rapidanalysis/xerxes/Images/3D Model 3.png

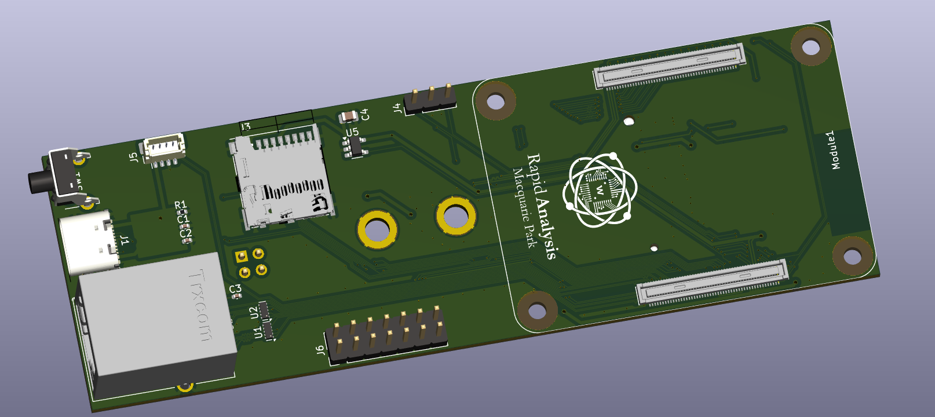
Images/3D Model 3.png
