rapidanalysis/xerxes/Images/3D Model.png

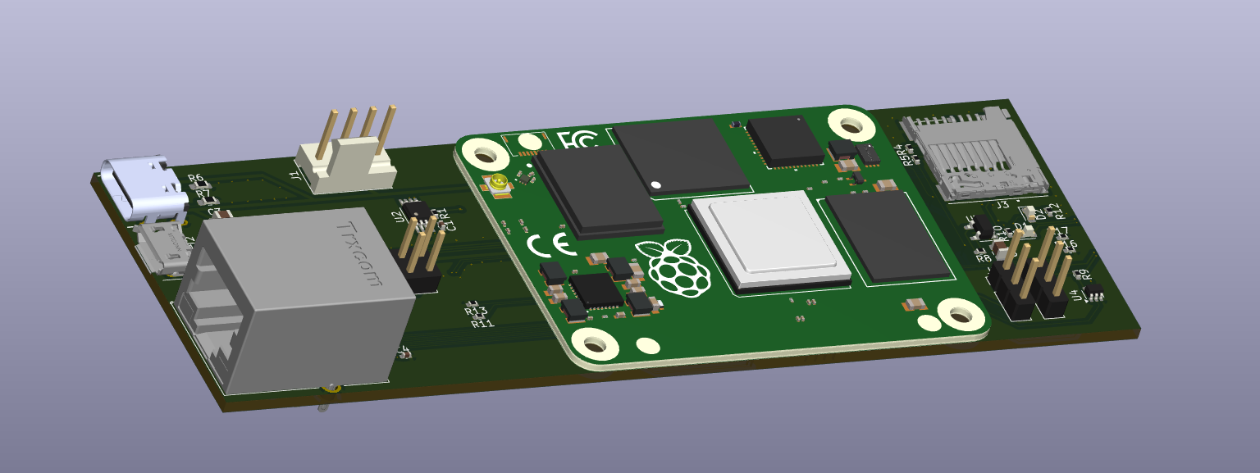
Images/3D Model.png
