rapidanalysis/xerxes/CM4-Baseline/README.md

# blade
Kicad files for the Raspberry Pi CM4 blade design PCB.
