rapidanalysis/xerxes/Images/3D Model 2.png

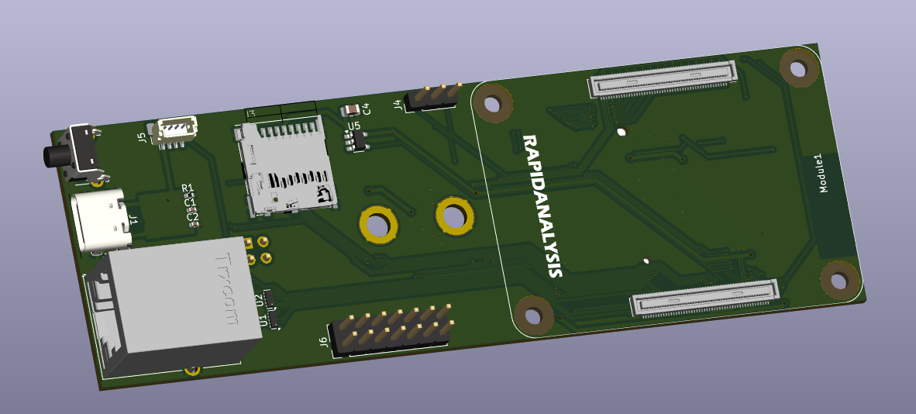
Images/3D Model 2.png
