rapidanalysis/xerxes/Images/Blade Carrier Board/RayTracing White BG/NEW/Bottom.png

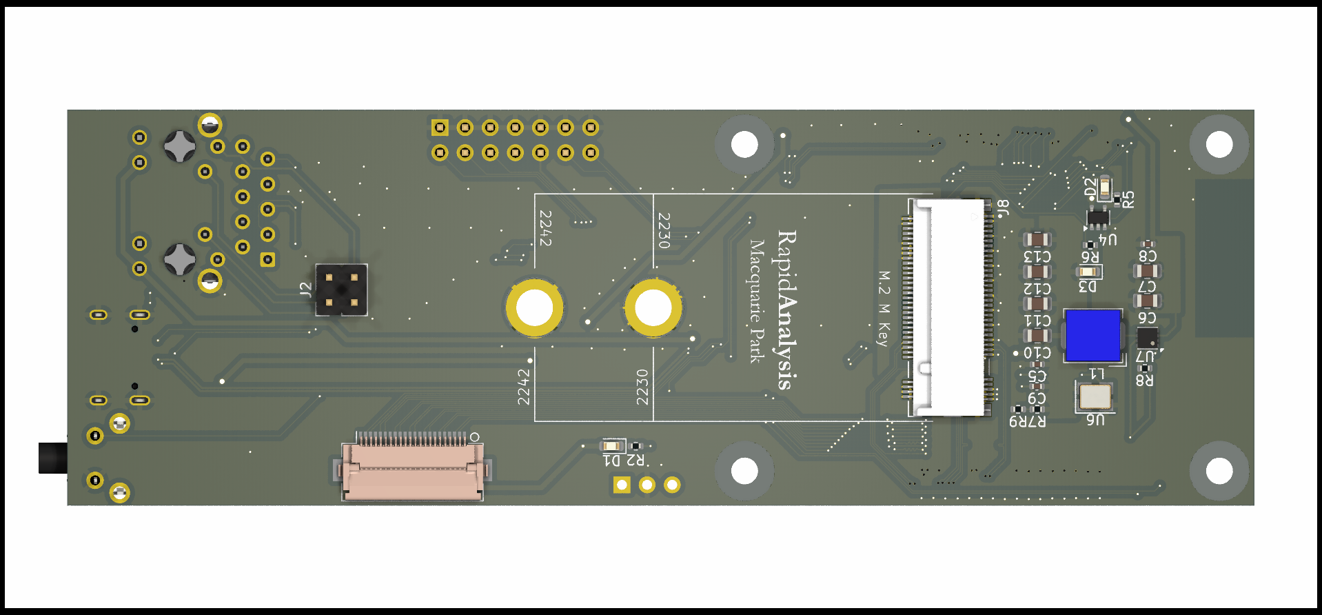
Images/Blade Carrier Board/RayTracing White BG/NEW/Bottom.png
