rapidanalysis/xerxes/Images/Blade Carrier Board/RayTracing White BG/NEW/Front.png

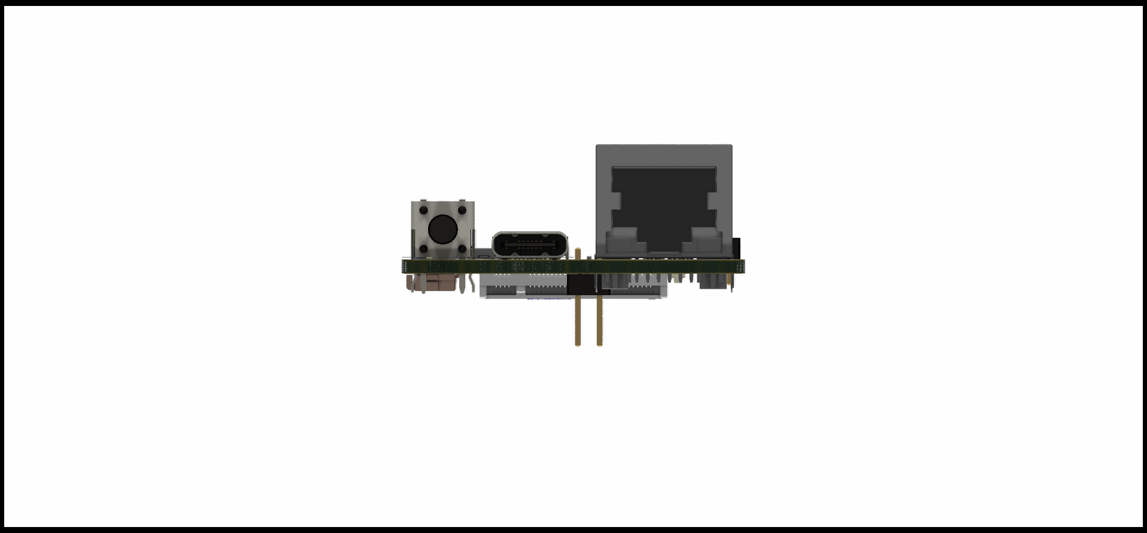
Images/Blade Carrier Board/RayTracing White BG/NEW/Front.png
