rapidanalysis/xerxes/Images/Blade Carrier Board/RayTracing White BG/NEW/Isometric Bottom.png

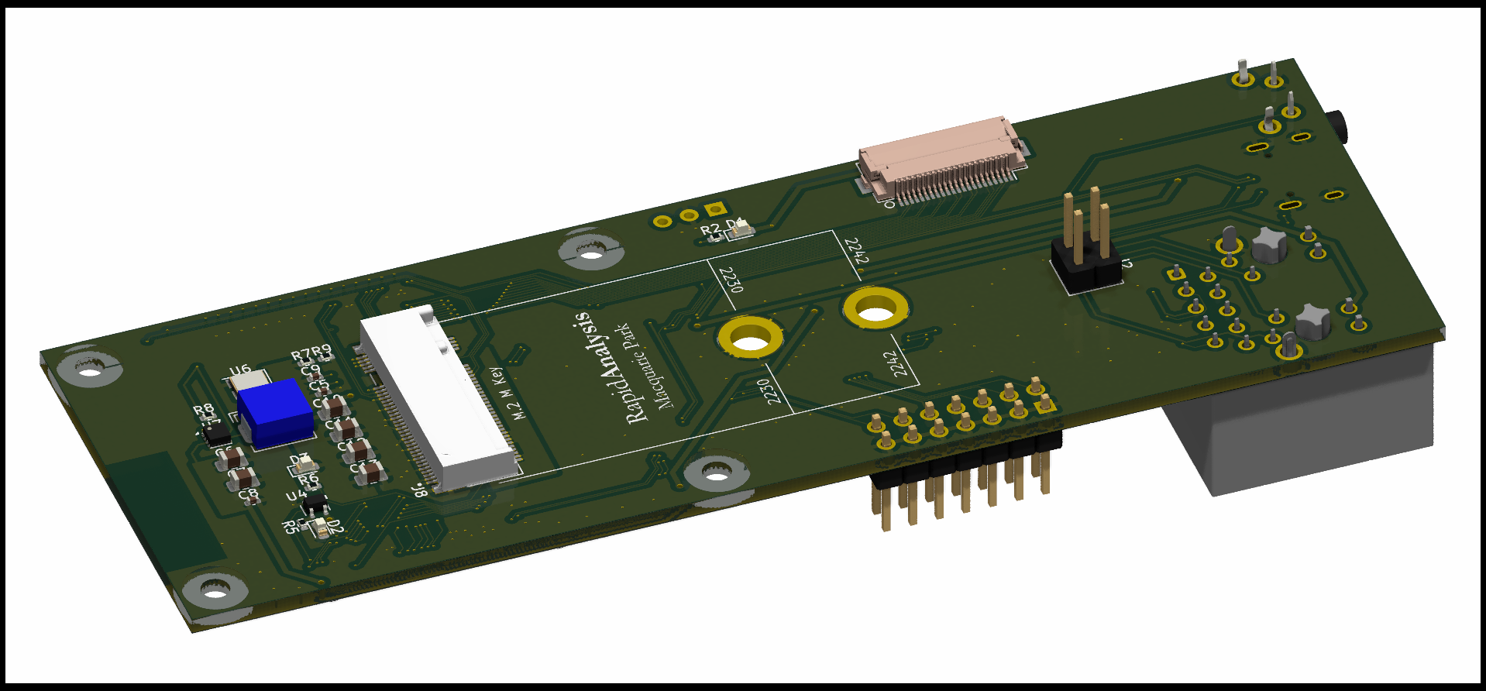
Images/Blade Carrier Board/RayTracing White BG/NEW/Isometric Bottom.png
