rapidanalysis/xerxes/Images/Blade Carrier Board/RayTracing White BG/NEW/Isometric Top.png

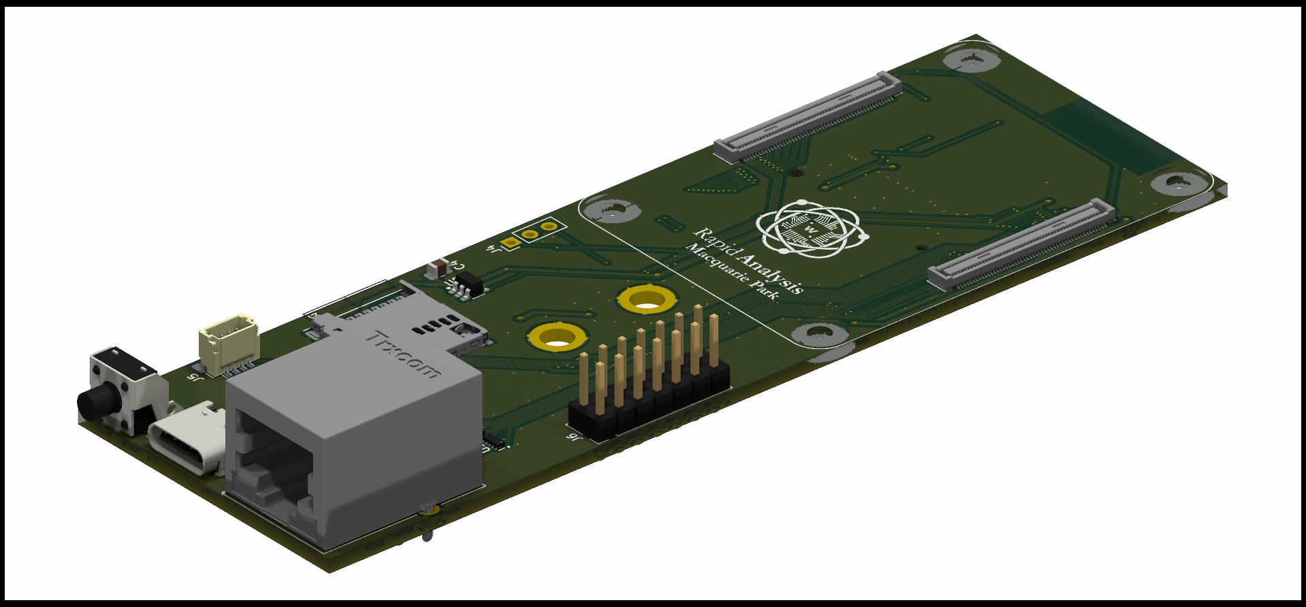
Images/Blade Carrier Board/RayTracing White BG/NEW/Isometric Top.png
