rapidanalysis/xerxes/Images/Blade Carrier Board/RayTracing White BG/NEW/Side.png

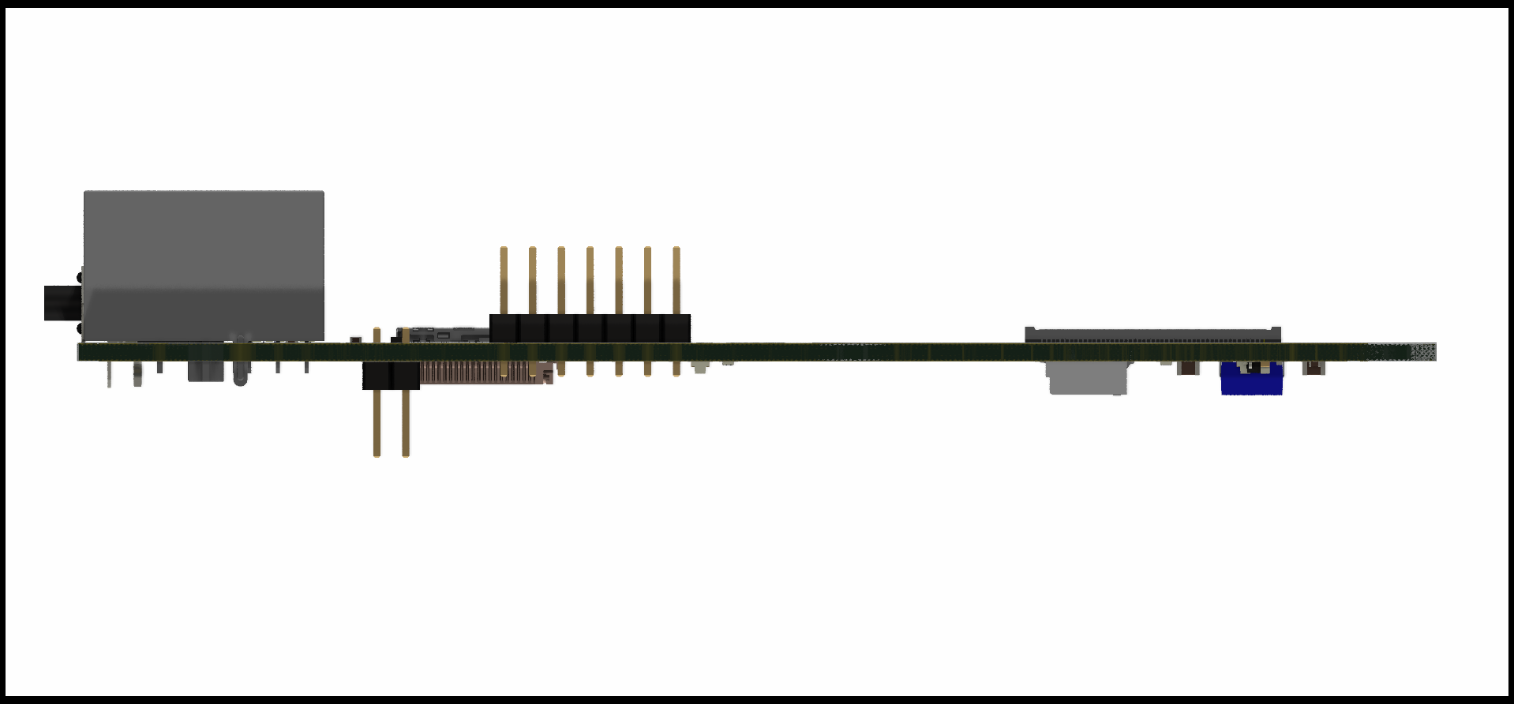
Images/Blade Carrier Board/RayTracing White BG/NEW/Side.png
