rapidanalysis/xerxes/Images/Blade Carrier Board/RayTracing White BG/NEW/Top.png

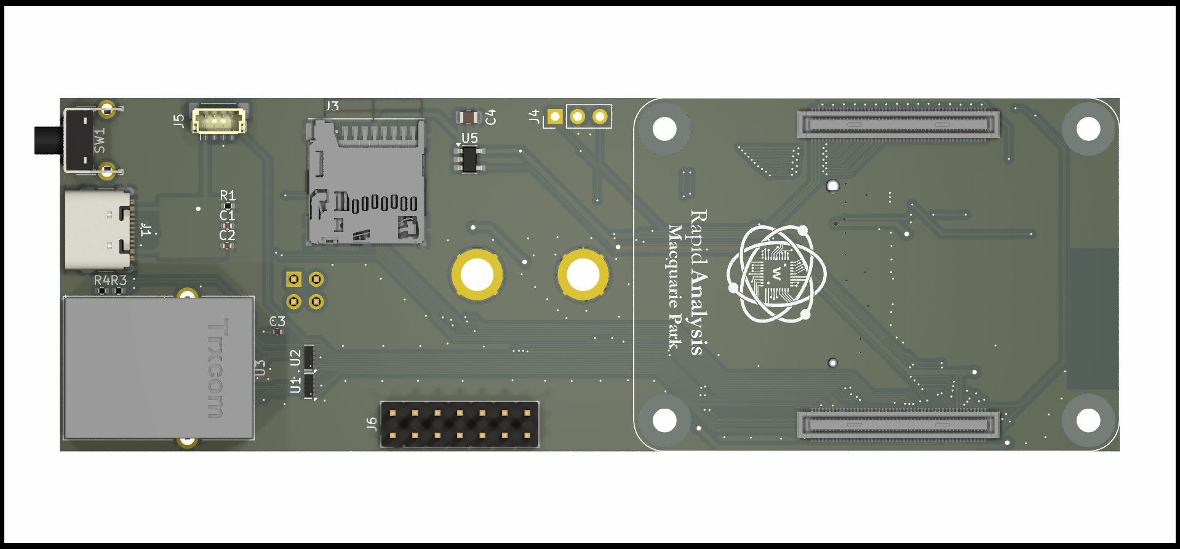
Images/Blade Carrier Board/RayTracing White BG/NEW/Top.png
