rapidanalysis/xerxes/Images/Blade Carrier Board/RayTracing White BG/Raytracing Transparent BG/Bottom.png

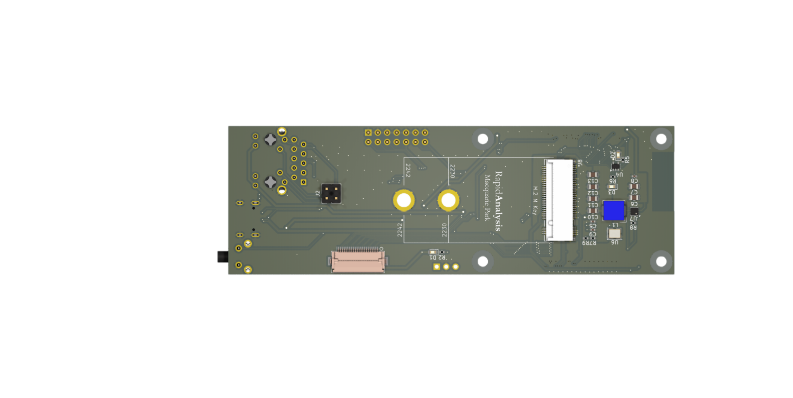
Images/Blade Carrier Board/RayTracing White BG/Raytracing Transparent BG/Bottom.png
