rapidanalysis/xerxes/Images/Blade Carrier Board/RayTracing White BG/Raytracing Transparent BG/Front.png

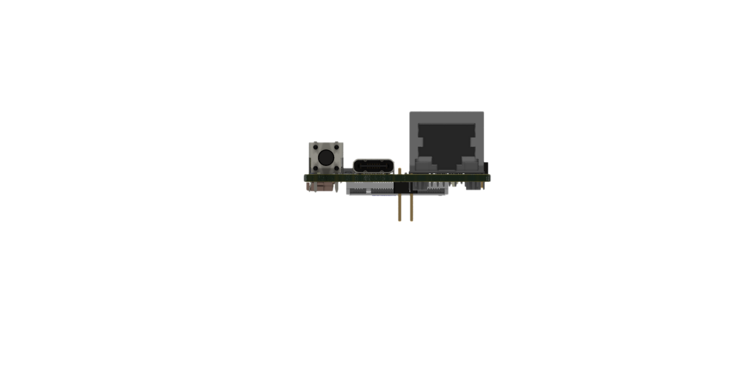
Images/Blade Carrier Board/RayTracing White BG/Raytracing Transparent BG/Front.png
