rapidanalysis/xerxes/Images/Blade Carrier Board/RayTracing White BG/Raytracing Transparent BG/Isometric Bottom.png

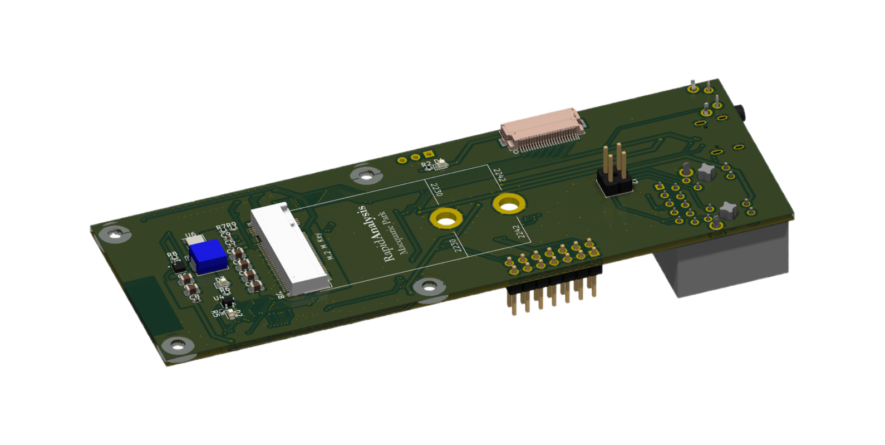
Images/Blade Carrier Board/RayTracing White BG/Raytracing Transparent BG/Isometric Bottom.png
