rapidanalysis/xerxes/Images/Blade Carrier Board/RayTracing White BG/Raytracing Transparent BG/Isometric Top.png

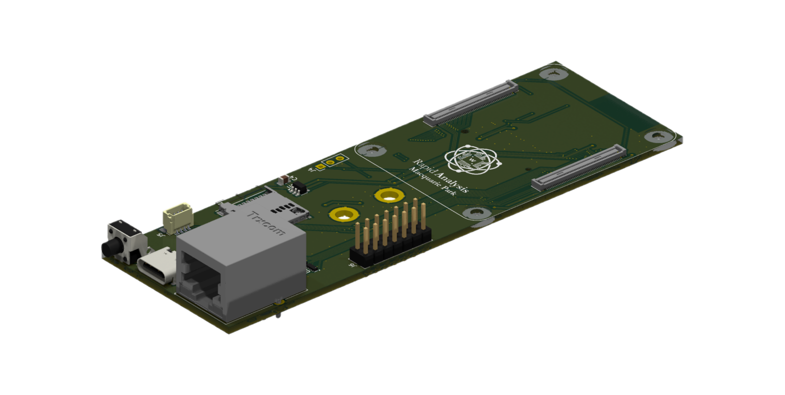
Images/Blade Carrier Board/RayTracing White BG/Raytracing Transparent BG/Isometric Top.png
