rapidanalysis/xerxes/Images/Blade Carrier Board/RayTracing White BG/Raytracing Transparent BG/Side.png

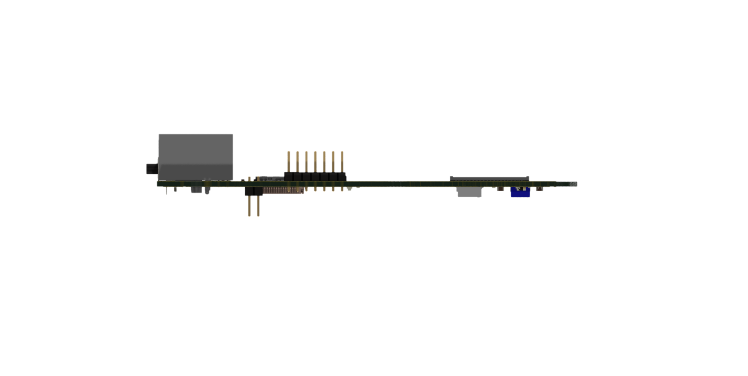
Images/Blade Carrier Board/RayTracing White BG/Raytracing Transparent BG/Side.png
