rapidanalysis/xerxes/Images/Blade Carrier Board/RayTracing White BG/Raytracing Transparent BG/Top.png

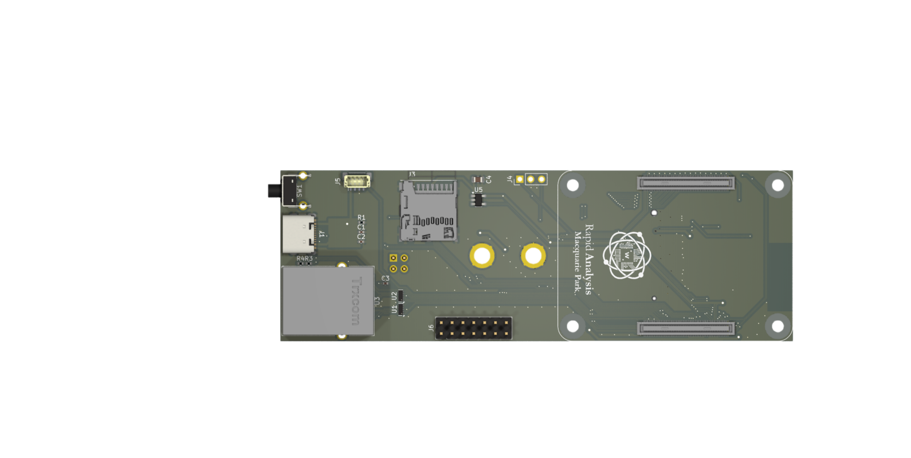
Images/Blade Carrier Board/RayTracing White BG/Raytracing Transparent BG/Top.png
