rapidanalysis/xerxes/Images/Dimensions.png

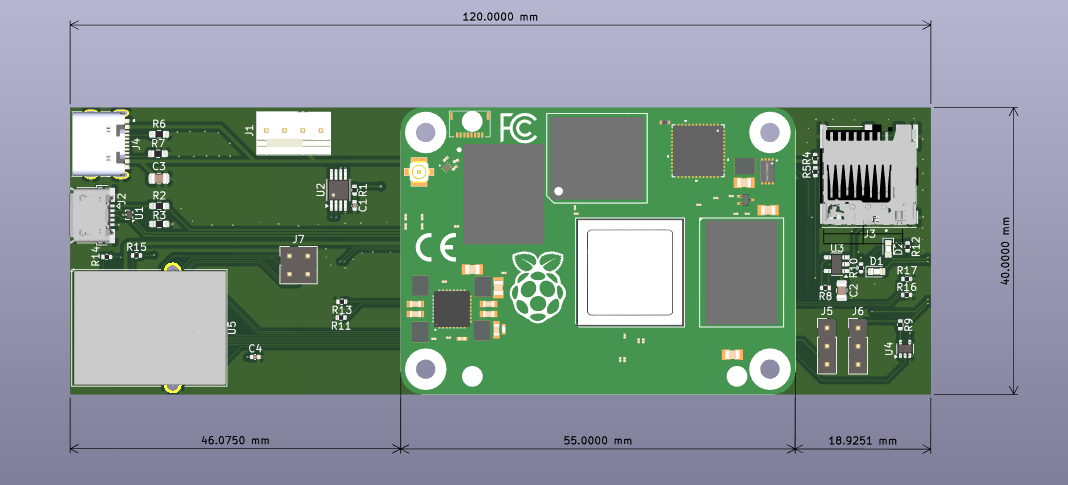
Images/Dimensions.png
