rapidanalysis/xerxes/Images/graphics.png

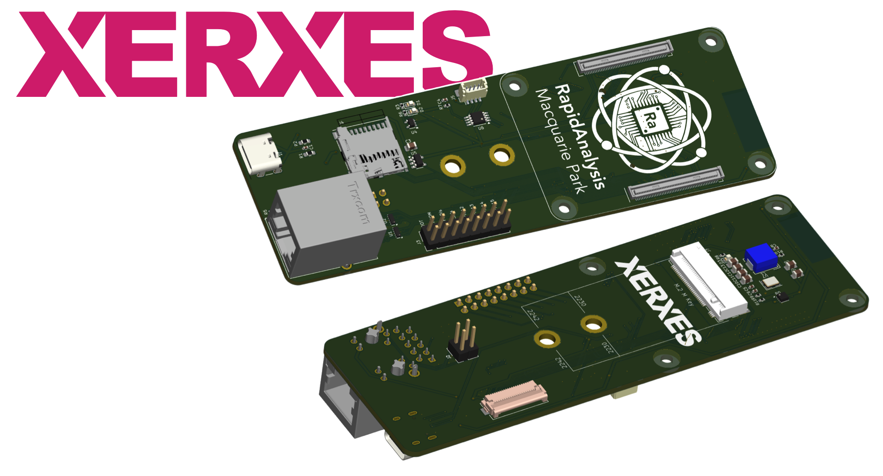
Images/graphics.png
