rapidanalysis/xerxes/Images/kicad.png

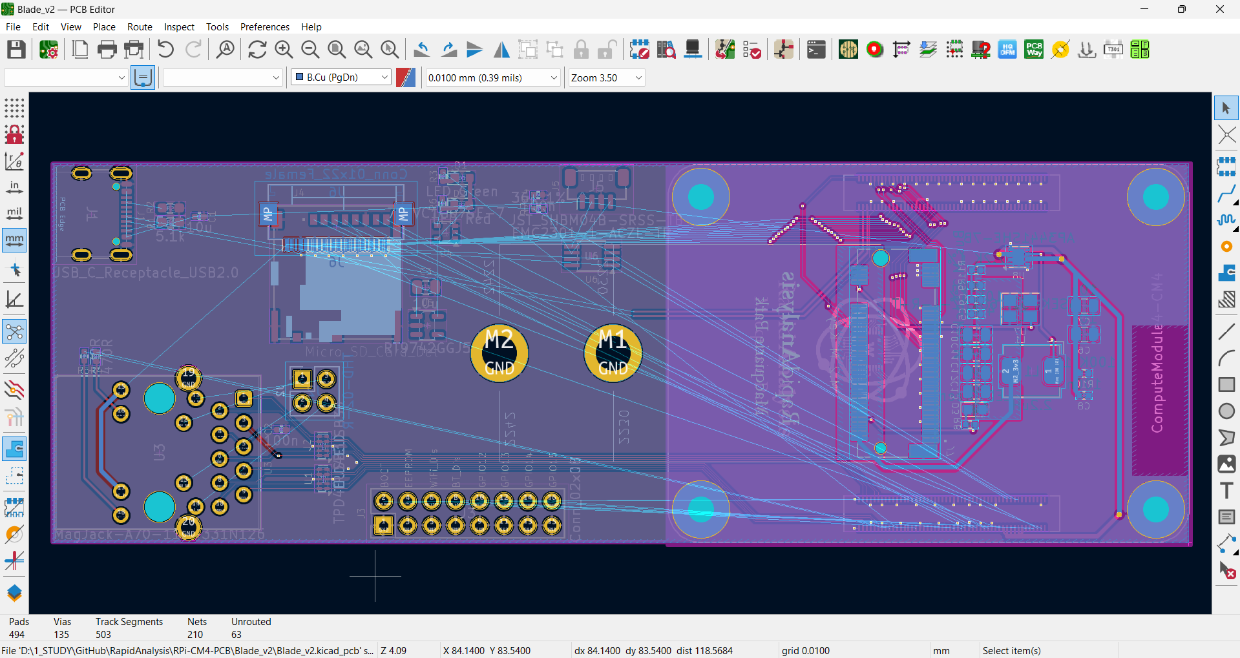
Images/kicad.png
