rapidanalysis/xerxes/Xerxes/production/JLC/bom-JLCPCB Assembly Order.xls

JLCPCB BOM Tool - BOM Matching
BOM name：bom-JLCPCB Assembly Order.xlsx |  |  | Download Time：2025-12-12 11:15:52 |  |  |  | * Our matching results are updated in real-time, but stock and prices may change. If it's been over 24 hours, please re-match before placing your order.
PCB Assembled Qty：5 |  |  | Est. Total Price：60.6161
Your BOM |  |  |  |  | Matched Parts |  |  |  |  |  |  | Order Information
Top Designator | Bottom Designator | Comment | Footprint | JLCPCB Part # | Matches | Part # | Manufacturer | Footprint | Description | Category | Warning | JLCPCB Part # | Product link | Lib Type | Qty | Source | Total Price ($)
C3 |  | 16SVPK220M | CAP_16SVPK220M |  | Select by System | 16SVPK220M | PANASONIC | SMD,D6.3xL6mm | -55℃~+125℃ 1000hrs@125℃ 16V 220uF 22mΩ 52mA@120Hz 6.3mm 6mm Polymer ±20% SMD,D6.3xL6mm Polymer Aluminum Capacitors ROHS | Polymer Aluminum Capacitors |  | C542293 | https://jlcpcb.com/partdetail/PANASONIC-16SVPK220M/C542293 | Extended | 5 | 5 JLCPCB | 2.505
 | C9 | 4.7nF | 0402 |  | Select by System | 0402B472K500NT | FH (Guangdong Fenghua Advanced Tech) | 0402 | 4.7nF 50V X7R ±10% 0402 Multilayer Ceramic Capacitors MLCC - SMD/SMT ROHS | Multilayer Ceramic Capacitors MLCC - SMD/SMT |  | C1538 | https://jlcpcb.com/partdetail/1890-0402B472K500NT/C1538 | Basic | 20 | 20 JLCPCB | 0.022
C2 | C1,C10,C11,C12,C13,C6,C7 | 10uF | 0805 |  | Select by System | CL21A106KAYNNNE | Samsung Electro-Mechanics | 0805 | 10uF 25V X5R ±10% 0805 Multilayer Ceramic Capacitors MLCC - SMD/SMT ROHS | Multilayer Ceramic Capacitors MLCC - SMD/SMT |  | C15850 | https://jlcpcb.com/partdetail/16532-CL21A106KAYNNNE/C15850 | Basic | 65 | 65 JLCPCB | 0.637
C4 | C5,C8 | 100nF | 0402 |  | Select by System | CL05B104KO5NNNC | Samsung Electro-Mechanics | 0402 | 100nF 16V X7R ±10% 0402 Multilayer Ceramic Capacitors MLCC - SMD/SMT ROHS | Multilayer Ceramic Capacitors MLCC - SMD/SMT |  | C1525 | https://jlcpcb.com/partdetail/1877-CL05B104KO5NNNC/C1525 | Basic | 40 | 40 JLCPCB | 0.048
CONN1 |  | ComputeModule5GPIOrail | CONN_DF40C-100DS-0.4V51_HIR |  | Unconfirmed | DF40C-100DS-0.4V(51) | HRS(Hirose) | SMD,P=0.4mm | -35℃~+85℃ 0.4mm 100P 2 300mA Gold Slot Type Butting Surface Mount,Vertical SMD,P=0.4mm Board-to-Board and Backplane Connector ROHS | Board-To-Board And Backplane Connector | 1.Multiple lines in the BOM have been matched to the same part. Please check if the matching is correct. ; | C597931 | https://jlcpcb.com/partdetail/HRS_Hirose-DF40C_100DS_0_4V_51/C597931 | Extended | 10 | 10 JLCPCB | 7.44
CONN2 |  | ComputeModule5HighSpeedrail | CONN_DF40C-100DS-0.4V51_HIR |  | Unconfirmed | DF40C-100DS-0.4V(51) | HRS(Hirose) | SMD,P=0.4mm | -35℃~+85℃ 0.4mm 100P 2 300mA Gold Slot Type Butting Surface Mount,Vertical SMD,P=0.4mm Board-to-Board and Backplane Connector ROHS | Board-To-Board And Backplane Connector | 1.Multiple lines in the BOM have been matched to the same part. Please check if the matching is correct. ; | C597931 | https://jlcpcb.com/partdetail/HRS_Hirose-DF40C_100DS_0_4V_51/C597931 | Extended | 10 | 10 JLCPCB | 7.44
D2 |  | LEDRed | 0603 |  | Select by System | KT-0603R | Hubei KENTO Elec | 0603 | -40℃~+85℃ 120° 2.4V 20mA 300mcd 40mW 615nm~630nm 645nm Red Water Clear 0603 LED Indication - Discrete ROHS | LED Indication - Discrete |  | C2286 | https://jlcpcb.com/partdetail/Hubei_KENTOElec-KT0603R/C2286 | Basic | 20 | 20 JLCPCB | 0.112
 | D4,D5 | MB6S | TO-269AA |  | Select by System | MB6S | Shikues | MBS | -55℃~+150℃ 1.1V@0.8A 30A 5uA@600V 600V 800mA Single-Phase Rectifier MBS Bridge Rectifiers ROHS | Bridge Rectifiers |  | C110220 | https://jlcpcb.com/partdetail/Shikues-MB6S/C110220 | Extended | 11 | 11 JLCPCB | 0.2442
 | D6 | SMAJ58A | D_SMA |  | Select by System | SMAJ58A | RUILON(Shenzhen Ruilongyuan Elec) | DO-214AC(SMA) | -55℃~+150℃ 1uA 4.3A 400W@10/1000us 58V 74.1V 93.6V IEC 61000-4-2 TVS Unidirectional DO-214AC(SMA) ESD and Surge Protection (TVS/ESD) ROHS | ESD And Surge Protection (TVS/ESD) |  | C10762 | https://jlcpcb.com/partdetail/11306-SMAJ58A/C10762 | Extended | 9 | 9 JLCPCB | 0.6183
D3 | D1 | LEDGreen | 0603 |  | Unconfirmed | XL-1608UGC-04 | XINGLIGHT | 0603 | -40℃~+85℃ 120° 20mA 3.3V 515nm~535nm 525nm 70mW 810mcd Discrete Diode Emerald Green Water Clear op View Mount 0603 LED Indication - Discrete ROHS | LED Indication - Discrete | 1.The comment (XL-1608UGC-04) of this part does not match the one (LEDGreen) provided in your BOM. Please confirm; | C965804 | https://jlcpcb.com/partdetail/XINGLIGHT-XL_1608UGC04/C965804 | Extended | 40 | 40 JLCPCB | 0.176
 | J1 | Micro_SD_Card_Det | SDCARD_MOLEX_503398-1892 |  | Select by System | 5033981892 | MOLEX | SMD | -25℃~+85℃ 1.28mm Connector and Ejector MicroSD Card (TF Card) Push-Push SMD SD Card / Memory Card Connector ROHS | SD Card / Memory Card Connector |  | C428492 | https://jlcpcb.com/partdetail/MOLEX-5033981892/C428492 | Extended | 5 | 5 JLCPCB | 4.4475
J2 |  | USB_C_Receptacle_USB2.0_16P | USB4205-GF-A |  | Select by System | TYPEC-305-ACP16 | XUNPU | SMD | -55℃~+85℃ 1 10000 Cycles 14mm 16P 5A Black Female Side View Mount Type-C USB 3.1 SMD USB Connectors ROHS | USB Connectors |  | C920227 | https://jlcpcb.com/partdetail/XUNPU-TYPEC_305ACP16/C920227 | Extended | 5 | 5 JLCPCB | 2.955
 | J3 | Bus_M.2_Socket_M | M.2MKeysocket |  | Select by System | 91302-32-067RDM | UMAX | SMD,P=0.5mm,卧贴 | 3.2mm 67P Female M.2-M Key Surface Mount, Right Angle with locating pin SMD,P=0.5mm,Surface Mount，Right Angle Hard Disk Connector (SAS/SATA/M.2) ROHS | Edgeboard Connectors |  | C1509730 | https://jlcpcb.com/partdetail/UMAX-91302_32067RDM/C1509730 | Extended | 5 | 5 JLCPCB | 7.8675
J6,J7 |  | BM04B-SRSS-TBLFSN | JST_SH_BM04B-SRSS-TB_1x04-1MP_P1.00mm_Vertical |  | Select by System | BM04B-SRSS-TB(LF)(SN) | JST | SMD,P=1mm | -25℃~+85℃ 1 1A 1mm 1x4P 3.6mm 4 4.25mm 4P 50V 6mm Auxiliary Solder Pin Copper Alloy PA SR Surface Mount,Vertical Tin UL94V-0 White SMD,P=1mm Wire To Board Connector ROHS | Wire To Board Connector |  | C160390 | https://jlcpcb.com/partdetail/JST-BM04B_SRSS_TB_LF_SN/C160390 | Extended | 10 | 10 JLCPCB | 2.159
J8 |  | BM03B-SRSS-TBLFSN | JST_SH_BM03B-SRSS-TB_1x03-1MP_P1.00mm_Vertical |  | Select by System | BM03B-SRSS-TB(LF)(SN) | JST | SMD,P=1mm | -25℃~+85℃ 1 1A 1mm 1x3P 3 3.6mm 3P 4.25mm 50V 5mm Auxiliary Solder Pin Copper Alloy PA SH Surface Mount,Vertical Tin UL94V-0 White SMD,P=1mm Wire To Board Connector ROHS | Wire To Board Connector |  | C160389 | https://jlcpcb.com/partdetail/JST-BM03B_SRSS_TB_LF_SN/C160389 | Extended | 5 | 5 JLCPCB | 1.0855
J9 |  | BM06B-SRSS-TBLFSN | CONN_BM06B-SRSS-TB_JST |  | Select by System | BM06B-SRSS-TB(LF)(SN) | JST | SMD,P=1mm | -25℃~+85℃ 1 1A 1mm 1x6P 3.6mm 4.25mm 50V 6 6P 8mm Auxiliary Solder Pin Copper Alloy PA SH Surface Mount,Vertical Tin UL94V-0 White SMD,P=1mm Wire To Board Connector ROHS | Wire To Board Connector |  | C160392 | https://jlcpcb.com/partdetail/JST-BM06B_SRSS_TB_LF_SN/C160392 | Extended | 5 | 5 JLCPCB | 1.524
 | J10 | DF40HC(4.0)-50DS-0.4V(51) | HRS_DF40HC_4.0_-50DS-0.4V_51_ |  | Select by System | DF40HC(4.0)-50DS-0.4V(51) | HRS(Hirose) | SMD,P=0.4mm | 0.4mm 2 50P Gold Slot Type Butting Surface Mount,Vertical SMD,P=0.4mm Board-to-Board and Backplane Connector ROHS | Board-To-Board And Backplane Connector |  | C5338326 | https://jlcpcb.com/partdetail/HRS_Hirose-DF40HC_4_0_50DS_0_4V_51/C5338326 | Extended | 5 | 5 JLCPCB | 8.025
 | L1 | 2.2uH | L_Bourns_SRP5030CC |  | Select by System | SMNR4020-2.2UH | SXN(Shun Xiang Nuo Elec) | SMD,4x4mm | 2.2uH 3.4A 3.4A 46mΩ ±20% SMD,4x4mm Power Inductors ROHS | Power Inductors |  | C135262 | https://jlcpcb.com/partdetail/146573-SMNR4020_22UH/C135262 | Extended | 9 | 9 JLCPCB | 0.4392
 | R2 | 12K1% | 0402 |  | Unconfirmed | FRC0402F1202TS | FOJAN | 0402 | -55℃~+155℃ 12kΩ 50V 62.5mW Thick Film Resistor ±1% ±100ppm/℃ 0402 Chip Resistor - Surface Mount ROHS | Chip Resistor - Surface Mount | 1.The comment (FRC0402F1202TS) of this part does not match the one (12K1%) provided in your BOM. Please confirm; | C2909316 | https://jlcpcb.com/partdetail/FOJAN-FRC0402F1202TS/C2909316 | Extended | 20 | 20 JLCPCB | 0.01
R6,R7 |  | 470R | 0402 |  | Unconfirmed | 0402WGF4700TCE | UNI-ROYAL(Uniroyal Elec) | 0402 | -55℃~+155℃ 470Ω 50V 62.5mW Thick Film Resistor ±1% ±100ppm/℃ 0402 Chip Resistor - Surface Mount ROHS | Chip Resistor - Surface Mount | 1.The comment (0402WGF4700TCE) of this part does not match the one (470R) provided in your BOM. Please confirm; | C25117 | https://jlcpcb.com/partdetail/25860-0402WGF4700TCE/C25117 | Basic | 20 | 20 JLCPCB | 0.012
 | R8 | 10K1% | 0402 |  | Unconfirmed | RHC-02K1002FT | FH (Guangdong Fenghua Advanced Tech) | 0402 | 10kΩ 50V 62.5mW Thick Film Resistor ±1% ±100ppm/℃ 0402 Chip Resistor - Surface Mount ROHS | Chip Resistor - Surface Mount | 1.The comment (RHC-02K1002FT) of this part does not match the one (10K1%) provided in your BOM. Please confirm; | C2936656 | https://jlcpcb.com/partdetail/3289238-RHC02K1002FT/C2936656 | Extended | 20 | 20 JLCPCB | 0.03
 | R9 | 100K1% | 0402 |  | Unconfirmed | RT0402FRE07100KL | YAGEO | 0402 | -55℃~+155℃ 100kΩ 50V 62.5mW Thin Film Resistor ±1% ±50ppm/℃ 0402 Chip Resistor - Surface Mount ROHS | Chip Resistor - Surface Mount | 1.The comment (RT0402FRE07100KL) of this part does not match the one (100K1%) provided in your BOM. Please confirm; | C728576 | https://jlcpcb.com/partdetail/YAGEO-RT0402FRE07100KL/C728576 | Extended | 20 | 20 JLCPCB | 0.146
R11,R12 | R13,R3 | 1k | 0402 |  | Unconfirmed | 0402WGF1001TCE | UNI-ROYAL(Uniroyal Elec) | 0402 | -55℃~+155℃ 1kΩ 50V 62.5mW Thick Film Resistor ±1% ±100ppm/℃ 0402 Chip Resistor - Surface Mount ROHS | Chip Resistor - Surface Mount | 1.The comment (0402WGF1001TCE) of this part does not match the one (1k) provided in your BOM. Please confirm; | C11702 | https://jlcpcb.com/partdetail/12256-0402WGF1001TCE/C11702 | Basic | 40 | 40 JLCPCB | 0.024
R14,R15 |  | 5.1k | 0603 |  | Unconfirmed | 0603WAF5101T5E | UNI-ROYAL(Uniroyal Elec) | 0603 | -55℃~+155℃ 100mW 5.1kΩ 75V Thick Film Resistor ±1% ±100ppm/℃ 0603 Chip Resistor - Surface Mount ROHS | Chip Resistor - Surface Mount | 1.The comment (0603WAF5101T5E) of this part does not match the one (5.1k) provided in your BOM. Please confirm; | C23186 | https://jlcpcb.com/partdetail/23913-0603WAF5101T5E/C23186 | Basic | 20 | 20 JLCPCB | 0.022
R1 | R10,R4,R5 | 2.2K1% | 0402 |  | Unconfirmed | FRC0402F2201TS | FOJAN | 0402 | -55℃~+155℃ 2.2kΩ 50V 62.5mW Thick Film Resistor ±1% ±100ppm/℃ 0402 Chip Resistor - Surface Mount ROHS | Chip Resistor - Surface Mount | 1.The comment (FRC0402F2201TS) of this part does not match the one (2.2K1%) provided in your BOM. Please confirm; | C2906865 | https://jlcpcb.com/partdetail/FOJAN-FRC0402F2201TS/C2906865 | Extended | 45 | 45 JLCPCB | 0.0225
 | U1 | RT9742GGJ5 | SOT-23-5 |  | Select by System | RT9742GGJ5 | Richtek Tech | TSOT-23-5 | -40℃~+85℃ 1 1A 2.7V~6V 70mΩ Active High High Side Switch Short-Circuit Protection(SCP) TSOT-23-5 Power Distribution Switches ROHS | Power Distribution Switches |  | C250547 | https://jlcpcb.com/partdetail/RichtekTech-RT9742GGJ5/C250547 | Extended | 5 | 5 JLCPCB | 0.6805
 | U2 | ASEK-32.768KHZ-L-R-T | Crystal_SMD_3225-4Pin_3.2x2.5mm |  | Select by System | ASEK-32.768KHZ-LRT | Abracon LLC | SMD3225-4P | -40℃~+85℃ 3.3V 3.5mA 32.768kHz CMOS ±25ppm SMD3225-4P Crystal Oscillators ROHS | Crystal Oscillators |  | C2650753 | https://jlcpcb.com/partdetail/AbraconLLC-ASEK_32_768KHZLRT/C2650753 | Extended | 5 | 5 JLCPCB | 9.105
 | U3 | AP3441SHE-7B | DFN-8-1EP_2x2mm_P0.5mm_EP1.05x1.75mm |  | Select by System | AP3441SHE-7B | Diodes Incorporated | DFN2020-8-EP | -40℃~+85℃@(TA) 1 1MHz 2.7V~5.5V 3A 55uA 600mV~5.5V Adjustable Buck Buck Built-In Yes DFN2020-8-EP DC-DC Converters ROHS | DC-DC Converters |  | C2070918 | https://jlcpcb.com/partdetail/DiodesIncorporated-AP3441SHE7B/C2070918 | Extended | 5 | 5 JLCPCB | 0.756
U5 |  | 74LVC1G07 | SOT-353_SC-70-5 |  | Select by System | 74LVC1G07 | Wuxi I-core Elec | SOT-353 | SOT-353 Buffers, Drivers, Receivers, Transceivers ROHS | Buffers, Drivers, Receivers, Transceivers |  | C5138996 | https://jlcpcb.com/partdetail/Wuxi_I_coreElec-74LVC1G07/C5138996 | Extended | 9 | 9 JLCPCB | 0.4689
U7,U8 |  | CDDFN10-3324P | USON-10_2.5x1.0mm_P0.5mm |  | Select by System | CDDFN10-3324P | BOURNS | DFN-10(1x2.5) | -55℃~+85℃ 0.04pF 100nA 3.3V 30W 4 4.5V 4A@8/20us 7.5V IEC 61000-4-2 TVS DFN-10(1x2.5) ESD and Surge Protection (TVS/ESD) ROHS | ESD And Surge Protection (TVS/ESD) |  | C913227 | https://jlcpcb.com/partdetail/BOURNS-CDDFN103324P/C913227 | Extended | 10 | 10 JLCPCB | 1.594
