rapidanalysis/xerxes/V1/Outputs/Schematics/cm4-bare-minimum.pdf

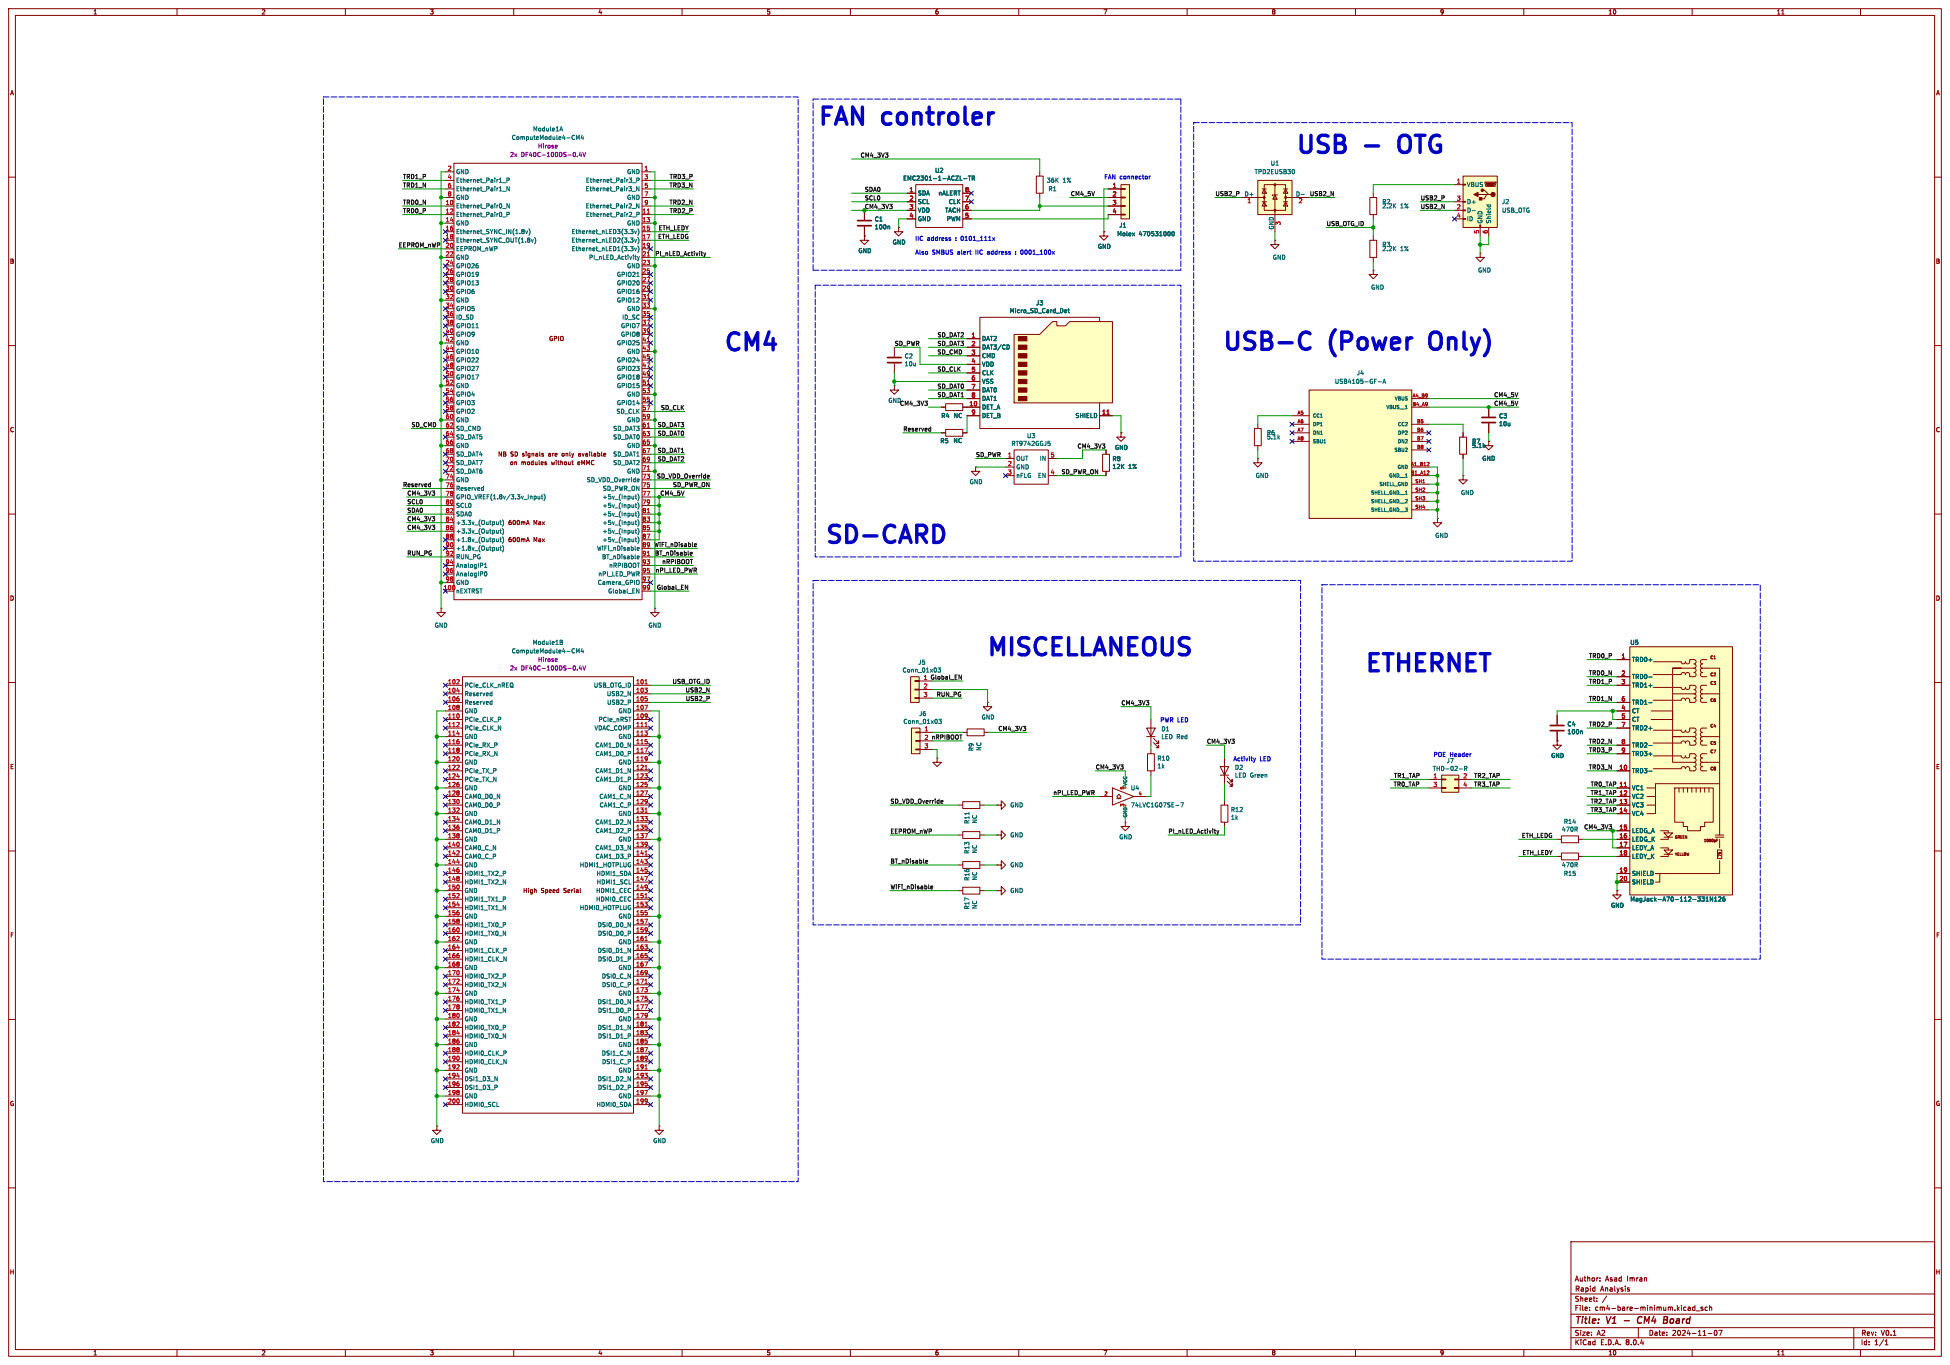
[picture p19: page 1]

Also SMBUS alert IIC address : 0001_100x

600mA Max 600mA Max NB SD signals are only available
