rapidanalysis/xerxes/Xerxes/Xerxes.kicad_pcb

## KiCad design Xerxes/Xerxes.kicad_pcb (2025-12-12)

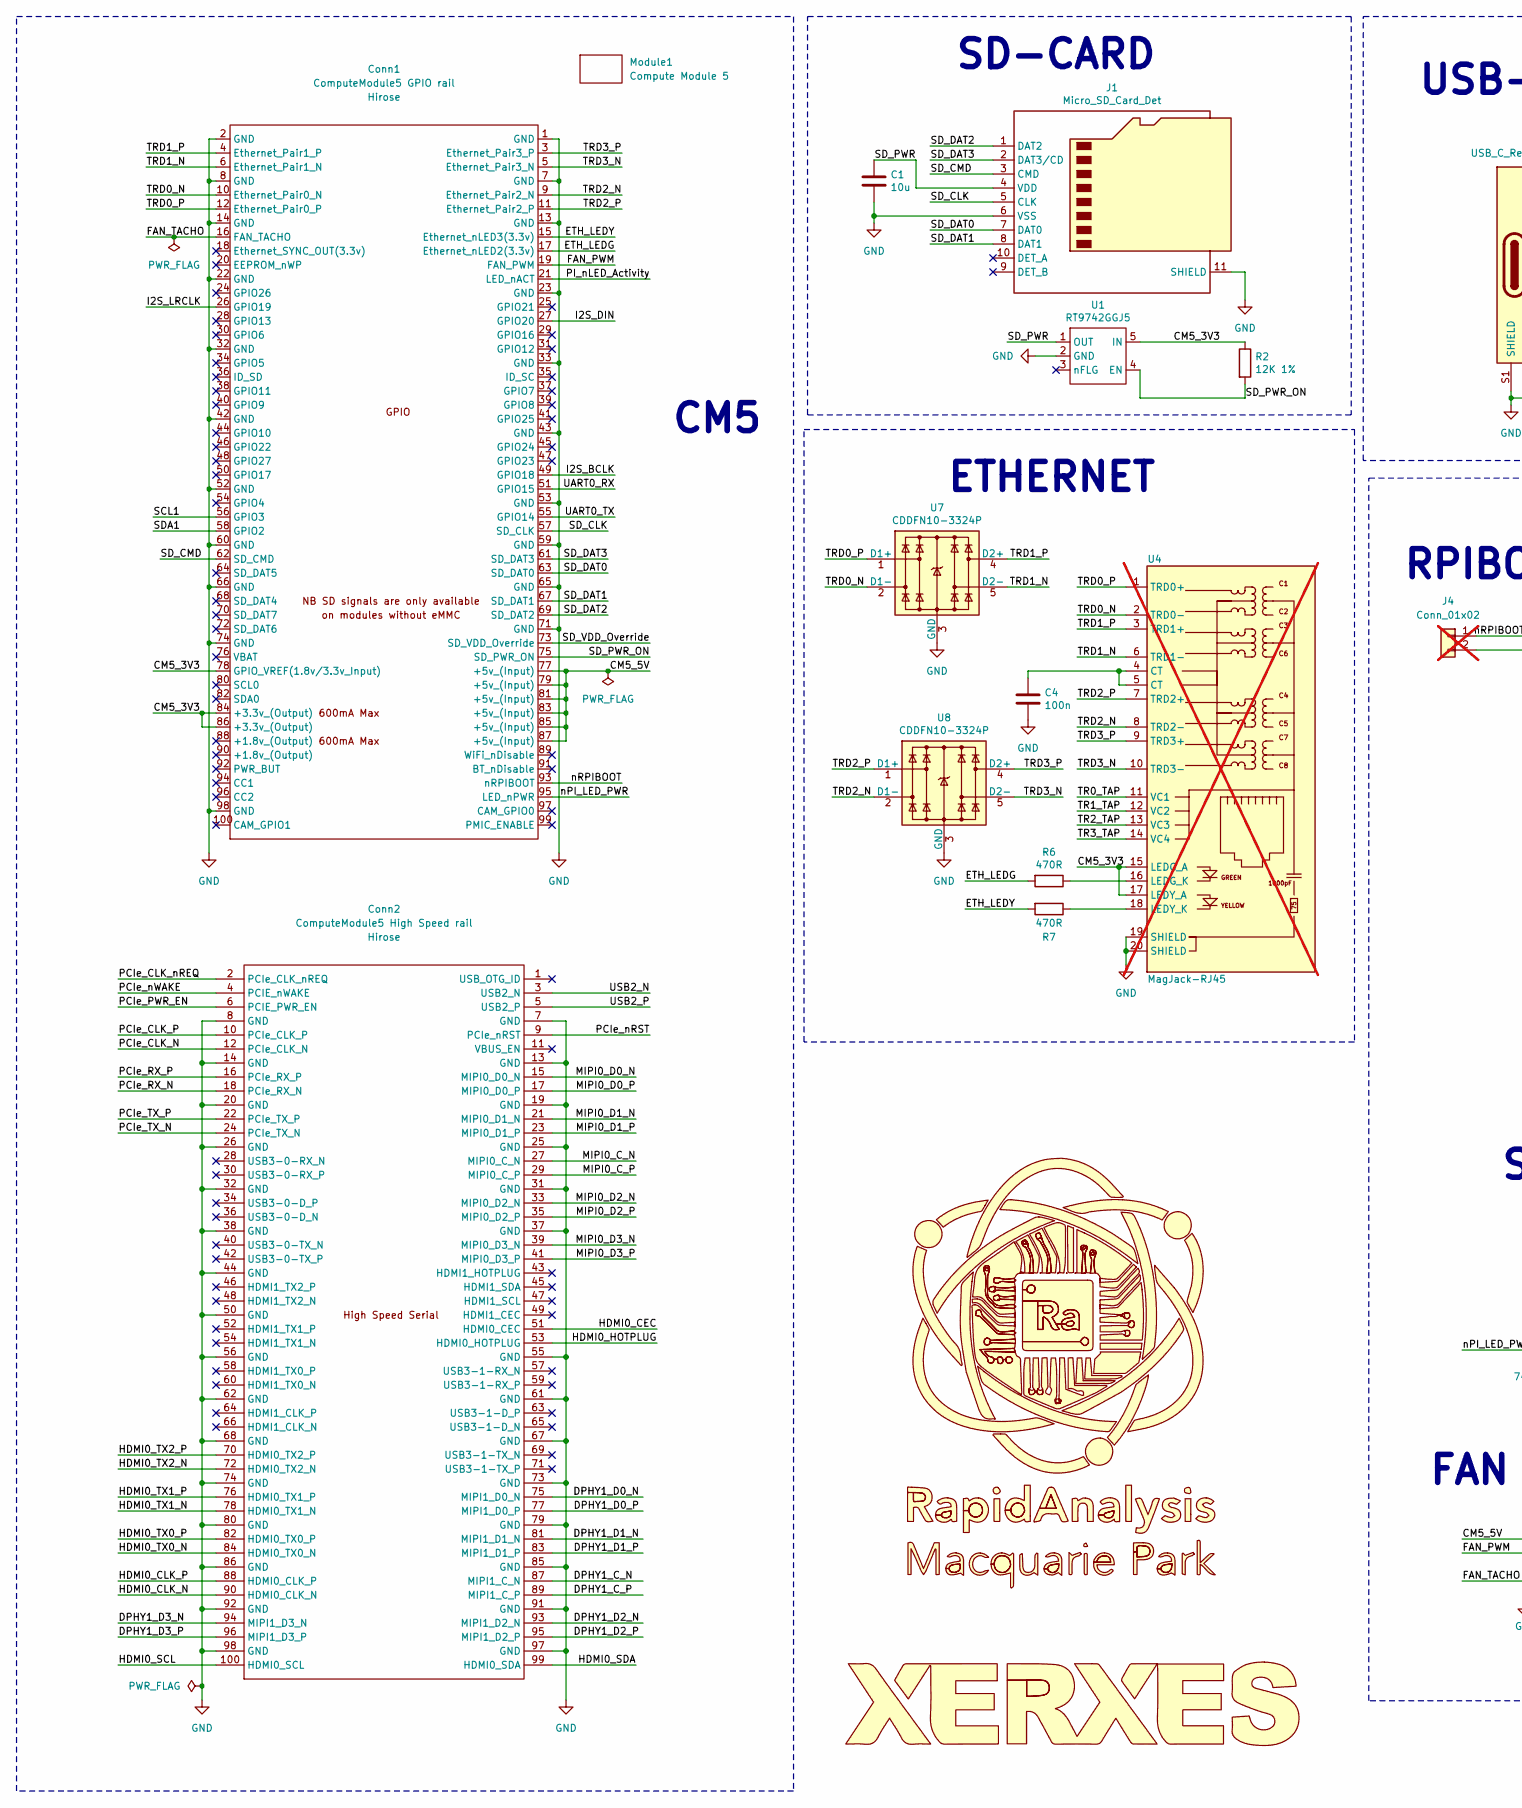
[picture p20: schematic Xerxes.kicad_sch, Xerxes-Pi, part in row 1, column 1]

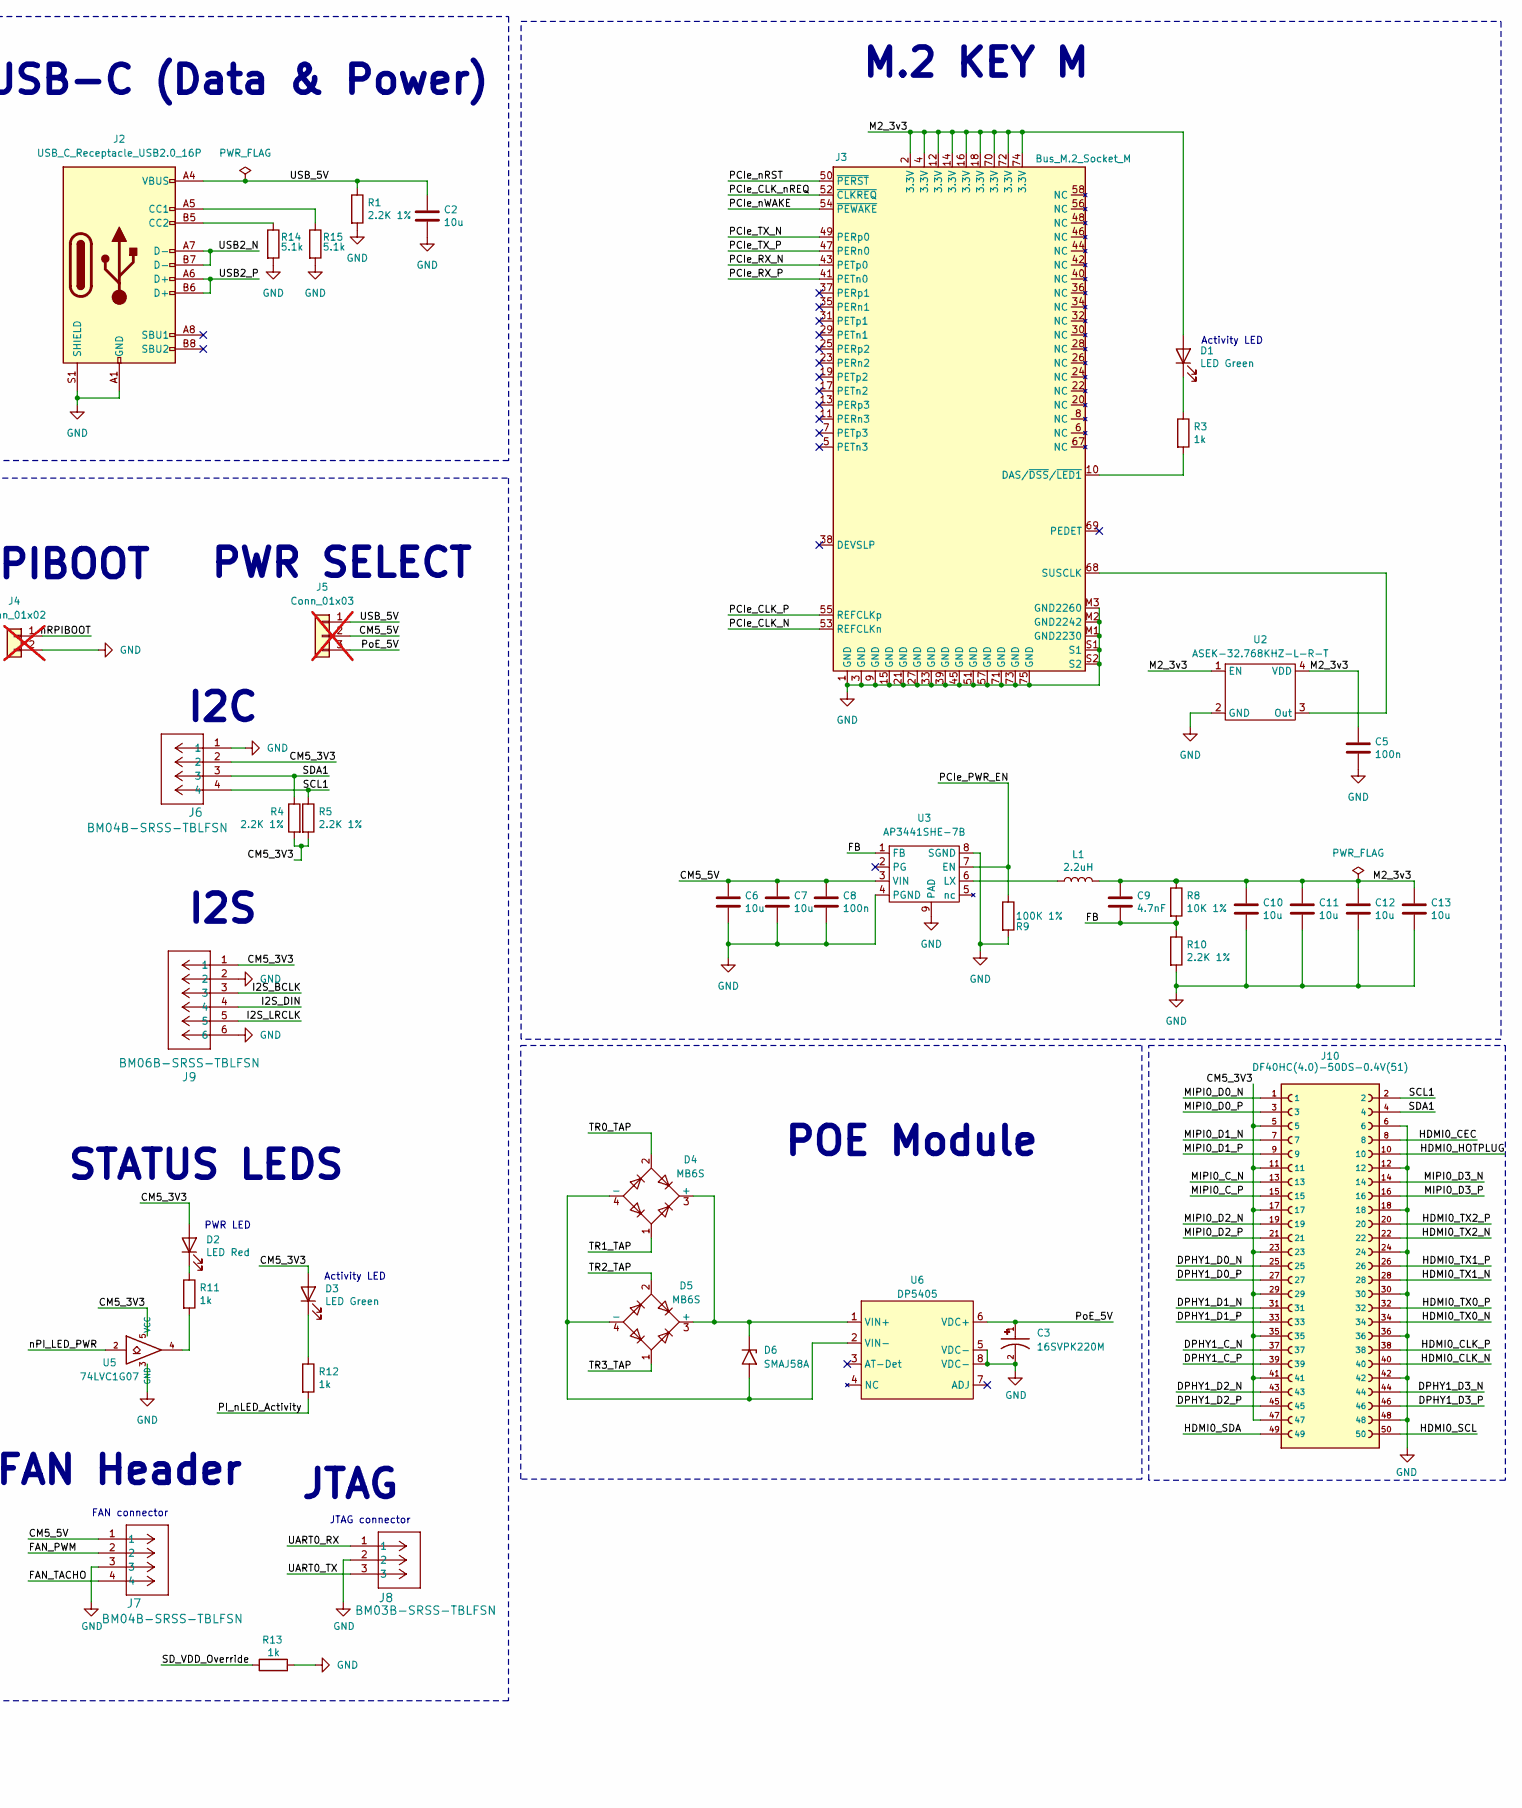
[picture p21: schematic Xerxes.kicad_sch, Xerxes-Pi, part in row 1, column 2]

Parts:
C1, C2, C6, C7, C10, C11, C12, C13: 10u; C_0805_2012Metric; MPN GRM21BR71A106KA73L
C3: 16SVPK220M; CAP_16SVPK220M; MPN 16SVPK220M
C4, C5, C8: 100n; C_0402_1005Metric; MPN EMK105B7104KV-F
C9: 4.7nF; C_0402_1005Metric; MPN CC0402KRX7R9BB472
Conn1: ComputeModule5 GPIO rail; CONN_DF40C-100DS-0.4V51_HIR; MPN DF40C-100DS-0.4V(51)
Conn2: ComputeModule5 High Speed rail; CONN_DF40C-100DS-0.4V51_HIR; MPN DF40C-100DS-0.4V(51)
D1, D3: LED Green; LED_0603_1608Metric; MPN LTST-C190GKT
D2: LED Red; LED_0603_1608Metric; MPN LTST-C190KRKT
D4, D5: MB6S; TO-269AA; MPN MB6S
D6: SMAJ58A; D_SMA; MPN SMAJ58A
J1: Micro_SD_Card_Det; SDCARD_MOLEX_503398-1892; MPN 5033981892
J2: USB_C_Receptacle_USB2.0_16P; USB4205-GF-A; MPN USB4205-GF-A
J3: Bus_M.2_Socket_M; M.2 M Key socket; MPN MDT320M03001
J4: Conn_01x02; PinHeader_1x02_P2.54mm_Vertical; MPN G800W306018EU; not fitted
J5: Conn_01x03; PinHeader_1x03_P2.54mm_Vertical; MPN G800W305018EU; not fitted
J6, J7: BM04B-SRSS-TBLFSN; JST_SH_BM04B-SRSS-TB_1x04-1MP_P1.00mm_Vertical; MPN BM04B-SRSS-TBLFSN
J8: BM03B-SRSS-TBLFSN; JST_SH_BM03B-SRSS-TB_1x03-1MP_P1.00mm_Vertical; MPN BM03B-SRSS-TBLFSN
J9: BM06B-SRSS-TBLFSN; CONN_BM06B-SRSS-TB_JST; MPN BM06B-SRSS-TBLFSN
J10: DF40HC(4.0)-50DS-0.4V(51); HRS_DF40HC_4.0_-50DS-0.4V_51_; MPN DF40HC(4.0)-50DS-0.4V(51)
L1: 2.2uH; L_Bourns_SRP5030CC; MPN SRP5030CC-2R2M
Module1: Compute Module 5; Raspberry-Pi-5-Compute-Module
R1, R4, R5, R10: 2.2K 1%; R_0402_1005Metric; MPN RC0402FR-072K2L
R2: 12K 1%; R_0402_1005Metric; MPN RC0402FR-0712KL
R3, R11, R12, R13: 1k; R_0402_1005Metric; MPN RC0402FR-071KL
R6, R7: 470R; R_0402_1005Metric; MPN RC0402FR-07470RL
R8: 10K 1%; R_0402_1005Metric; MPN RC0402FR-0710KL
R9: 100K 1%; R_0402_1005Metric; MPN RC0402FR-07100KL
R14, R15: 5.1k; R_0603_1608Metric; MPN RC0603FR-075K1L
Sym1: Xerxes_Logo
Sym2: RapidAnalysis_Logo
U1: RT9742GGJ5; SOT-23-5; MPN RT9742GGJ5
U2: ASEK-32.768KHZ-L-R-T; Crystal_SMD_3225-4Pin_3.2x2.5mm; MPN ASEK-32.768KHZ-L-R-T
U3: AP3441SHE-7B; DFN-8-1EP_2x2mm_P0.5mm_EP1.05x1.75mm; MPN AP3441SHE-7B
U4: MagJack-RJ45; TRJG0926HENL; MPN LPJG0926HENL; not fitted
U5: 74LVC1G07; SOT-353_SC-70-5; MPN 74LVC1G07
U6: DP5405
U7, U8: CDDFN10-3324P; USON-10_2.5x1.0mm_P0.5mm; MPN CDDFN10-3324P

Connections:
/CM5_3V3: Conn1.78 (GPIO_VREF(1.8v/3.3v_Input)), Conn1.84 (+3.3v_(Output)), Conn1.86 (+3.3v_(Output)), D2.2 (A), D3.2 (A), J6.2, J9.1, J10.5, J10.11, J10.17, J10.23, J10.29, J10.35, J10.41, J10.47, R2.1, R4.2, R5.2, U1.5 (IN), U4.15 (LEDG_A), U4.17 (LEDY_A), U5.5 (VCC)
/CM5_5V: C6.1, C7.1, C8.1, Conn1.77 (+5v_(Input)), Conn1.79 (+5v_(Input)), Conn1.81 (+5v_(Input)), Conn1.83 (+5v_(Input)), Conn1.85 (+5v_(Input)), Conn1.87 (+5v_(Input)), J5.2, J7.1, U3.3 (VIN)
/DPHY1_C_N: Conn2.87 (MIPI1_C_N), J10.37
/DPHY1_C_P: Conn2.89 (MIPI1_C_P), J10.39
/DPHY1_D0_N: Conn2.75 (MIPI1_D0_N), J10.25
/DPHY1_D0_P: Conn2.77 (MIPI1_D0_P), J10.27
/DPHY1_D1_N: Conn2.81 (MIPI1_D1_N), J10.31
/DPHY1_D1_P: Conn2.83 (MIPI1_D1_P), J10.33
/DPHY1_D2_N: Conn2.93 (MIPI1_D2_N), J10.43
/DPHY1_D2_P: Conn2.95 (MIPI1_D2_P), J10.45
/DPHY1_D3_N: Conn2.94 (MIPI1_D3_N), J10.44
/DPHY1_D3_P: Conn2.96 (MIPI1_D3_P), J10.46
/ETH_LEDG: Conn1.17 (Ethernet_nLED2(3.3v)), R6.2
/ETH_LEDY: Conn1.15 (Ethernet_nLED3(3.3v)), R7.2
/FAN_PWM: Conn1.19 (FAN_PWM), J7.2
/FAN_TACHO: Conn1.16 (FAN_TACHO), J7.4
/FB: C9.2, R8.2, R10.1, U3.1 (FB)
/HDMI0_CEC: Conn2.51 (HDMI0_CEC), J10.8
/HDMI0_CLK_N: Conn2.90 (HDMI0_CLK_N), J10.40
/HDMI0_CLK_P: Conn2.88 (HDMI0_CLK_P), J10.38
/HDMI0_HOTPLUG: Conn2.53 (HDMI0_HOTPLUG), J10.10
/HDMI0_SCL: Conn2.100 (HDMI0_SCL), J10.50
/HDMI0_SDA: Conn2.99 (HDMI0_SDA), J10.49
/HDMI0_TX0_N: Conn2.84 (HDMI0_TX0_N), J10.34
/HDMI0_TX0_P: Conn2.82 (HDMI0_TX0_P), J10.32
/HDMI0_TX1_N: Conn2.78 (HDMI0_TX1_N), J10.28
/HDMI0_TX1_P: Conn2.76 (HDMI0_TX1_P), J10.26
/HDMI0_TX2_N: Conn2.72 (HDMI0_TX2_N), J10.22
/HDMI0_TX2_P: Conn2.70 (HDMI0_TX2_P), J10.20
/I2S_BCLK: Conn1.49 (GPIO18), J9.3
/I2S_DIN: Conn1.27 (GPIO20), J9.4
/I2S_LRCLK: Conn1.26 (GPIO19), J9.5
/M2_3v3: C5.1, C9.1, C10.1, C11.1, C12.1, C13.1, D1.2 (A), J3.2 (3.3V), J3.4 (3.3V), J3.12 (3.3V), J3.14 (3.3V), J3.16 (3.3V), J3.18 (3.3V), J3.70 (3.3V), J3.72 (3.3V), J3.74 (3.3V), L1.2, R8.1, U2.1 (EN), U2.4 (VDD)
/MIPI0_C_N: Conn2.27 (MIPI0_C_N), J10.13
/MIPI0_C_P: Conn2.29 (MIPI0_C_P), J10.15
/MIPI0_D0_N: Conn2.15 (MIPI0_D0_N), J10.1
/MIPI0_D0_P: Conn2.17 (MIPI0_D0_P), J10.3
/MIPI0_D1_N: Conn2.21 (MIPI0_D1_N), J10.7
/MIPI0_D1_P: Conn2.23 (MIPI0_D1_P), J10.9
/MIPI0_D2_N: Conn2.33 (MIPI0_D2_N), J10.19
/MIPI0_D2_P: Conn2.35 (MIPI0_D2_P), J10.21
/MIPI0_D3_N: Conn2.39 (MIPI0_D3_N), J10.14
/MIPI0_D3_P: Conn2.41 (MIPI0_D3_P), J10.16
/PCIe_CLK_N: Conn2.12 (PCIe_CLK_N), J3.53 (REFCLKn)
/PCIe_CLK_P: Conn2.10 (PCIe_CLK_P), J3.55 (REFCLKp)
/PCIe_CLK_nREQ: Conn2.2 (PCIe_CLK_nREQ), J3.52 (~CLKREQ)
/PCIe_PWR_EN: Conn2.6 (PCIE_PWR_EN), R9.1, U3.7 (EN)
/PCIe_RX_N: Conn2.18 (PCIe_RX_N), J3.43 (PETp0)
/PCIe_RX_P: Conn2.16 (PCIe_RX_P), J3.41 (PETn0)
/PCIe_TX_N: Conn2.24 (PCIe_TX_N), J3.49 (PERp0)
/PCIe_TX_P: Conn2.22 (PCIe_TX_P), J3.47 (PERn0)
/PCIe_nRST: Conn2.9 (PCIe_nRST), J3.50 (~PERST)
/PCIe_nWAKE: Conn2.4 (PCIE_nWAKE), J3.54 (~PEWAKE)
/PI_nLED_Activity: Conn1.21 (LED_nACT), R12.2
/PoE_5V: C3.1, J5.3, U6.6 (VDC+)
/SCL1: Conn1.56 (GPIO3), J6.4, J10.2, R5.1
/SDA1: Conn1.58 (GPIO2), J6.3, J10.4, R4.1
/SD_CLK: Conn1.57 (SD_CLK), J1.5 (CLK)
/SD_CMD: Conn1.62 (SD_CMD), J1.3 (CMD)
/SD_DAT0: Conn1.63 (SD_DAT0), J1.7 (DAT0)
/SD_DAT1: Conn1.67 (SD_DAT1), J1.8 (DAT1)
/SD_DAT2: Conn1.69 (SD_DAT2), J1.1 (DAT2)
/SD_DAT3: Conn1.61 (SD_DAT3), J1.2 (DAT3/CD)
/SD_PWR: C1.1, J1.4 (VDD), U1.1 (OUT)
/SD_PWR_ON: Conn1.75 (SD_PWR_ON), R2.2, U1.4 (EN)
/SD_VDD_Override: Conn1.73 (SD_VDD_Override), R13.1
/TR0_TAP: D4.2, U4.11 (VC1)
/TR1_TAP: D4.1, U4.12 (VC2)
/TR2_TAP: D5.2, U4.13 (VC3)
/TR3_TAP: D5.1, U4.14 (VC4)
/TRD0_N: Conn1.10 (Ethernet_Pair0_N), U4.2 (TRD0-), U7.2 (D1-), U7.9
/TRD0_P: Conn1.12 (Ethernet_Pair0_P), U4.1 (TRD0+), U7.1 (D1+), U7.10
/TRD1_N: Conn1.6 (Ethernet_Pair1_N), U4.6 (TRD1-), U7.5 (D2-), U7.6
/TRD1_P: Conn1.4 (Ethernet_Pair1_P), U4.3 (TRD1+), U7.4 (D2+), U7.7
/TRD2_N: Conn1.9 (Ethernet_Pair2_N), U4.8 (TRD2-), U8.2 (D1-), U8.9
/TRD2_P: Conn1.11 (Ethernet_Pair2_P), U4.7 (TRD2+), U8.1 (D1+), U8.10
/TRD3_N: Conn1.5 (Ethernet_Pair3_N), U4.10 (TRD3-), U8.5 (D2-), U8.6
/TRD3_P: Conn1.3 (Ethernet_Pair3_P), U4.9 (TRD3+), U8.4 (D2+), U8.7
/UART0_RX: Conn1.51 (GPIO15), J8.1
/UART0_TX: Conn1.55 (GPIO14), J8.3
/USB2_N: Conn2.3 (USB2_N), J2.A7 (D-), J2.B7 (D-)
/USB2_P: Conn2.5 (USB2_P), J2.A6 (D+), J2.B6 (D+)
/USB_5V: C2.1, J2.A4 (VBUS), J2.A9 (VBUS), J2.B4 (VBUS), J2.B9 (VBUS), J5.1, R1.1
/nPI_LED_PWR: Conn1.95 (LED_nPWR), U5.2
/nRPIBOOT: Conn1.93 (nRPIBOOT), J4.1
GND: C1.2, C2.2, C3.2, C4.2, C5.2, C6.2, C7.2, C8.2, C10.2, C11.2, C12.2, C13.2, Conn1.1 (GND), Conn1.2 (GND), Conn1.7 (GND), Conn1.8 (GND), Conn1.13 (GND), Conn1.14 (GND), Conn1.22 (GND), Conn1.23 (GND), Conn1.32 (GND), Conn1.33 (GND), Conn1.42 (GND), Conn1.43 (GND), Conn1.52 (GND), Conn1.53 (GND), Conn1.59 (GND), Conn1.60 (GND), Conn1.65 (GND), Conn1.66 (GND), Conn1.71 (GND), Conn1.74 (GND), Conn1.98 (GND), Conn2.7 (GND), Conn2.8 (GND), Conn2.13 (GND), Conn2.14 (GND), Conn2.19 (GND), Conn2.20 (GND), Conn2.25 (GND), Conn2.26 (GND), Conn2.31 (GND), Conn2.32 (GND), Conn2.37 (GND), Conn2.38 (GND), Conn2.44 (GND), Conn2.50 (GND), Conn2.55 (GND), Conn2.56 (GND), Conn2.61 (GND), Conn2.62 (GND), Conn2.67 (GND), Conn2.68 (GND), Conn2.73 (GND), Conn2.74 (GND), Conn2.79 (GND), Conn2.80 (GND), Conn2.85 (GND), Conn2.86 (GND), Conn2.91 (GND), Conn2.92 (GND), Conn2.97 (GND), Conn2.98 (GND), J1.6 (VSS), J1.11 (SHIELD), J2.A1 (GND), J2.A12 (GND), J2.B1 (GND), J2.B12 (GND), J2.S1 (SHIELD), J3.1 (GND), J3.3 (GND), J3.9 (GND), J3.15 (GND), J3.21 (GND), J3.27 (GND), J3.33 (GND), J3.39 (GND), J3.45 (GND), J3.51 (GND), J3.57 (GND), J3.71 (GND), J3.73 (GND), J3.75 (GND), J3.M1 (GND2230), J3.M2 (GND2242), J3.M3 (GND2260), J3.S1, J3.S2, J4.2, J6.1, J7.3, J8.2, J9.2, J9.6, J10.6, J10.12, J10.18, J10.24, J10.30, J10.36, J10.42, J10.48, R1.2, R9.2, R10.2, R13.2, R14.2, R15.2, U1.2 (GND), U2.2 (GND), U3.4 (PGND), U3.8 (SGND), U3.9 (PAD), U4.19 (SHIELD), U4.20 (SHIELD), U5.3 (GND), U6.5 (VDC-), U6.8 (VDC-), U7.3 (GND), U7.8 (GND), U8.3 (GND), U8.8 (GND)
unnamed: C4.1, U4.4 (CT), U4.5 (CT)
unnamed: D1.1 (K), R3.1
unnamed: D2.1 (K), R11.1
unnamed: D3.1 (K), R12.1
unnamed: D4.3 (+), D5.3 (+), D6.1 (A1), U6.1 (VIN+)
unnamed: D4.4 (-), D5.4 (-), D6.2 (A2), U6.2 (VIN-)
unnamed: J2.A5 (CC1), R15.1
unnamed: J2.B5 (CC2), R14.1
unnamed: J3.10 (DAS/~DSS/~LED1), R3.2
unnamed: J3.68 (SUSCLK), U2.3 (Out)
unnamed: R11.2, U5.4
unnamed: L1.1, U3.6 (LX)
unnamed: R6.1, U4.16 (LEDG_K)
unnamed: R7.1, U4.18 (LEDY_K)

Notes on the sheet:
USB-C (Data & Power)
JTAG connector
I2C
M.2 KEY M
POE Module
PWR SELECT
STATUS LEDS
Activity LED
PWR LED
I2S
FAN Header
FAN connector
RPIBOOT
JTAG
ETHERNET
CM5
SD-CARD

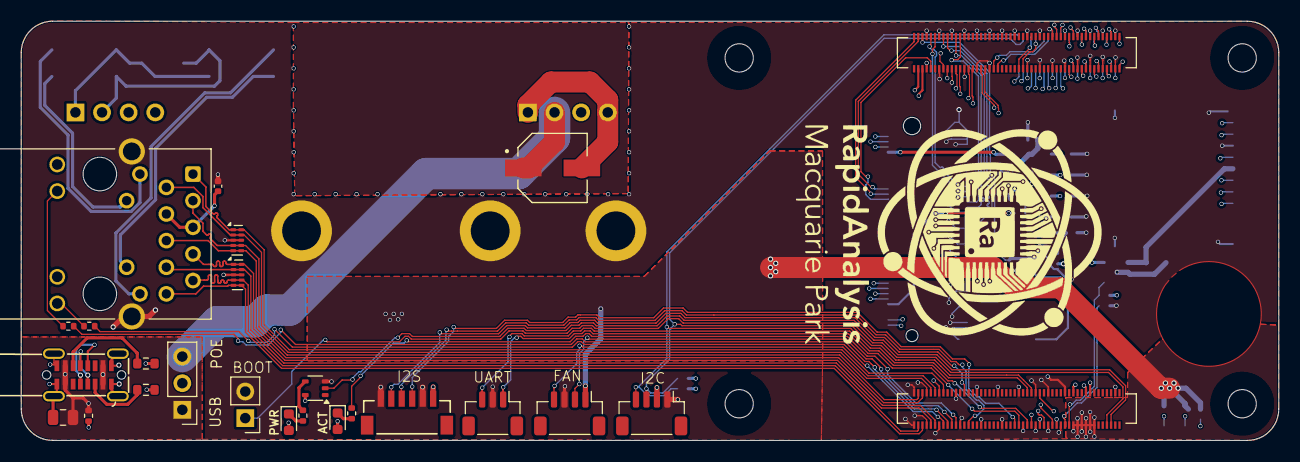
[picture p22: board Xerxes.kicad_pcb from above]

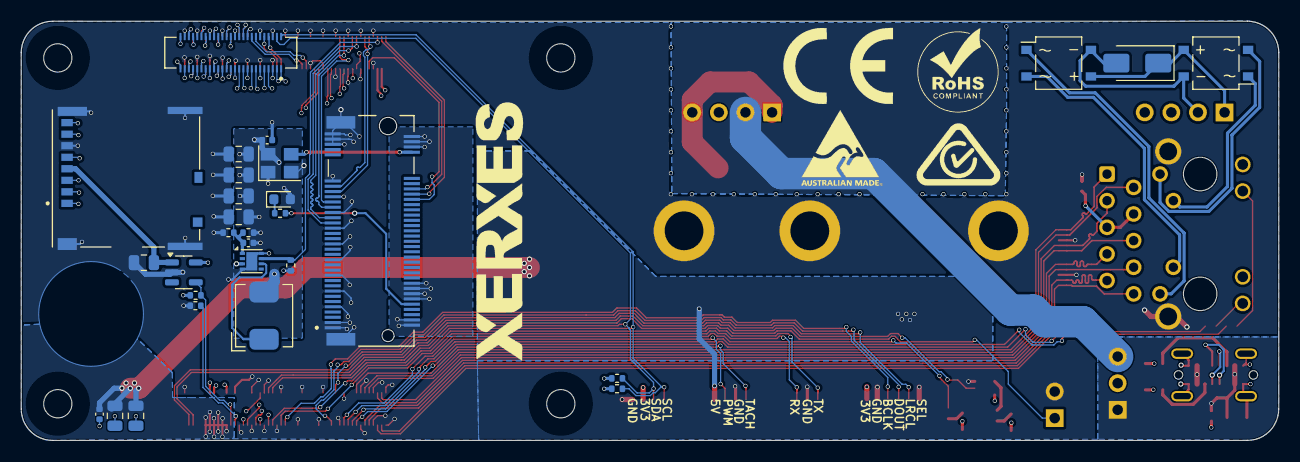
[picture p23: board Xerxes.kicad_pcb from below]

Board: 6 copper layers, 120.0 x 40.0 mm, 58 parts (30 on the bottom side), 100 nets.
