rapidanalysis/xerxes/Blade_v4/Blade_v4.kicad_pcb

## KiCad design Blade_v4/Blade_v4.kicad_pcb (2025-03-26)

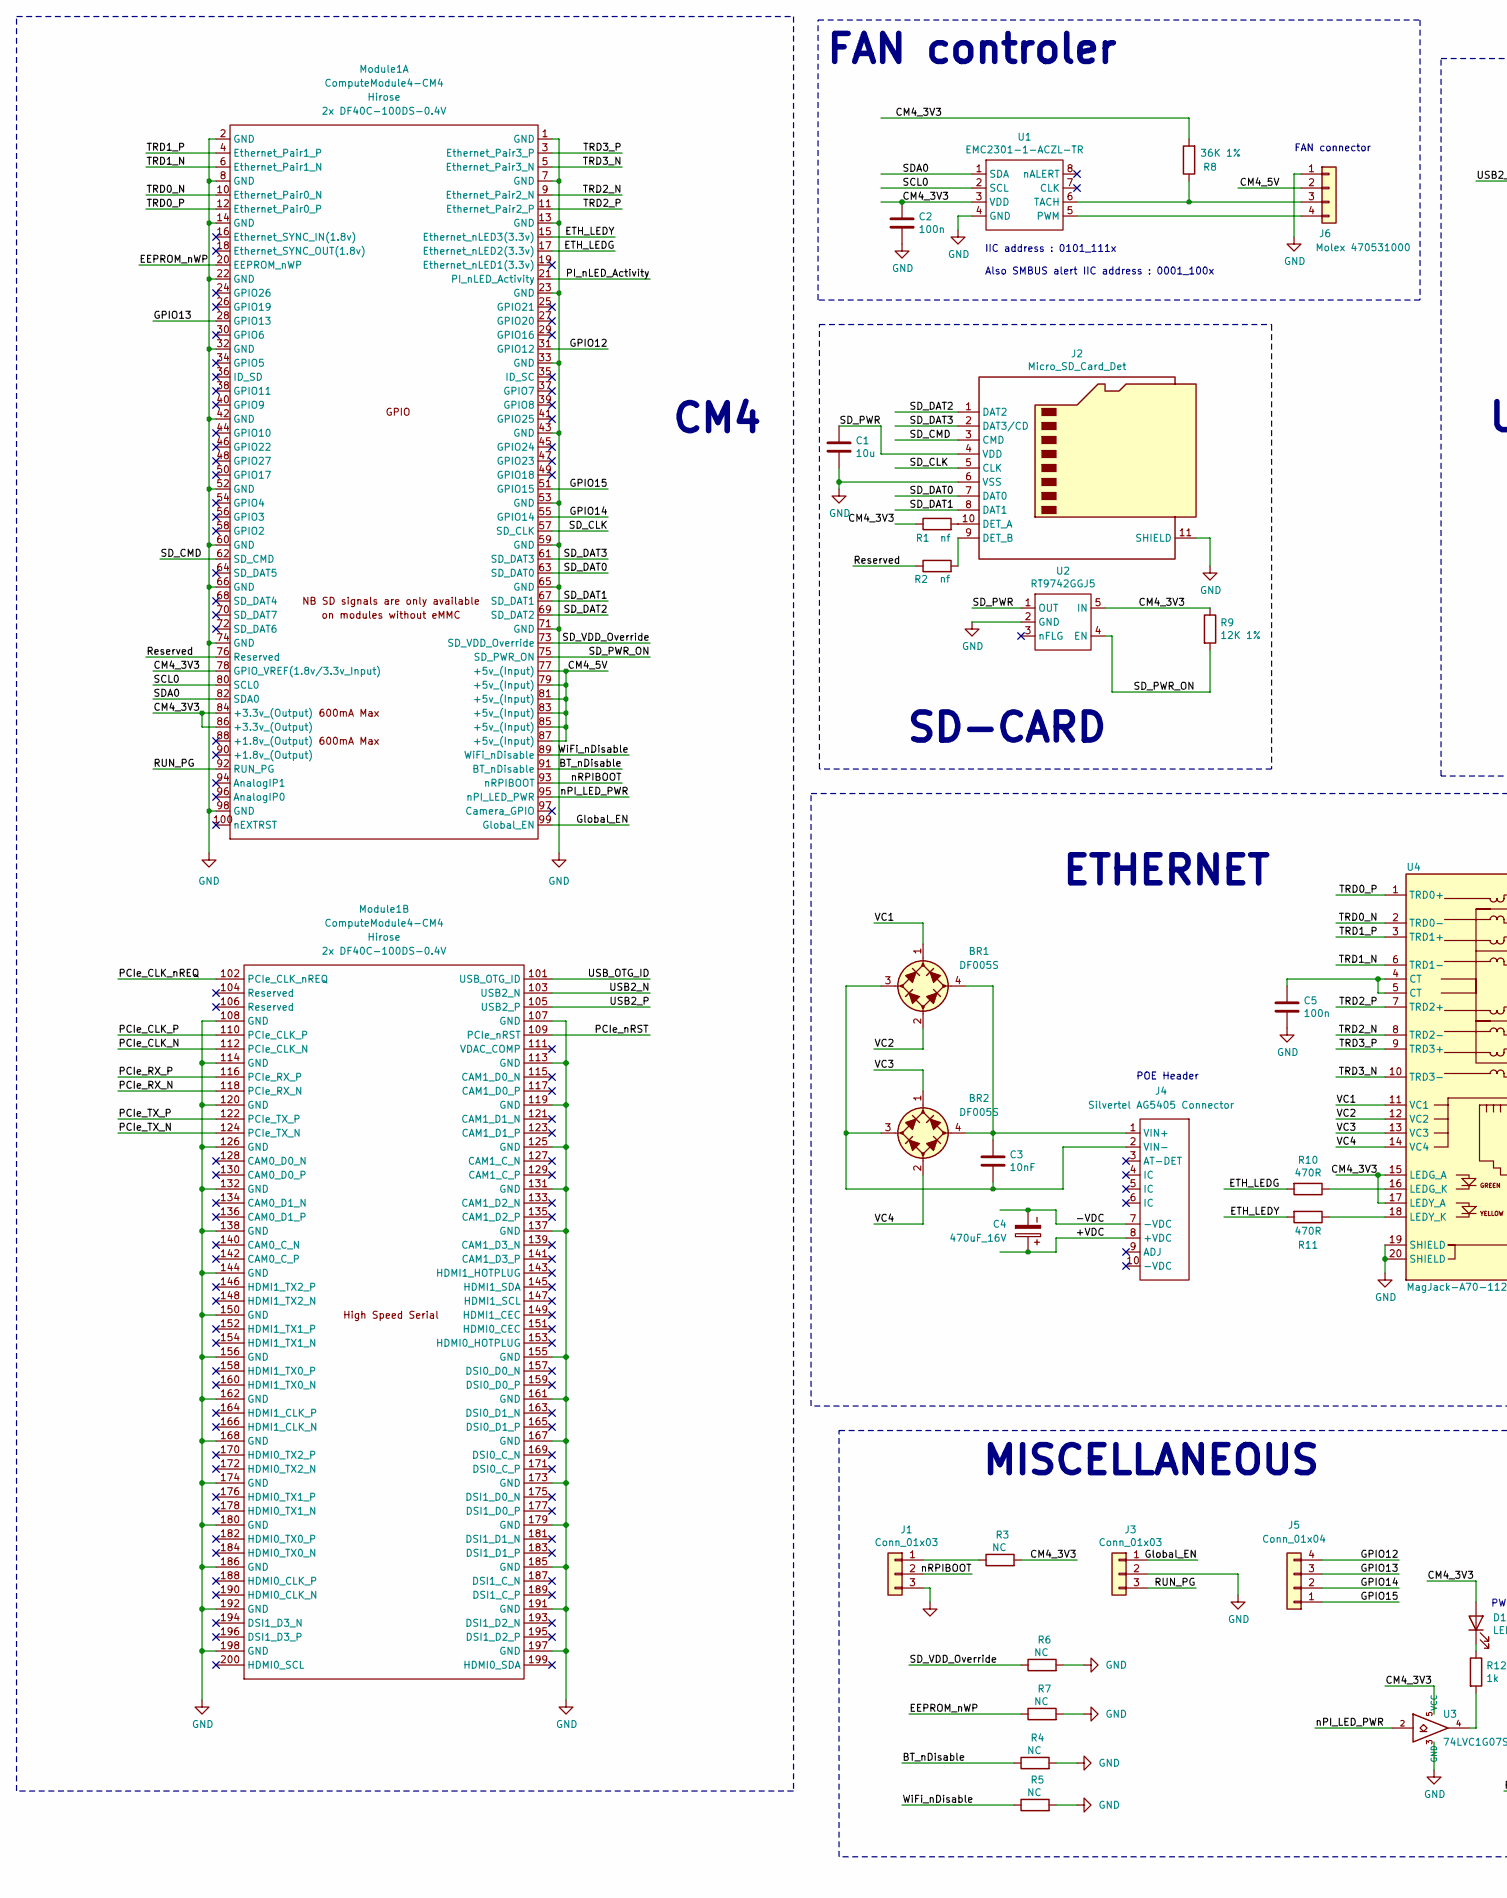
[picture p24: schematic Blade_v4.kicad_sch, V4 - CM4 Board, part in row 1, column 1]

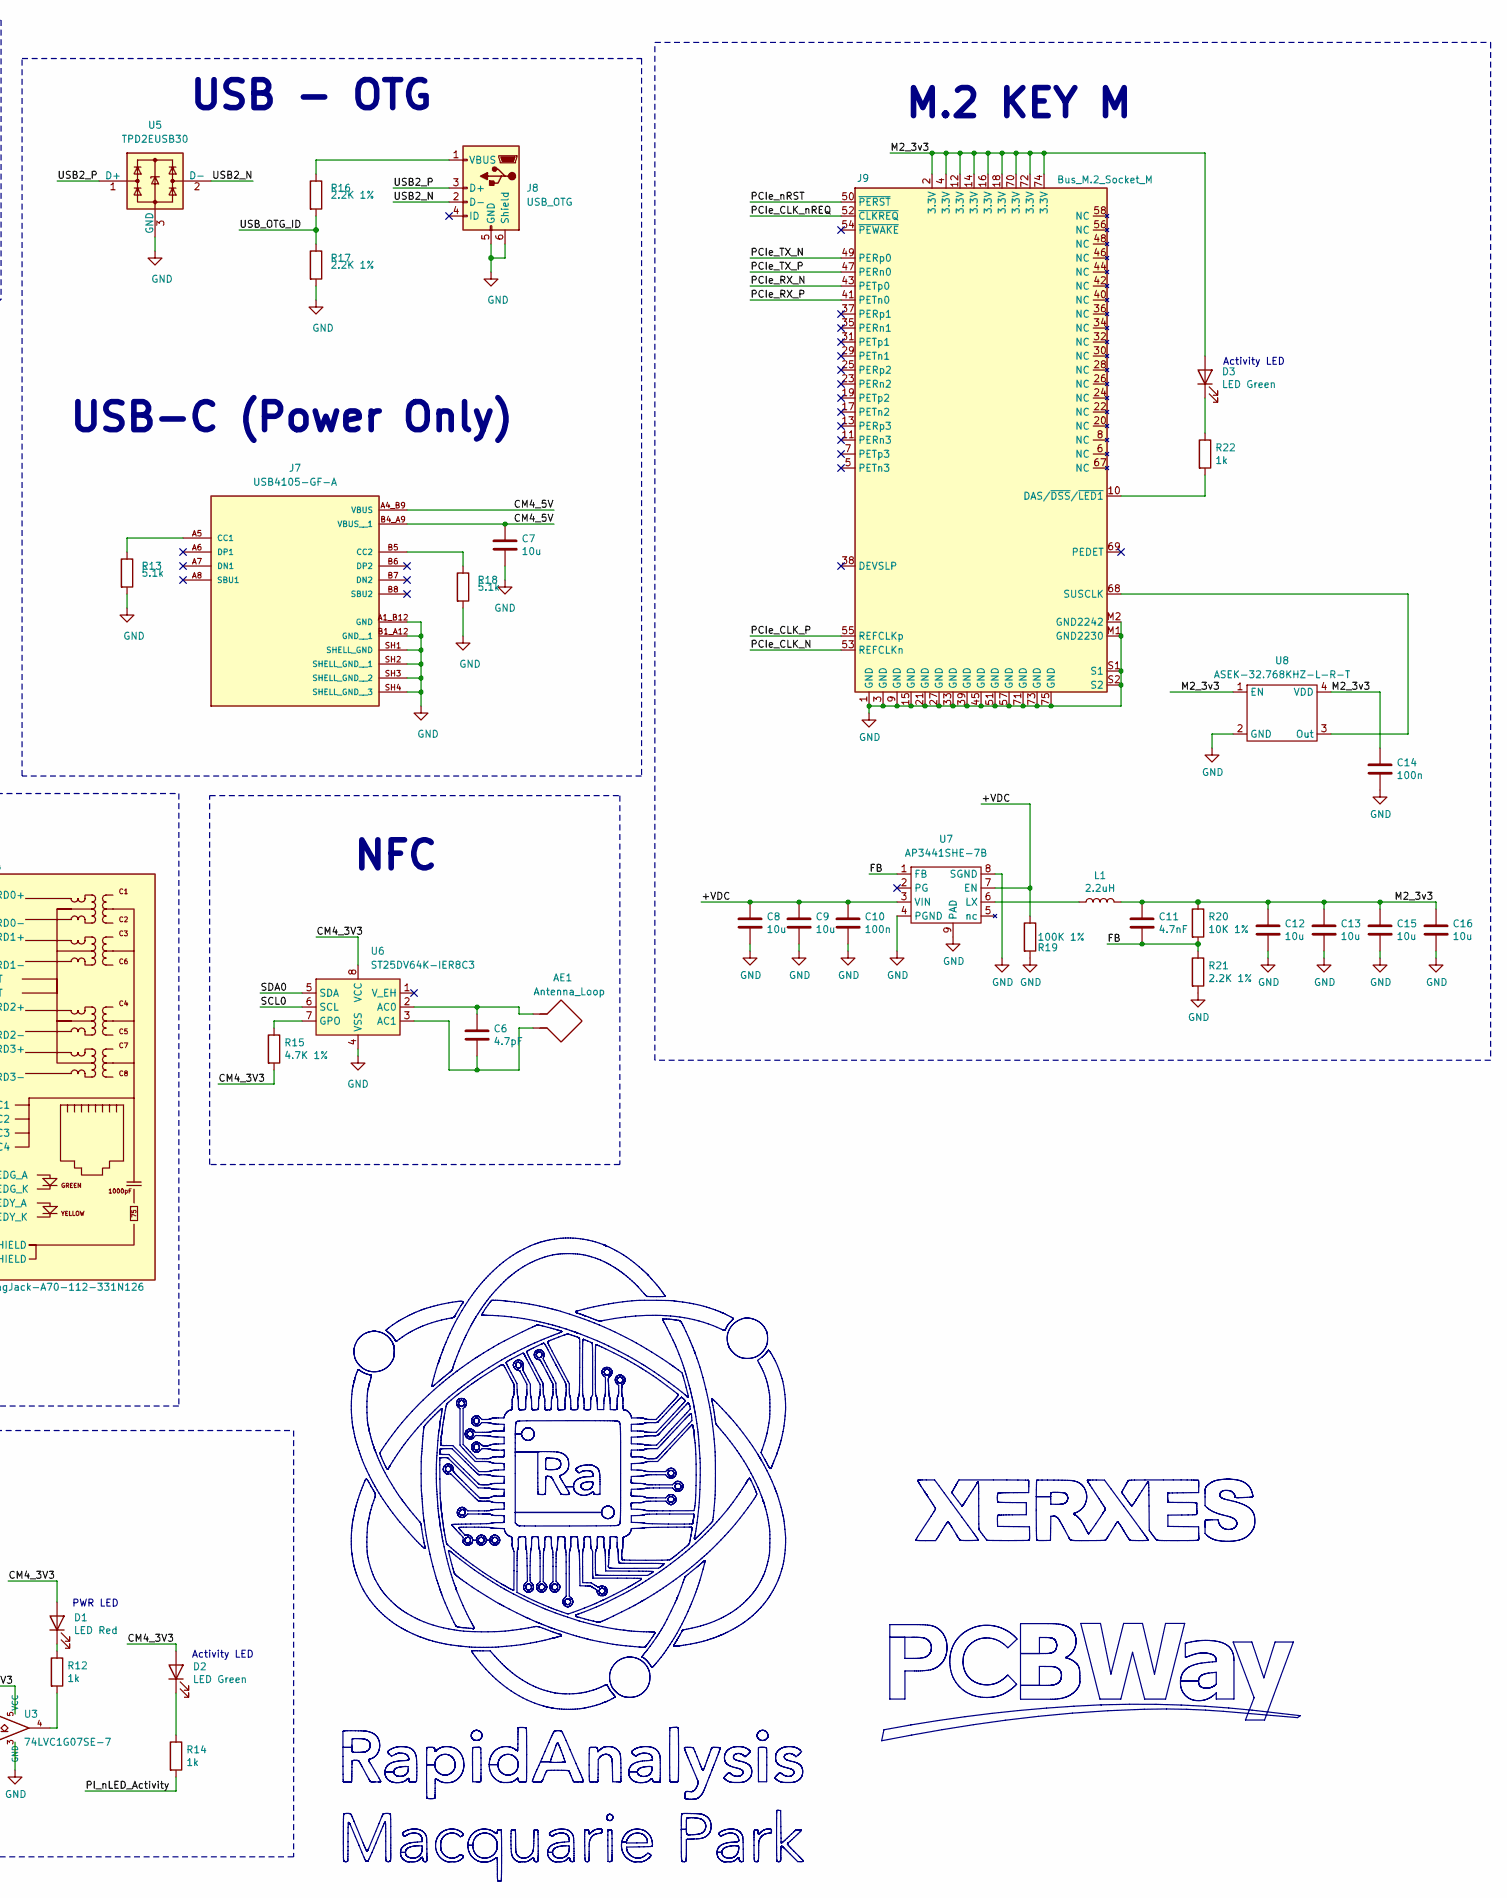
[picture p25: schematic Blade_v4.kicad_sch, V4 - CM4 Board, part in row 1, column 2]

Parts:
AE1: Antenna_Loop; NFC_Antenna
BR1, BR2: DF005S; Diode_Bridge_Vishay_DFS
C1, C7, C8, C9, C12, C13, C15, C16: 10u; C_0805_2012Metric; Part Description 10uF 10% 10V Ceramic Capacitor X7R 0805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
C2, C5, C10, C14: 100n; C_0402_1005Metric; Part Description 0.1uF 10% 16V Ceramic Capacitor X7R 040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
C3: 10nF; C_0402_1005Metric; Part Description 10nF capacitor 0402
C4: 470uF_16V; CP_Radial_D8.0mm_P3.50mm
C6: 4.7pF; C_0402_1005Metric; Part Description 4.7pF capacitor 0402
C11: 4.7nF; C_0402_1005Metric; Part Description 4.7nF capacitor 0402
D1: LED Red; LED_0603_1608Metric; Part Description Red 620nm LED Indication - Discrete 2.2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
D2, D3: LED Green; LED_0603_1608Metric; Part Description Green 572nm LED Indication - Discrete 2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
J1, J3: Conn_01x03; PinHeader_1x03_P2.54mm_Vertical; Part Description 3pin 0.1" connector
J2: Micro_SD_Card_Det; SDCARD_MOLEX_503398-1892; Part Description 9 (8 + 1) Position Card Connector micro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
J4: Silvertel AG5405 Connector; Converter_DCDC_Silvertel_Ag54xx
J5: Conn_01x04; PinHeader_1x04_P2.54mm_Vertical
J6: Molex 470531000; FanPinHeader_1x04_P2.54mm_Vertical; Part Description Connector Header Through Hole 4 positio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
J7: USB4105-GF-A; GCT_USB4105-GF-A; PARTREV B4
J8: USB_OTG; USB_Micro-B_EDAC_UCON00686; MPN 10103594-0001LF; Digi-Key_PN 609-4050-1-ND
J9: Bus_M.2_Socket_M; M.2 M Key socket; Part Description M.2 M Key connector
L1: 2.2uH; L_Bourns_SRP5030CC; Part Description Inductor, SMT, 2520, 2u2, IRMS=7A, ISAT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
Module1: ComputeModule4-CM4; Raspberry-Pi-4-Compute-Module
R1, R2: nf; R_0402_1005Metric; Part Description Resistor 1K M1005 1% 63mW
R3, R4, R5, R6, R7: NC; R_0402_1005Metric; Part Description Resistor 1K M1005 1% 63mW
R8: 36K 1%; R_0402_1005Metric; Part Description Resistor 36K M1005 1% 63mW
R9: 12K 1%; R_0402_1005Metric; Part Description Resistor 12K M1005 1% 63mW
R10, R11: 470R; R_0402_1005Metric; Part Description Resistor 470R M1005 1% 63mW
R12, R14, R22: 1k; R_0402_1005Metric; Part Description Resistor 1K M1005 1% 63mW
R13, R18: 5.1k; R_0603_1608Metric_Pad0.98x0.95mm_HandSolder; MPN RC0603FR-075K1L; Digi-Key_PN 311-5.10KHRCT-ND
R15: 4.7K 1%; R_0402_1005Metric; Part Description Resistor 4.7K M1005 1% 63mW
R16, R17: 2.2K 1%; R_0603_1608Metric_Pad0.98x0.95mm_HandSolder; MPN RC0603FR-072K2L; Digi-Key_PN 311-2.20KHRCT-ND
R19: 100K 1%; R_0402_1005Metric; Part Description Resistor 100K M1005 1% 63mW
R20: 10K 1%; R_0402_1005Metric; Part Description Resistor 10K M1005 1% 63mW
R21: 2.2K 1%; R_0402_1005Metric; Part Description Resistor 2.2K M1005 1% 63mW
U1: EMC2301-1-ACZL-TR; MSOP-8_3x3mm_P0.65mm; Part Description Motor Driver PWM 8-MSOP
U2: RT9742GGJ5; SOT-23-5; Part Description Power Switch/Driver 1:1 N-Channel 1A TS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
U3: 74LVC1G07SE-7; SOT-353_SC-70-5; Part Description Buffer, Non-Inverting 1 Element 1 Bit p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
U4: MagJack-A70-112-331N126; TRJG0926HENL; Part Description Gigabit Ethernet Magjack
U5: TPD2EUSB30; Texas_DRT-3; MPN TPD2EUSB30DRTR; Digi-Key_PN 296-25509-1-ND
U6: ST25DV64K-IER8C3; DFN-8-1EP_3x2mm_P0.5mm_EP1.36x1.46mm
U7: AP3441SHE-7B; DFN-8-1EP_2x2mm_P0.5mm_EP1.05x1.75mm; Part Description 3A DC-DC converter
U8: ASEK-32.768KHZ-L-R-T; Crystal_SMD_3225-4Pin_3.2x2.5mm; Part Description 32KHz Xtal oscilator

Connections:
/+VDC: C4.1, C8.1, C9.1, C10.1, J4.8 (+VDC), R19.1, U7.3 (VIN), U7.7 (EN)
/-VDC: C4.2, J4.7 (-VDC)
/BT_nDisable: Module1.91 (BT_nDisable), R4.1
/CM4_3V3: C2.1, D1.2 (A), D2.2 (A), Module1.78 (GPIO_VREF(1.8v/3.3v_Input)), Module1.84 (+3.3v_(Output)), Module1.86 (+3.3v_(Output)), R1.1, R3.2, R8.2, R9.1, R15.2, U1.3 (VDD), U2.5 (IN), U3.5 (VCC), U4.15 (LEDG_A), U4.17 (LEDY_A), U6.8 (VCC)
/CM4_5V: C7.1, J6.2, J7.A4_B9 (VBUS), J7.B4_A9 (VBUS__1), Module1.77 (+5v_(Input)), Module1.79 (+5v_(Input)), Module1.81 (+5v_(Input)), Module1.83 (+5v_(Input)), Module1.85 (+5v_(Input)), Module1.87 (+5v_(Input))
/EEPROM_nWP: Module1.20 (EEPROM_nWP), R7.1
/ETH_LEDG: Module1.17 (Ethernet_nLED2(3.3v)), R10.2
/ETH_LEDY: Module1.15 (Ethernet_nLED3(3.3v)), R11.2
/FB: C11.2, R20.2, R21.1, U7.1 (FB)
/GPIO12: J5.4, Module1.31 (GPIO12)
/GPIO13: J5.3, Module1.28 (GPIO13)
/GPIO14: J5.2, Module1.55 (GPIO14)
/GPIO15: J5.1, Module1.51 (GPIO15)
/Global_EN: J3.1, Module1.99 (Global_EN)
/M2_3v3: C11.1, C12.1, C13.1, C14.1, C15.1, C16.1, D3.2 (A), J9.2 (3.3V), J9.4 (3.3V), J9.12 (3.3V), J9.14 (3.3V), J9.16 (3.3V), J9.18 (3.3V), J9.70 (3.3V), J9.72 (3.3V), J9.74 (3.3V), L1.2, R20.1, U8.1 (EN), U8.4 (VDD)
/PCIe_CLK_N: J9.53 (REFCLKn), Module1.112 (PCIe_CLK_N)
/PCIe_CLK_P: J9.55 (REFCLKp), Module1.110 (PCIe_CLK_P)
/PCIe_CLK_nREQ: J9.52 (~CLKREQ), Module1.102 (PCIe_CLK_nREQ)
/PCIe_RX_N: J9.43 (PETp0), Module1.118 (PCIe_RX_N)
/PCIe_RX_P: J9.41 (PETn0), Module1.116 (PCIe_RX_P)
/PCIe_TX_N: J9.49 (PERp0), Module1.124 (PCIe_TX_N)
/PCIe_TX_P: J9.47 (PERn0), Module1.122 (PCIe_TX_P)
/PCIe_nRST: J9.50 (~PERST), Module1.109 (PCIe_nRST)
/PI_nLED_Activity: Module1.21 (PI_nLED_Activity), R14.2
/RUN_PG: J3.3, Module1.92 (RUN_PG)
/Reserved: Module1.76 (Reserved), R2.1
/SCL0: Module1.80 (SCL0), U1.2 (SCL), U6.6 (SCL)
/SDA0: Module1.82 (SDA0), U1.1 (SDA), U6.5 (SDA)
/SD_CLK: J2.5 (CLK), Module1.57 (SD_CLK)
/SD_CMD: J2.3 (CMD), Module1.62 (SD_CMD)
/SD_DAT0: J2.7 (DAT0), Module1.63 (SD_DAT0)
/SD_DAT1: J2.8 (DAT1), Module1.67 (SD_DAT1)
/SD_DAT2: J2.1 (DAT2), Module1.69 (SD_DAT2)
/SD_DAT3: J2.2 (DAT3/CD), Module1.61 (SD_DAT3)
/SD_PWR: C1.1, J2.4 (VDD), U2.1 (OUT)
/SD_PWR_ON: Module1.75 (SD_PWR_ON), R9.2, U2.4 (EN)
/SD_VDD_Override: Module1.73 (SD_VDD_Override), R6.1
/TRD0_N: Module1.10 (Ethernet_Pair0_N), U4.2 (TRD0-)
/TRD0_P: Module1.12 (Ethernet_Pair0_P), U4.1 (TRD0+)
/TRD1_N: Module1.6 (Ethernet_Pair1_N), U4.6 (TRD1-)
/TRD1_P: Module1.4 (Ethernet_Pair1_P), U4.3 (TRD1+)
/TRD2_N: Module1.9 (Ethernet_Pair2_N), U4.8 (TRD2-)
/TRD2_P: Module1.11 (Ethernet_Pair2_P), U4.7 (TRD2+)
/TRD3_N: Module1.5 (Ethernet_Pair3_N), U4.10 (TRD3-)
/TRD3_P: Module1.3 (Ethernet_Pair3_P), U4.9 (TRD3+)
/USB2_N: J8.2 (D-), Module1.103 (USB2_N), U5.2 (D-)
/USB2_P: J8.3 (D+), Module1.105 (USB2_P), U5.1 (D+)
/USB_OTG_ID: Module1.101 (USB_OTG_ID), R16.2, R17.1
/VC1: BR1.1 (+), U4.11 (VC1)
/VC2: BR1.2 (-), U4.12 (VC2)
/VC3: BR2.1 (+), U4.13 (VC3)
/VC4: BR2.2 (-), U4.14 (VC4)
/WiFi_nDisable: Module1.89 (WiFi_nDisable), R5.1
/nPI_LED_PWR: Module1.95 (nPI_LED_PWR), U3.2
/nRPIBOOT: J1.2, Module1.93 (nRPIBOOT)
GND: C1.2, C2.2, C5.2, C7.2, C8.2, C9.2, C10.2, C12.2, C13.2, C14.2, C15.2, C16.2, J1.3, J2.6 (VSS), J2.11 (SHIELD), J3.2, J6.1, J7.A1_B12 (GND), J7.B1_A12 (GND__1), J7.SH1 (SHELL_GND), J7.SH2 (SHELL_GND__1), J7.SH3 (SHELL_GND__2), J7.SH4 (SHELL_GND__3), J8.5 (GND), J8.6 (Shield), J9.1 (GND), J9.3 (GND), J9.9 (GND), J9.15 (GND), J9.21 (GND), J9.27 (GND), J9.33 (GND), J9.39 (GND), J9.45 (GND), J9.51 (GND), J9.57 (GND), J9.71 (GND), J9.73 (GND), J9.75 (GND), J9.M1 (GND2230), J9.M2 (GND2242), J9.S1, J9.S2, Module1.1 (GND), Module1.2 (GND), Module1.7 (GND), Module1.8 (GND), Module1.13 (GND), Module1.14 (GND), Module1.22 (GND), Module1.23 (GND), Module1.32 (GND), Module1.33 (GND), Module1.42 (GND), Module1.43 (GND), Module1.52 (GND), Module1.53 (GND), Module1.59 (GND), Module1.60 (GND), Module1.65 (GND), Module1.66 (GND), Module1.71 (GND), Module1.74 (GND), Module1.98 (GND), Module1.107 (GND), Module1.108 (GND), Module1.113 (GND), Module1.114 (GND), Module1.119 (GND), Module1.120 (GND), Module1.125 (GND), Module1.126 (GND), Module1.131 (GND), Module1.132 (GND), Module1.137 (GND), Module1.138 (GND), Module1.144 (GND), Module1.150 (GND), Module1.155 (GND), Module1.156 (GND), Module1.161 (GND), Module1.162 (GND), Module1.167 (GND), Module1.168 (GND), Module1.173 (GND), Module1.174 (GND), Module1.179 (GND), Module1.180 (GND), Module1.185 (GND), Module1.186 (GND), Module1.191 (GND), Module1.192 (GND), Module1.197 (GND), Module1.198 (GND), R4.2, R5.2, R6.2, R7.2, R13.2, R17.2, R18.2, R19.2, R21.2, U1.4 (GND), U2.2 (GND), U3.3 (GND), U4.19 (SHIELD), U4.20 (SHIELD), U5.3 (GND), U6.4 (VSS), U7.4 (PGND), U7.8 (SGND), U7.9 (PAD), U8.2 (GND)
unnamed: BR1.3 (1), BR2.3 (1), C3.2, J4.2 (VIN-)
unnamed: BR1.4 (2), BR2.4 (2), C3.1, J4.1 (VIN+)
unnamed: C5.1, U4.4 (CT), U4.5 (CT)
unnamed: D1.1 (K), R12.1
unnamed: D2.1 (K), R14.1
unnamed: D3.1 (K), R22.1
unnamed: J1.1, R3.1
unnamed: J2.10 (DET_A), R1.2
unnamed: J2.9 (DET_B), R2.2
unnamed: J6.3, R8.1, U1.6 (TACH)
unnamed: J6.4, U1.5 (PWM)
unnamed: J7.A5 (CC1), R13.1
unnamed: J7.B5 (CC2), R18.1
unnamed: J8.1 (VBUS), R16.1
unnamed: J9.10 (DAS/~DSS/~LED1), R22.2
unnamed: J9.68 (SUSCLK), U8.3 (Out)
unnamed: R12.2, U3.4
unnamed: R10.1, U4.16 (LEDG_K)
unnamed: R11.1, U4.18 (LEDY_K)
unnamed: AE1.1, C6.1, U6.2 (AC0)
unnamed: AE1.2, C6.2, U6.3 (AC1)
unnamed: R15.1, U6.7 (GPO)
unnamed: L1.1, U7.6 (LX)

Notes on the sheet:
USB-C (Power Only)
FAN controler
M.2 KEY M
NFC
Activity LED
IIC address : 0101_111x
FAN connector
PWR LED
USB - OTG
POE Header
Also SMBUS alert IIC address : 0001_100x
MISCELLANEOUS
ETHERNET
CM4
SD-CARD

Board: 2 copper layers, 63 parts (4 on the bottom side), 79 nets, no tracks yet.
