rapidanalysis/xerxes/POE/POE/POE.kicad_pcb

## KiCad design POE/POE/POE.kicad_pcb (2025-03-26)

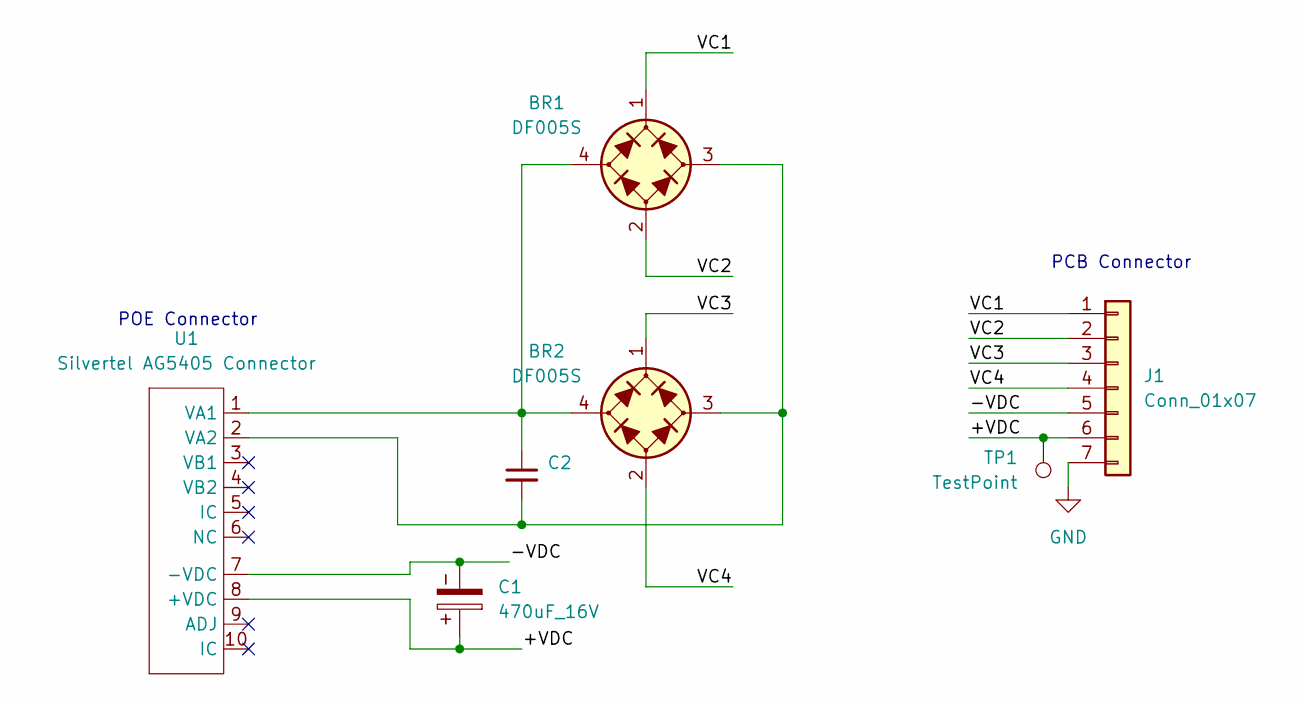
[picture p26: schematic POE.kicad_sch]

Parts:
BR1, BR2: DF005S; Diode_Bridge_Vishay_DFS
C1: 470uF_16V; CP_Radial_D8.0mm_P3.50mm
C2: 10nF; C_0402_1005Metric; Part Number 10 nf Capacitor 0402
J1: Conn_01x07; PinHeader_1x07_P2.54mm_Vertical
TP1: TestPoint; TestPoint_Pad_2.0x2.0mm
U1: Silvertel AG5405 Connector; AG5405

Connections:
/+VDC: C1.1, J1.6, TP1.1, U1.8 (+VDC)
/-VDC: C1.2, J1.5, U1.7 (-VDC)
/VC1: BR1.1 (+), J1.1
/VC2: BR1.2 (-), J1.2
/VC3: BR2.1 (+), J1.3
/VC4: BR2.2 (-), J1.4
GND: J1.7
unnamed: BR1.3 (1), BR2.3 (1), C2.2, U1.2 (VA2)
unnamed: BR1.4 (2), BR2.4 (2), C2.1, U1.1 (VA1)

Notes on the sheet:
POE Connector
PCB Connector

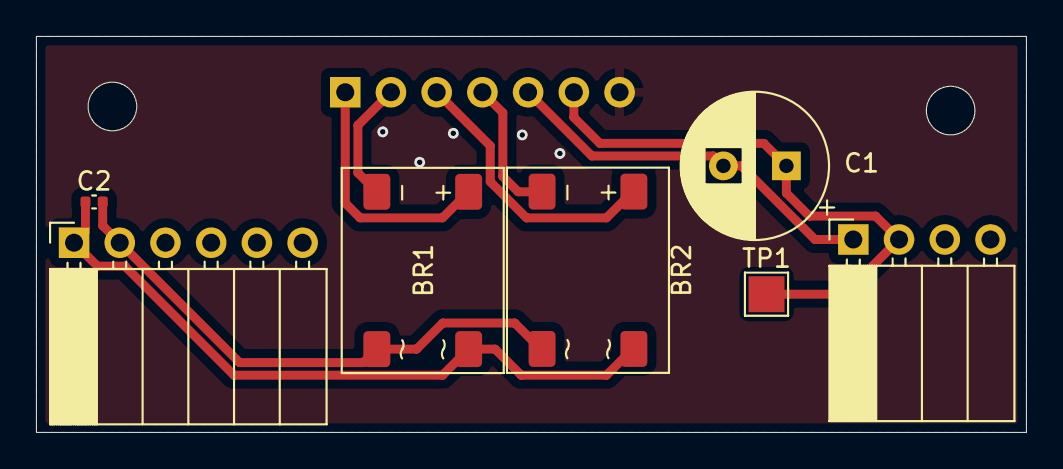
[picture p27: board POE.kicad_pcb from above]

Board: 2 copper layers, 55.0 x 22.0 mm, 7 parts (1 on the bottom side), 8 nets.
