rapidanalysis/xerxes/Blade_v2/Blade_v2.kicad_pcb

## KiCad design Blade_v2/Blade_v2.kicad_pcb (2025-01-25, an earlier design)

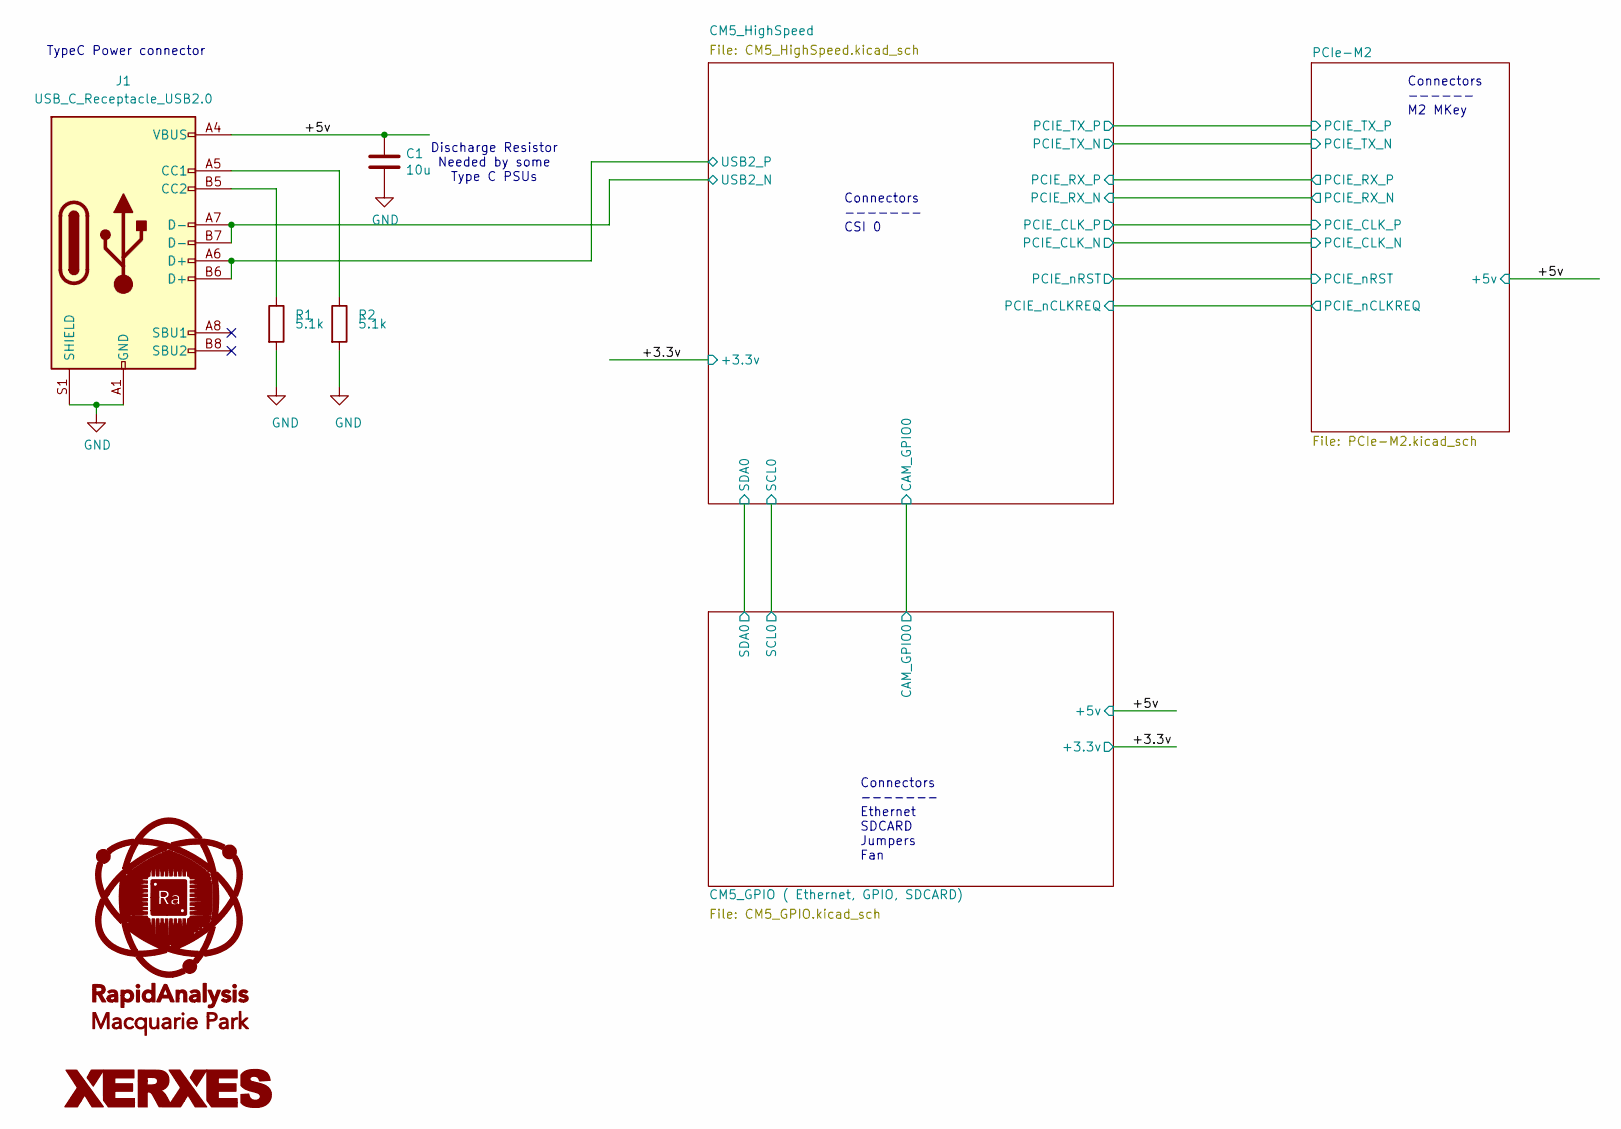
[picture p28: schematic Blade_v2.kicad_sch, BLADE CM4 CARRIER BOARD]

Parts:
C1: 10u; C_0402_1005Metric; Part Description 0.1uF 10% 16V Ceramic Capacitor X7R 040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
J1: USB_C_Receptacle_USB2.0; USB_C_Receptacle_GCT_USB4105-xx-A_16P_TopMnt_Horizontal; Part Description USBC USB2 data and power connector
R1, R2: 5.1k; R_0603_1608Metric_Pad0.98x0.95mm_HandSolder; MPN RC0603FR-075K1L; Digi-Key_PN 311-5.10KHRCT-ND

Connections:
/+5v: C1.1, J1.A4 (VBUS), J1.A9 (VBUS), J1.B4 (VBUS), J1.B9 (VBUS); also elsewhere on the board
/CM5_HighSpeed/USB2_N: J1.A7 (D-), J1.B7 (D-); also elsewhere on the board
/CM5_HighSpeed/USB2_P: J1.A6 (D+), J1.B6 (D+); also elsewhere on the board
GND: C1.2, J1.A1 (GND), J1.A12 (GND), J1.B1 (GND), J1.B12 (GND), J1.S1 (SHIELD), R1.2, R2.2; also elsewhere on the board
unnamed: J1.A5 (CC1), R2.1
unnamed: J1.B5 (CC2), R1.1

Notes on the sheet:
Connectors ------ M2 MKey
Connectors ------- Ethernet SDCARD Jumpers Fan
Discharge Resistor Needed by some Type C PSUs
Connectors ------- CSI 0
TypeC Power connector

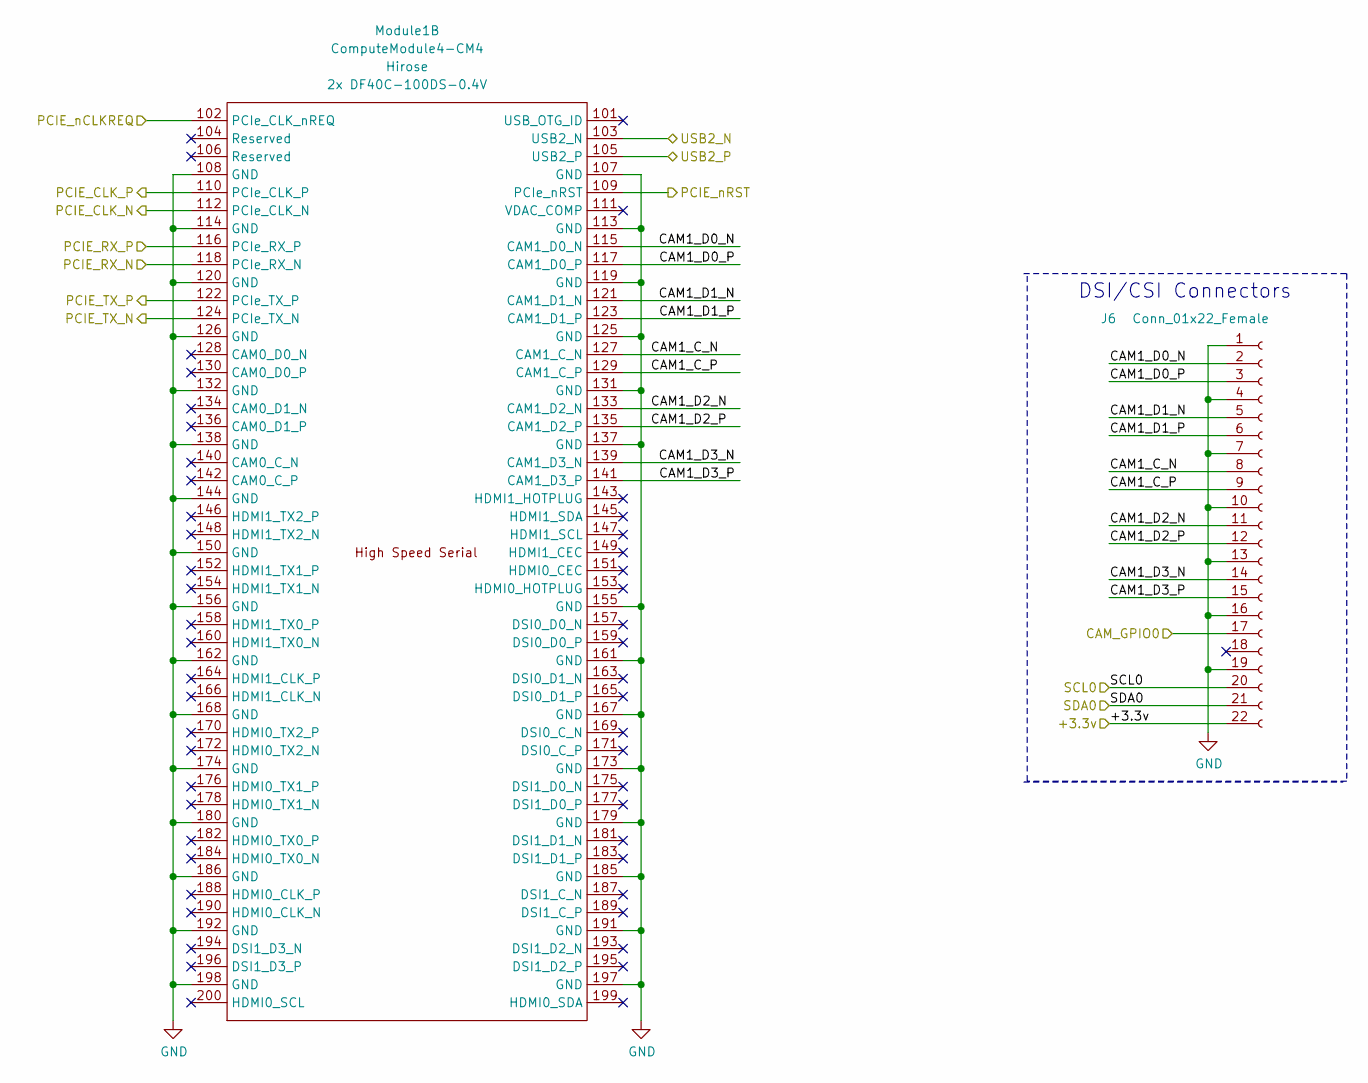
[picture p29: schematic CM5_HighSpeed.kicad_sch, BLADE CM4 CARRIER BOARD]

Parts:
J6: Conn_01x22_Female; Hirose_FH12-22S-0.5SH_1x22-1MP_P0.50mm_Horizontal; Part Description 22 Position FFC, FPC Connector Contacts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
Module1: ComputeModule4-CM4; Raspberry-Pi-4-Compute-Module

Connections:
/+3.3v: J6.22; also elsewhere on the board
/CM5_GPIO ( Ethernet, GPIO, SDCARD)/CAM_GPIO0: J6.17; also elsewhere on the board
/CM5_GPIO ( Ethernet, GPIO, SDCARD)/SCL0: J6.20; also elsewhere on the board
/CM5_GPIO ( Ethernet, GPIO, SDCARD)/SDA0: J6.21; also elsewhere on the board
/CM5_HighSpeed/CAM1_C_N: J6.8, Module1.127 (CAM1_C_N)
/CM5_HighSpeed/CAM1_C_P: J6.9, Module1.129 (CAM1_C_P)
/CM5_HighSpeed/CAM1_D0_N: J6.2, Module1.115 (CAM1_D0_N)
/CM5_HighSpeed/CAM1_D0_P: J6.3, Module1.117 (CAM1_D0_P)
/CM5_HighSpeed/CAM1_D1_N: J6.5, Module1.121 (CAM1_D1_N)
/CM5_HighSpeed/CAM1_D1_P: J6.6, Module1.123 (CAM1_D1_P)
/CM5_HighSpeed/CAM1_D2_N: J6.11, Module1.133 (CAM1_D2_N)
/CM5_HighSpeed/CAM1_D2_P: J6.12, Module1.135 (CAM1_D2_P)
/CM5_HighSpeed/CAM1_D3_N: J6.14, Module1.139 (CAM1_D3_N)
/CM5_HighSpeed/CAM1_D3_P: J6.15, Module1.141 (CAM1_D3_P)
/CM5_HighSpeed/PCIE_CLK_N: Module1.112 (PCIe_CLK_N); also elsewhere on the board
/CM5_HighSpeed/PCIE_CLK_P: Module1.110 (PCIe_CLK_P); also elsewhere on the board
/CM5_HighSpeed/PCIE_RX_N: Module1.118 (PCIe_RX_N); also elsewhere on the board
/CM5_HighSpeed/PCIE_RX_P: Module1.116 (PCIe_RX_P); also elsewhere on the board
/CM5_HighSpeed/PCIE_TX_N: Module1.124 (PCIe_TX_N); also elsewhere on the board
/CM5_HighSpeed/PCIE_TX_P: Module1.122 (PCIe_TX_P); also elsewhere on the board
/CM5_HighSpeed/PCIE_nCLKREQ: Module1.102 (PCIe_CLK_nREQ); also elsewhere on the board
/CM5_HighSpeed/PCIE_nRST: Module1.109 (PCIe_nRST); also elsewhere on the board
/CM5_HighSpeed/USB2_N: Module1.103 (USB2_N); also elsewhere on the board
/CM5_HighSpeed/USB2_P: Module1.105 (USB2_P); also elsewhere on the board
GND: J6.1, J6.4, J6.7, J6.10, J6.13, J6.16, J6.19, Module1.107 (GND), Module1.108 (GND), Module1.113 (GND), Module1.114 (GND), Module1.119 (GND), Module1.120 (GND), Module1.125 (GND), Module1.126 (GND), Module1.131 (GND), Module1.132 (GND), Module1.137 (GND), Module1.138 (GND), Module1.144 (GND), Module1.150 (GND), Module1.155 (GND), Module1.156 (GND), Module1.161 (GND), Module1.162 (GND), Module1.167 (GND), Module1.168 (GND), Module1.173 (GND), Module1.174 (GND), Module1.179 (GND), Module1.180 (GND), Module1.185 (GND), Module1.186 (GND), Module1.191 (GND), Module1.192 (GND), Module1.197 (GND), Module1.198 (GND); also elsewhere on the board

Notes on the sheet:
DSI/CSI Connectors

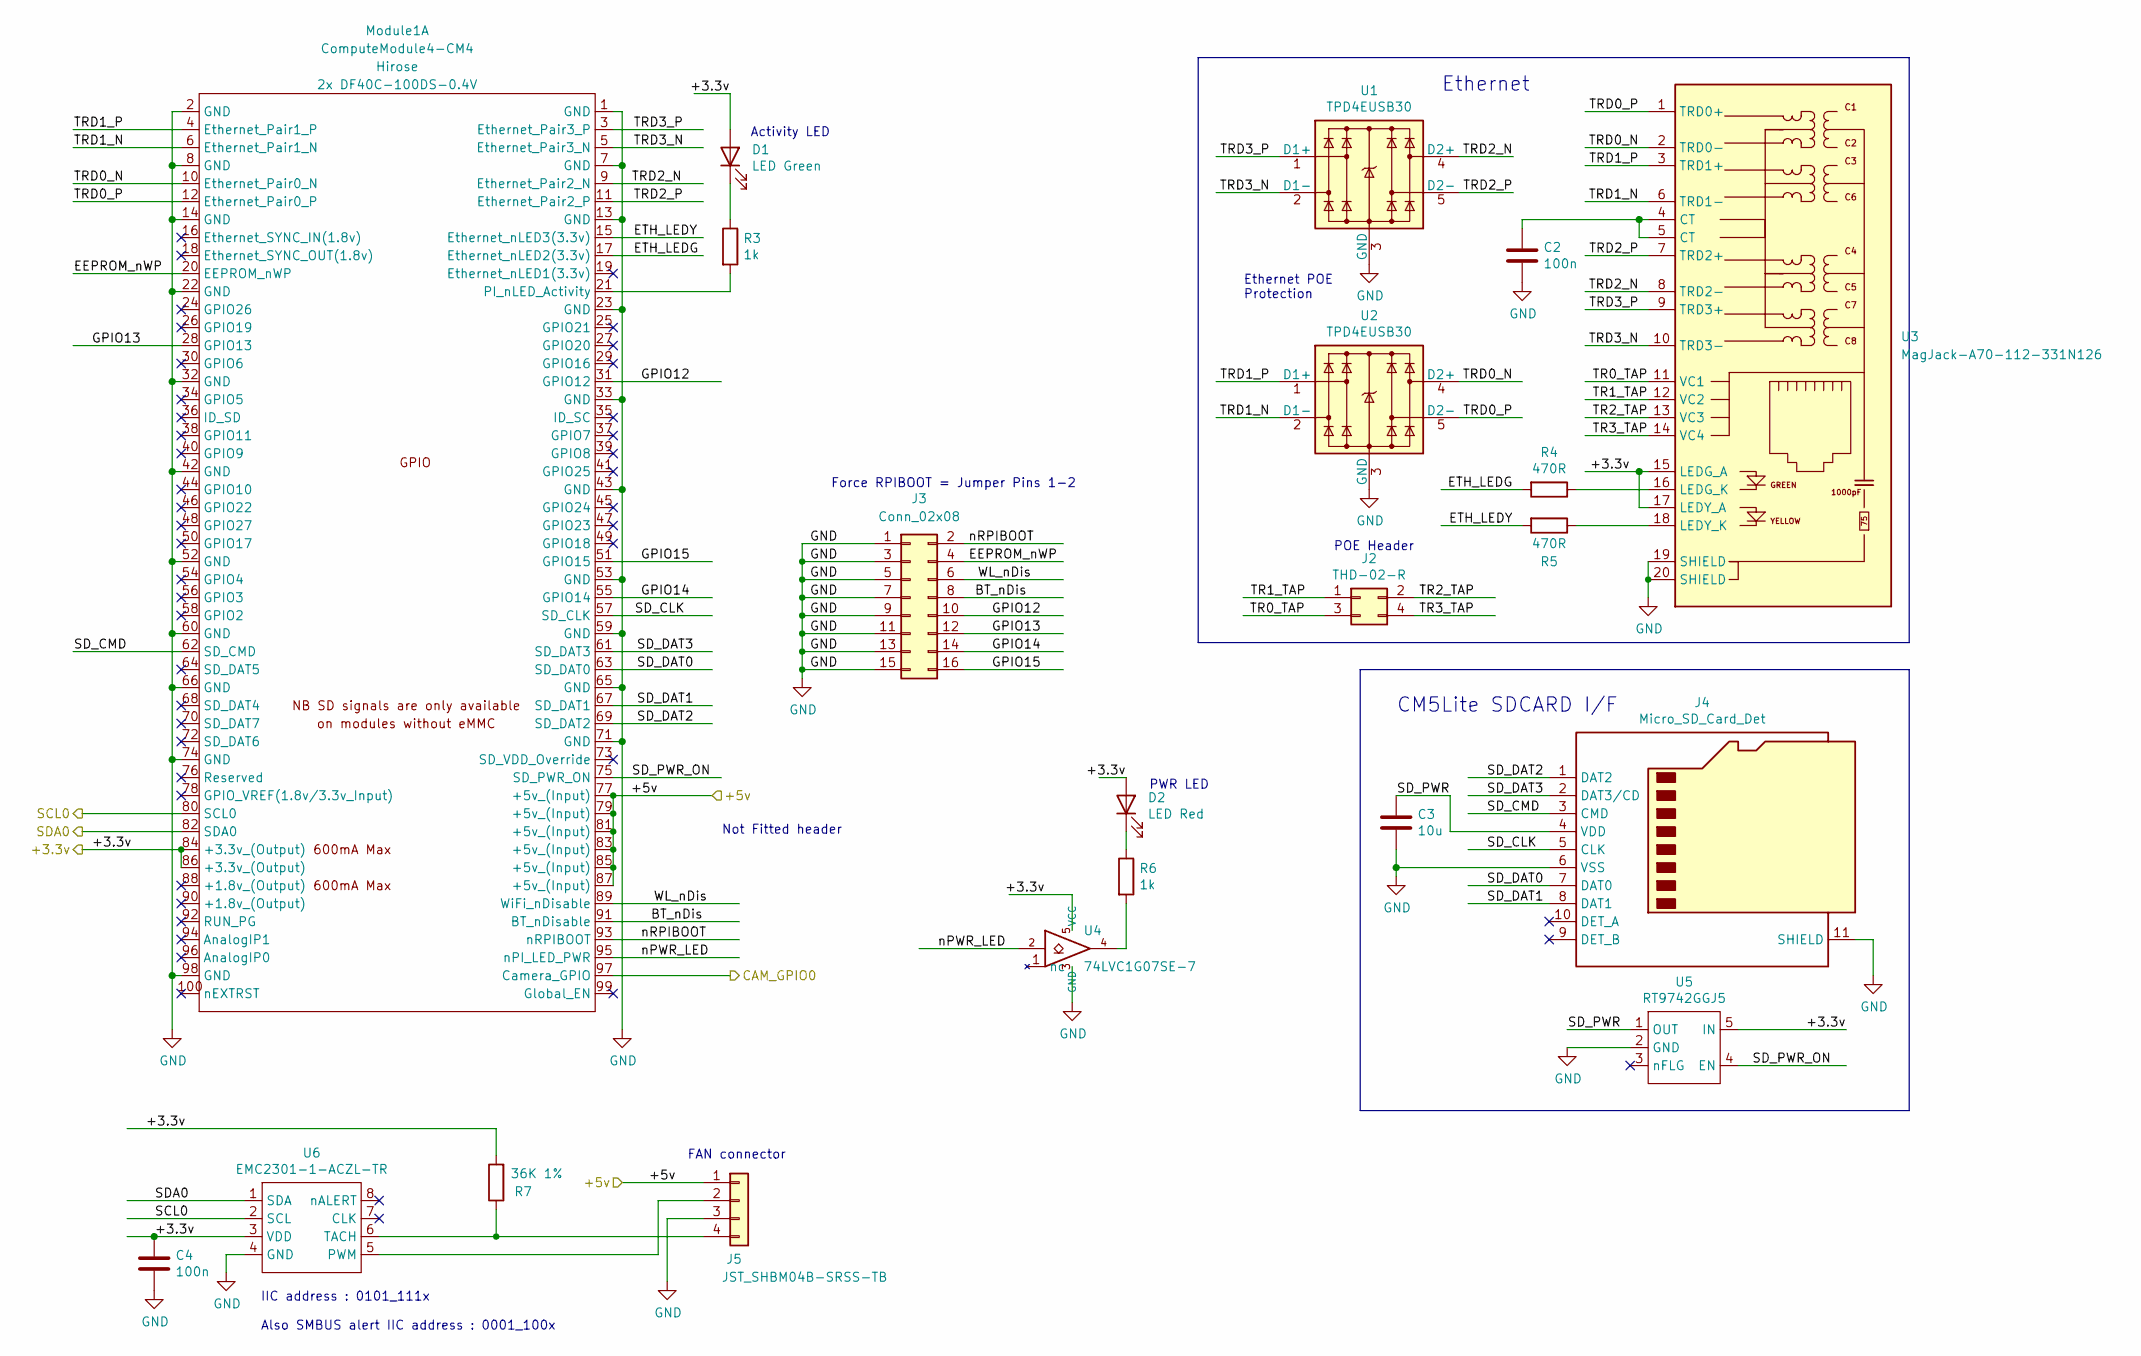
[picture p30: schematic CM5_GPIO.kicad_sch, BLADE CM4 CARRIER BOARD]

Parts:
C2, C4: 100n; C_0402_1005Metric; Part Description 0.1uF 10% 16V Ceramic Capacitor X7R 040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
C3: 10u; C_0805_2012Metric; Part Description 10uF 10% 10V Ceramic Capacitor X7R 0805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
D1: LED Green; LED_0603_1608Metric; Part Description Green 572nm LED Indication - Discrete 2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
D2: LED Red; LED_0603_1608Metric; Part Description Red 620nm LED Indication - Discrete 2.2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
J2: THD-02-R; PinHeader_2x02_P2.54mm_Vertical; Part Description PinHeader_2x02_P2.54mm_Vertical
J3: Conn_02x08; PinHeader_2x08_P2.54mm_Vertical; Part Number 1-1602FBV0T
J4: Micro_SD_Card_Det; SDCARD_MOLEX_503398-1892; Part Description 9 (8 + 1) Position Card Connector micro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
J5: JST_SHBM04B-SRSS-TB; JST_SH_BM04B-SRSS-TB_1x04-1MP_P1.00mm_Vertical; Part Description 4 pin vertical 1mm pitch connector
Module1: ComputeModule4-CM4; Raspberry-Pi-4-Compute-Module
R3, R6: 1k; R_0402_1005Metric; Part Description Resistor 1K M1005 1% 63mW
R4, R5: 470R; R_0402_1005Metric; Part Description Resistor 470R M1005 1% 63mW
R7: 36K 1%; R_0402_1005Metric; Part Description Resistor 36K M1005 1% 63mW
U1, U2: TPD4EUSB30; USON-10_2.5x1.0mm_P0.5mm; Part Description Quad TVS diode for high speed signals (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
U3: MagJack-A70-112-331N126; TRJG0926HENL
U4: 74LVC1G07SE-7; SOT-353_SC-70-5; Part Description Buffer, Non-Inverting 1 Element 1 Bit p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
U5: RT9742GGJ5; SOT-23-5; Part Description Power Switch/Driver 1:1 N-Channel 1A TS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
U6: EMC2301-1-ACZL-TR; MSOP-8_3x3mm_P0.65mm; Part Description Motor Driver PWM 8-MSOP

Connections:
/+3.3v: C4.1, D1.2 (A), D2.2 (A), Module1.84 (+3.3v_(Output)), Module1.86 (+3.3v_(Output)), R7.2, U3.15 (LEDG_A), U3.17 (LEDY_A), U4.5 (VCC), U5.5 (IN), U6.3 (VDD); also elsewhere on the board
/+5v: J5.1, Module1.77 (+5v_(Input)), Module1.79 (+5v_(Input)), Module1.81 (+5v_(Input)), Module1.83 (+5v_(Input)), Module1.85 (+5v_(Input)), Module1.87 (+5v_(Input)); also elsewhere on the board
/CM5_GPIO ( Ethernet, GPIO, SDCARD)/BT_nDis: J3.8 (+12V), Module1.91 (BT_nDisable)
/CM5_GPIO ( Ethernet, GPIO, SDCARD)/CAM_GPIO0: Module1.97 (Camera_GPIO); also elsewhere on the board
/CM5_GPIO ( Ethernet, GPIO, SDCARD)/EEPROM_nWP: J3.4, Module1.20 (EEPROM_nWP)
/CM5_GPIO ( Ethernet, GPIO, SDCARD)/ETH_LEDG: Module1.17 (Ethernet_nLED2(3.3v)), R4.2
/CM5_GPIO ( Ethernet, GPIO, SDCARD)/ETH_LEDY: Module1.15 (Ethernet_nLED3(3.3v)), R5.2
/CM5_GPIO ( Ethernet, GPIO, SDCARD)/GPIO12: J3.10 (GND), Module1.31 (GPIO12)
/CM5_GPIO ( Ethernet, GPIO, SDCARD)/GPIO13: J3.12 (GND), Module1.28 (GPIO13)
/CM5_GPIO ( Ethernet, GPIO, SDCARD)/GPIO14: J3.14 (-12V), Module1.55 (GPIO14)
/CM5_GPIO ( Ethernet, GPIO, SDCARD)/GPIO15: J3.16, Module1.51 (GPIO15)
/CM5_GPIO ( Ethernet, GPIO, SDCARD)/SCL0: Module1.80 (SCL0), U6.2 (SCL); also elsewhere on the board
/CM5_GPIO ( Ethernet, GPIO, SDCARD)/SDA0: Module1.82 (SDA0), U6.1 (SDA); also elsewhere on the board
/CM5_GPIO ( Ethernet, GPIO, SDCARD)/SD_CLK: J4.5 (CLK), Module1.57 (SD_CLK)
/CM5_GPIO ( Ethernet, GPIO, SDCARD)/SD_CMD: J4.3 (CMD), Module1.62 (SD_CMD)
/CM5_GPIO ( Ethernet, GPIO, SDCARD)/SD_DAT0: J4.7 (DAT0), Module1.63 (SD_DAT0)
/CM5_GPIO ( Ethernet, GPIO, SDCARD)/SD_DAT1: J4.8 (DAT1), Module1.67 (SD_DAT1)
/CM5_GPIO ( Ethernet, GPIO, SDCARD)/SD_DAT2: J4.1 (DAT2), Module1.69 (SD_DAT2)
/CM5_GPIO ( Ethernet, GPIO, SDCARD)/SD_DAT3: J4.2 (DAT3/CD), Module1.61 (SD_DAT3)
/CM5_GPIO ( Ethernet, GPIO, SDCARD)/SD_PWR: C3.1, J4.4 (VDD), U5.1 (OUT)
/CM5_GPIO ( Ethernet, GPIO, SDCARD)/SD_PWR_ON: Module1.75 (SD_PWR_ON), U5.4 (EN)
/CM5_GPIO ( Ethernet, GPIO, SDCARD)/TR0_TAP: J2.3, U3.11 (VC1)
/CM5_GPIO ( Ethernet, GPIO, SDCARD)/TR1_TAP: J2.1, U3.12 (VC2)
/CM5_GPIO ( Ethernet, GPIO, SDCARD)/TR2_TAP: J2.2, U3.13 (VC3)
/CM5_GPIO ( Ethernet, GPIO, SDCARD)/TR3_TAP: J2.4, U3.14 (VC4)
/CM5_GPIO ( Ethernet, GPIO, SDCARD)/TRD0_N: Module1.10 (Ethernet_Pair0_N), U2.4 (D2+), U2.7, U3.2 (TRD0-)
/CM5_GPIO ( Ethernet, GPIO, SDCARD)/TRD0_P: Module1.12 (Ethernet_Pair0_P), U2.5 (D2-), U2.6, U3.1 (TRD0+)
/CM5_GPIO ( Ethernet, GPIO, SDCARD)/TRD1_N: Module1.6 (Ethernet_Pair1_N), U2.2 (D1-), U2.9, U3.6 (TRD1-)
/CM5_GPIO ( Ethernet, GPIO, SDCARD)/TRD1_P: Module1.4 (Ethernet_Pair1_P), U2.1 (D1+), U2.10, U3.3 (TRD1+)
/CM5_GPIO ( Ethernet, GPIO, SDCARD)/TRD2_N: Module1.9 (Ethernet_Pair2_N), U1.4 (D2+), U1.7, U3.8 (TRD2-)
/CM5_GPIO ( Ethernet, GPIO, SDCARD)/TRD2_P: Module1.11 (Ethernet_Pair2_P), U1.5 (D2-), U1.6, U3.7 (TRD2+)
/CM5_GPIO ( Ethernet, GPIO, SDCARD)/TRD3_N: Module1.5 (Ethernet_Pair3_N), U1.2 (D1-), U1.9, U3.10 (TRD3-)
/CM5_GPIO ( Ethernet, GPIO, SDCARD)/TRD3_P: Module1.3 (Ethernet_Pair3_P), U1.1 (D1+), U1.10, U3.9 (TRD3+)
/CM5_GPIO ( Ethernet, GPIO, SDCARD)/WL_nDis: J3.6, Module1.89 (WiFi_nDisable)
/CM5_GPIO ( Ethernet, GPIO, SDCARD)/nPWR_LED: Module1.95 (nPI_LED_PWR), U4.2
/CM5_GPIO ( Ethernet, GPIO, SDCARD)/nRPIBOOT: J3.2, Module1.93 (nRPIBOOT)
GND: C2.2, C3.2, C4.2, J3.1, J3.3, J3.5 (+12V), J3.7 (12V), J3.9 (GND), J3.11 (GND), J3.13 (-12), J3.15 (-12V), J4.6 (VSS), J4.11 (SHIELD), J5.3, Module1.1 (GND), Module1.2 (GND), Module1.7 (GND), Module1.8 (GND), Module1.13 (GND), Module1.14 (GND), Module1.22 (GND), Module1.23 (GND), Module1.32 (GND), Module1.33 (GND), Module1.42 (GND), Module1.43 (GND), Module1.52 (GND), Module1.53 (GND), Module1.59 (GND), Module1.60 (GND), Module1.65 (GND), Module1.66 (GND), Module1.71 (GND), Module1.74 (GND), Module1.98 (GND), U1.3 (GND), U1.8 (GND), U2.3 (GND), U2.8 (GND), U3.19 (SHIELD), U3.20 (SHIELD), U4.3 (GND), U5.2 (GND), U6.4 (GND); also elsewhere on the board
unnamed: C2.1, U3.4 (CT), U3.5 (CT)
unnamed: D1.1 (K), R3.1
unnamed: D2.1 (K), R6.1
unnamed: J5.2, U6.5 (PWM)
unnamed: J5.4, R7.1, U6.6 (TACH)
unnamed: Module1.21 (PI_nLED_Activity), R3.2
unnamed: R6.2, U4.4
unnamed: R4.1, U3.16 (LEDG_K)
unnamed: R5.1, U3.18 (LEDY_K)

Notes on the sheet:
FAN connector
Activity LED
Ethernet POE Protection
IIC address : 0101_111x
Also SMBUS alert IIC address : 0001_100x
Not Fitted header
POE Header
Force RPIBOOT = Jumper Pins 1-2
PWR LED
Ethernet
CM5Lite SDCARD I/F

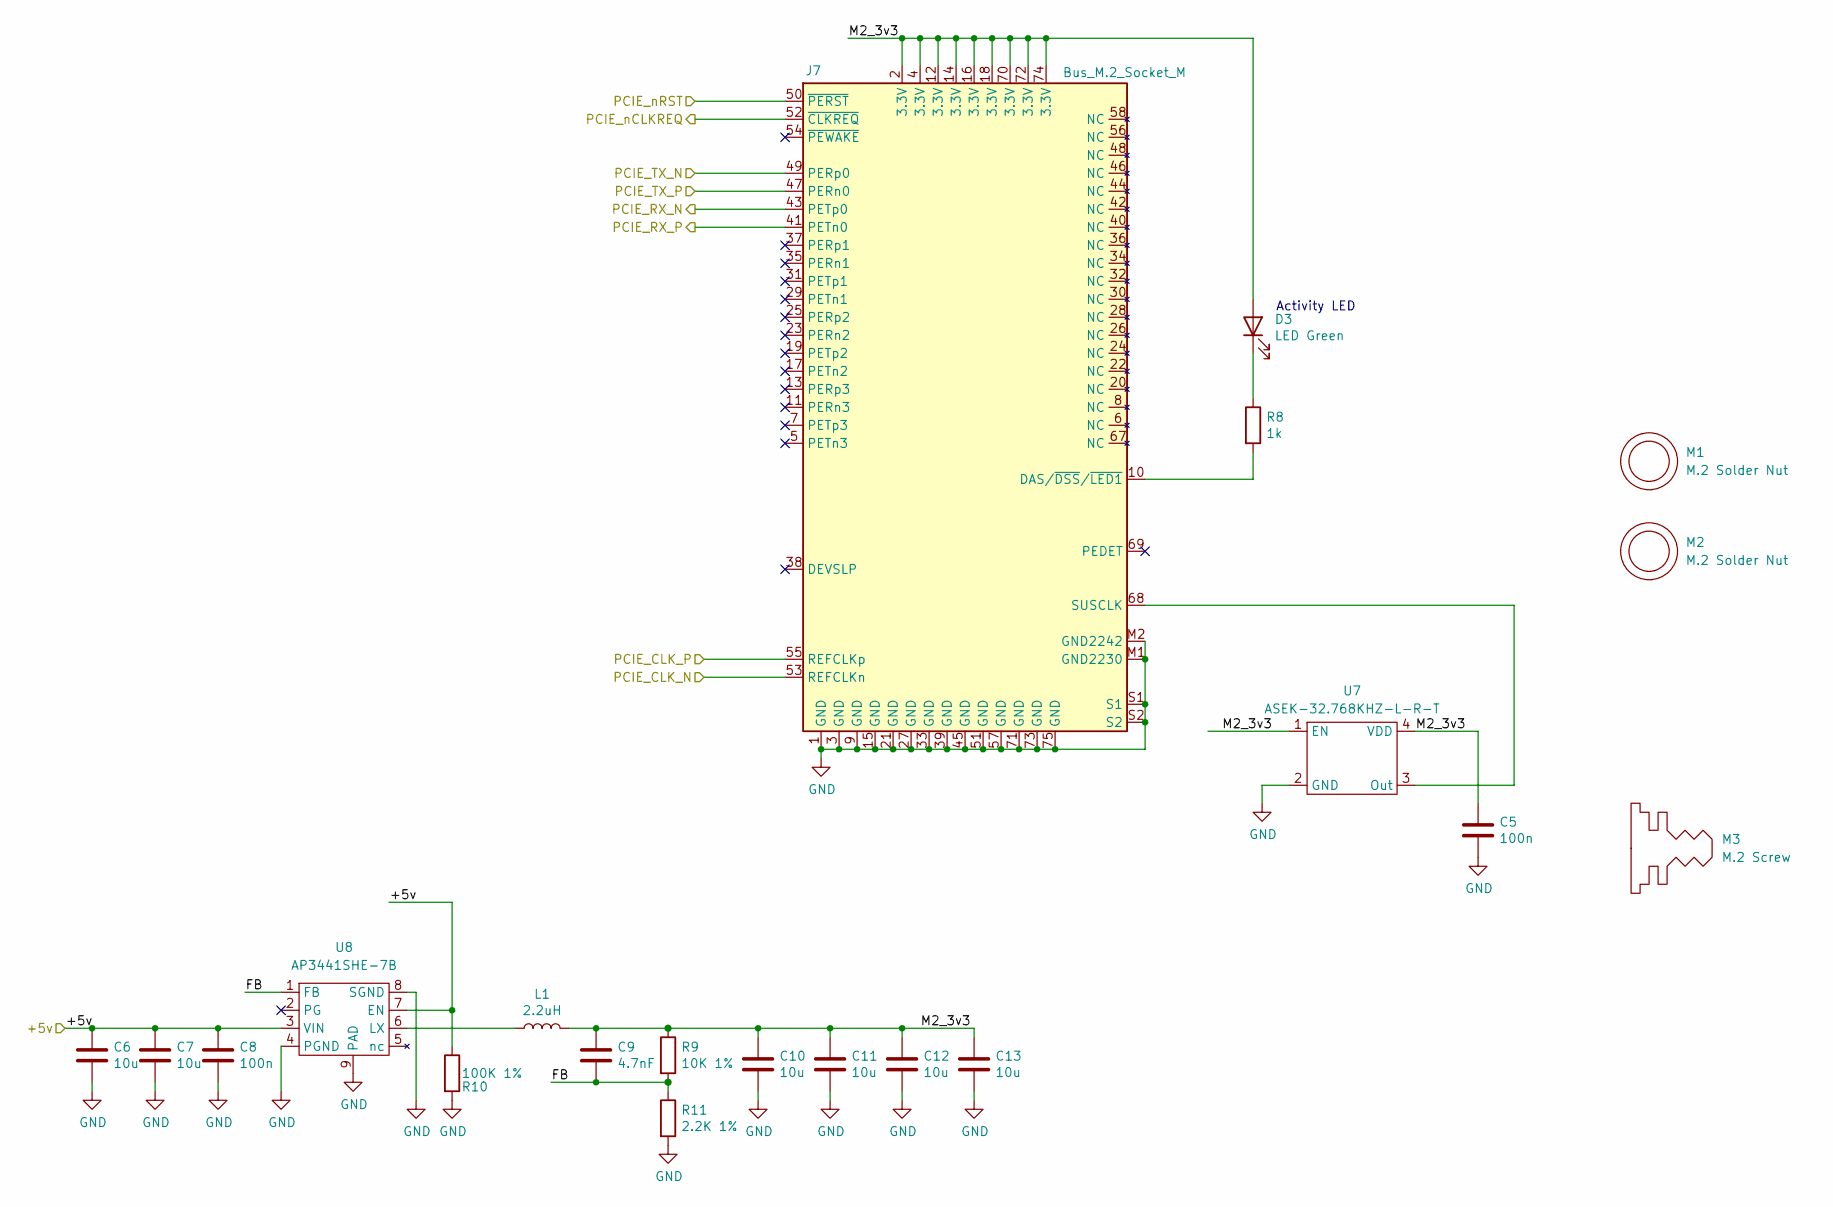
[picture p31: schematic PCIe-M2.kicad_sch, BLADE CM4 CARRIER BOARD]

Parts:
C5, C8: 100n; C_0402_1005Metric; Part Description 0.1uF 10% 16V Ceramic Capacitor X7R 040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
C6, C7, C10, C11, C12, C13: 10u; C_0805_2012Metric; Part Description 10uF 10% 10V Ceramic Capacitor X7R 0805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
C9: 4.7nF; C_0402_1005Metric; Part Description 4.7nF capacitor 0402
D3: LED Green; LED_0603_1608Metric; Part Description Green 572nm LED Indication - Discrete 2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
J7: Bus_M.2_Socket_M; M.2 M Key socket; Part Description M.2 M Key connector
L1: 2.2uH; L_Bourns_SRP5030CC; Part Description Inductor, SMT, 2520, 2u2, IRMS=7A, ISAT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
M1, M2: M.2 Solder Nut; Part Description Solder nut for M.2 slot
M3: M.2 Screw; Part Description M.2 Screw
R8: 1k; R_0402_1005Metric; Part Description Resistor 1K M1005 1% 63mW
R9: 10K 1%; R_0402_1005Metric; Part Description Resistor 10K M1005 1% 63mW
R10: 100K 1%; R_0402_1005Metric; Part Description Resistor 100K M1005 1% 63mW
R11: 2.2K 1%; R_0402_1005Metric; Part Description Resistor 2.2K M1005 1% 63mW
U7: ASEK-32.768KHZ-L-R-T; Crystal_SMD_3225-4Pin_3.2x2.5mm; Part Description 32KHz Xtal oscilator
U8: AP3441SHE-7B; DFN-8-1EP_2x2mm_P0.5mm_EP1.05x1.75mm; Part Description 3A DC-DC converter

Connections:
/+5v: C6.1, C7.1, C8.1, R10.1, U8.3 (VIN), U8.7 (EN); also elsewhere on the board
/CM5_HighSpeed/PCIE_CLK_N: J7.53 (REFCLKn); also elsewhere on the board
/CM5_HighSpeed/PCIE_CLK_P: J7.55 (REFCLKp); also elsewhere on the board
/CM5_HighSpeed/PCIE_RX_N: J7.43 (PETp0); also elsewhere on the board
/CM5_HighSpeed/PCIE_RX_P: J7.41 (PETn0); also elsewhere on the board
/CM5_HighSpeed/PCIE_TX_N: J7.49 (PERp0); also elsewhere on the board
/CM5_HighSpeed/PCIE_TX_P: J7.47 (PERn0); also elsewhere on the board
/CM5_HighSpeed/PCIE_nCLKREQ: J7.52 (~CLKREQ); also elsewhere on the board
/CM5_HighSpeed/PCIE_nRST: J7.50 (~PERST); also elsewhere on the board
/PCIe-M2/FB: C9.2, R9.2, R11.1, U8.1 (FB)
/PCIe-M2/M2_3v3: C5.1, C9.1, C10.1, C11.1, C12.1, C13.1, D3.2 (A), J7.2 (3.3V), J7.4 (3.3V), J7.12 (3.3V), J7.14 (3.3V), J7.16 (3.3V), J7.18 (3.3V), J7.70 (3.3V), J7.72 (3.3V), J7.74 (3.3V), L1.2, R9.1, U7.1 (EN), U7.4 (VDD)
GND: C5.2, C6.2, C7.2, C8.2, C10.2, C11.2, C12.2, C13.2, J7.1 (GND), J7.3 (GND), J7.9 (GND), J7.15 (GND), J7.21 (GND), J7.27 (GND), J7.33 (GND), J7.39 (GND), J7.45 (GND), J7.51 (GND), J7.57 (GND), J7.71 (GND), J7.73 (GND), J7.75 (GND), J7.M1 (GND2230), J7.M2 (GND2242), J7.S1, J7.S2, R10.2, R11.2, U7.2 (GND), U8.4 (PGND), U8.8 (SGND), U8.9 (PAD); also elsewhere on the board
unnamed: D3.1 (K), R8.1
unnamed: J7.10 (DAS/~DSS/~LED1), R8.2
unnamed: J7.68 (SUSCLK), U7.3 (Out)
unnamed: L1.1, U8.6 (LX)

Notes on the sheet:
Activity LED

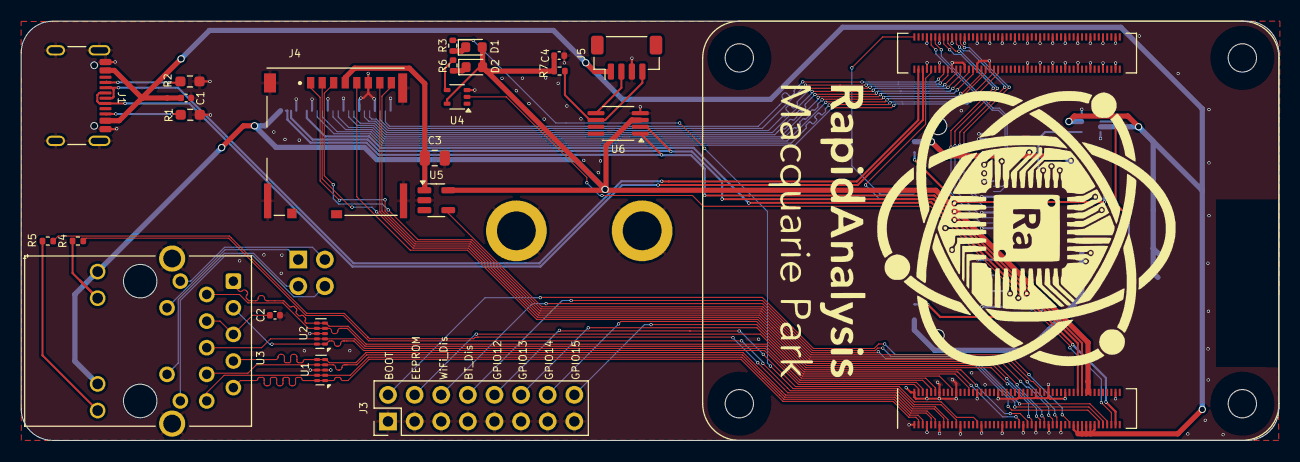
[picture p32: board Blade_v2.kicad_pcb from above]

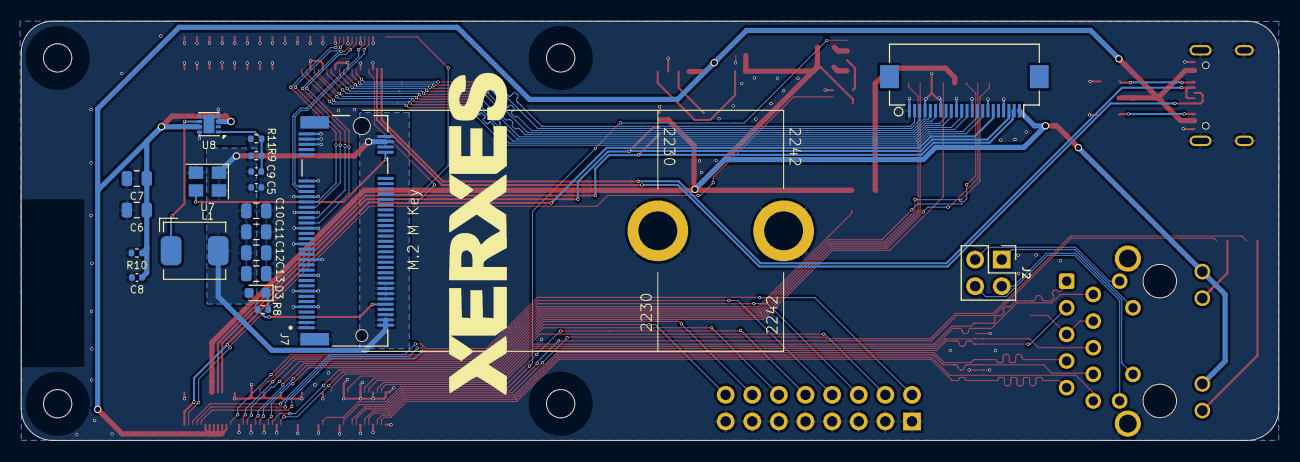
[picture p33: board Blade_v2.kicad_pcb from below]

Board: 2 copper layers, 120.0 x 40.0 mm, 44 parts (20 on the bottom side), 74 nets.
