rapidanalysis/xerxes/Blade/Blade.kicad_pcb

## KiCad design Blade/Blade.kicad_pcb (2025-01-16, an earlier design)

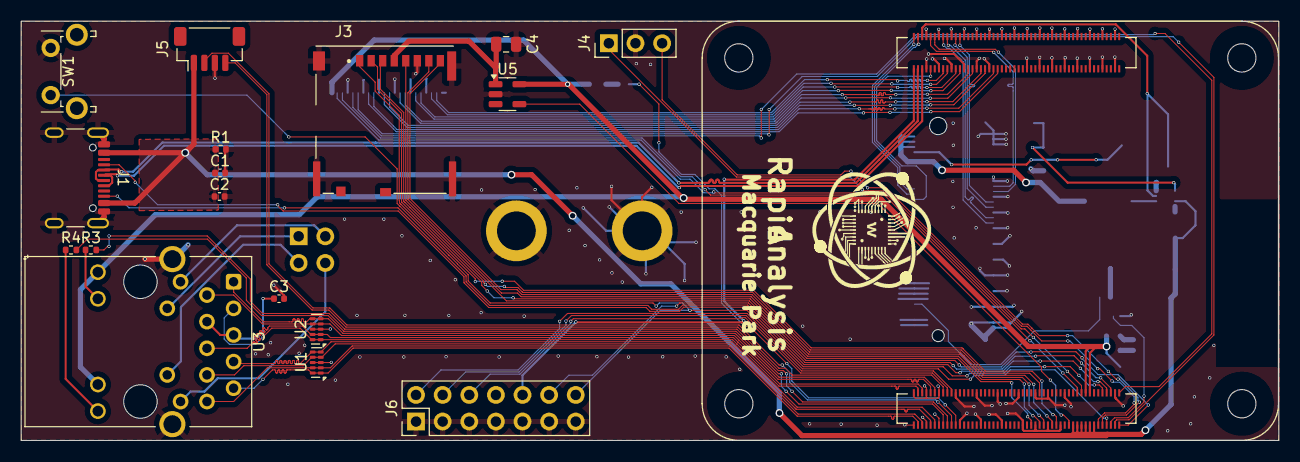
[picture p34: board Blade.kicad_pcb from above]

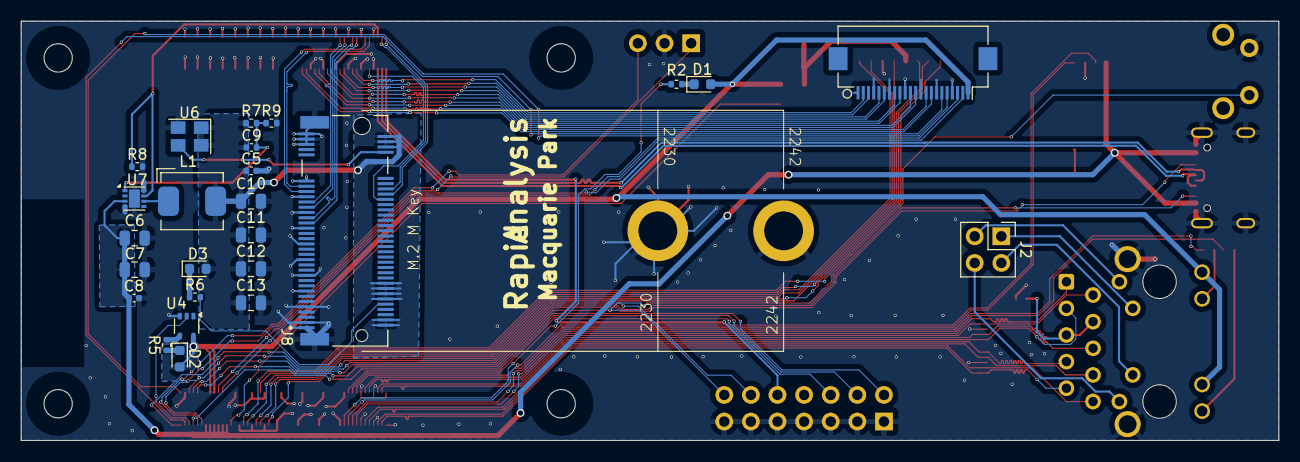
[picture p35: board Blade.kicad_pcb from below]

Board: 2 copper layers, 120.0 x 40.0 mm, 43 parts (25 on the bottom side), 77 nets.

Parts:
C1, C2, C3, C5, C8: 100n; C_0402_1005Metric
C4, C6, C7, C10, C11, C12, C13: 10u; C_0805_2012Metric
C9: 4.7nF; C_0402_1005Metric
D1, D3: LED Green; LED_0603_1608Metric
D2: LED Red; LED_0603_1608Metric
J1: USB_C_Receptacle_USB2.0; USB_C_Receptacle_GCT_USB4105-xx-A_16P_TopMnt_Horizontal
J2: THD-02-R; PinHeader_2x02_P2.54mm_Vertical
J3: Micro_SD_Card_Det; SDCARD_MOLEX_503398-1892
J4: Conn_01x03; PinHeader_1x03_P2.54mm_Vertical
J5: JST_SHBM04B-SRSS-TB; JST_SH_BM04B-SRSS-TB_1x04-1MP_P1.00mm_Vertical
J6: Conn_02x07_Odd_Even; PinHeader_2x07_P2.54mm_Vertical
J7: Conn_01x22_Female; Hirose_FH12-22S-0.5SH_1x22-1MP_P0.50mm_Horizontal
J8: Bus_M.2_Socket_M; M.2 M Key socket
L1: 2.2uH; L_Bourns_SRP5030CC
Module1: ComputeModule5-CM5; Raspberry-Pi-5-Compute-Module
R1, R9: 2.2K 1%; R_0402_1005Metric
R2, R5, R6: 1k; R_0402_1005Metric
R3, R4: 470R; R_0402_1005Metric
R7: 10K 1%; R_0402_1005Metric
R8: 100K 1%; R_0402_1005Metric
SW1: Right angle Tact button; SW_Tactile_SPST_Angled_PTS645Vx58-2LFS
U1, U2: TPD4EUSB30; USON-10_2.5x1.0mm_P0.5mm
U3: MagJack-A70-112-331N126; TRJG0926HENL
U4: 74LVC1G07SE-7; SOT-353_SC-70-5
U5: RT9742GGJ5; SOT-23-5
U6: ASEK-32.768KHZ-L-R-T; Crystal_SMD_3225-4Pin_3.2x2.5mm
U7: AP3441SHE-7B; DFN-8-1EP_2x2mm_P0.5mm_EP1.05x1.75mm

Connections:
/+3.3v: D1.2 (A), D2.2 (A), J7.22, Module1.84 (+3.3v_(Output)), Module1.86 (+3.3v_(Output)), U3.15 (LEDY_A), U3.17 (LEDG_A), U4.5 (VCC), U5.5 (IN)
/+5v: C1.1, C2.1, C6.1, C7.1, C8.1, J1.A4 (VBUS), J1.A9 (VBUS), J1.B4 (VBUS), J1.B9 (VBUS), J5.1, Module1.77 (+5v_(Input)), Module1.79 (+5v_(Input)), Module1.81 (+5v_(Input)), Module1.83 (+5v_(Input)), Module1.85 (+5v_(Input)), Module1.87 (+5v_(Input)), R1.1, U7.3 (VIN)
/CC1: J1.A5 (CC1), Module1.94 (CC1)
/CC2: J1.B5 (CC2), Module1.96 (CC2)
/CM5_GPIO ( Ethernet, GPIO, SDCARD)/BT_nDis: J4.3, Module1.91 (BT_nDisable)
/CM5_GPIO ( Ethernet, GPIO, SDCARD)/CAM_GPIO0: J7.17, Module1.97 (CAM_GPIO0)
/CM5_GPIO ( Ethernet, GPIO, SDCARD)/CAM_GPIO1: J7.18, Module1.100 (CAM_GPIO1)
/CM5_GPIO ( Ethernet, GPIO, SDCARD)/EEPROM_nWP: J6.4, Module1.20 (EEPROM_nWP)
/CM5_GPIO ( Ethernet, GPIO, SDCARD)/ETH_LEDG: Module1.17 (Ethernet_nLED2(3.3v)), R3.2
/CM5_GPIO ( Ethernet, GPIO, SDCARD)/ETH_LEDY: Module1.15 (Ethernet_nLED3(3.3v)), R4.2
/CM5_GPIO ( Ethernet, GPIO, SDCARD)/PMIC_ENABLE: J6.12, Module1.99 (PMIC_ENABLE)
/CM5_GPIO ( Ethernet, GPIO, SDCARD)/PWM: J5.2, Module1.19 (FAN_PWM)
/CM5_GPIO ( Ethernet, GPIO, SDCARD)/PWR_BUT: J6.14, Module1.92 (PWR_BUT), SW1.1
/CM5_GPIO ( Ethernet, GPIO, SDCARD)/SD_CLK: J3.5 (CLK), Module1.57 (SD_CLK)
/CM5_GPIO ( Ethernet, GPIO, SDCARD)/SD_CMD: J3.3 (CMD), Module1.62 (SD_CMD)
/CM5_GPIO ( Ethernet, GPIO, SDCARD)/SD_DAT0: J3.7 (DAT0), Module1.63 (SD_DAT0)
/CM5_GPIO ( Ethernet, GPIO, SDCARD)/SD_DAT1: J3.8 (DAT1), Module1.67 (SD_DAT1)
/CM5_GPIO ( Ethernet, GPIO, SDCARD)/SD_DAT2: J3.1 (DAT2), Module1.69 (SD_DAT2)
/CM5_GPIO ( Ethernet, GPIO, SDCARD)/SD_DAT3: J3.2 (DAT3/CD), Module1.61 (SD_DAT3)
/CM5_GPIO ( Ethernet, GPIO, SDCARD)/SD_PWR: C4.1, J3.4 (VDD), U5.1 (OUT)
/CM5_GPIO ( Ethernet, GPIO, SDCARD)/SD_PWR_ON: Module1.75 (SD_PWR_ON), U5.4 (EN)
/CM5_GPIO ( Ethernet, GPIO, SDCARD)/SYNC_OUT: J6.6, Module1.18 (Ethernet_SYNC_OUT(3.3v))
/CM5_GPIO ( Ethernet, GPIO, SDCARD)/TACHO: J5.4, Module1.16 (FAN_TACHO)
/CM5_GPIO ( Ethernet, GPIO, SDCARD)/TR0_TAP: J2.3, U3.11 (VC1)
/CM5_GPIO ( Ethernet, GPIO, SDCARD)/TR1_TAP: J2.1, U3.12 (VC2)
/CM5_GPIO ( Ethernet, GPIO, SDCARD)/TR2_TAP: J2.2, U3.13 (VC3)
/CM5_GPIO ( Ethernet, GPIO, SDCARD)/TR3_TAP: J2.4, U3.14 (VC4)
/CM5_GPIO ( Ethernet, GPIO, SDCARD)/TRD0_N: Module1.10 (Ethernet_Pair0_N), U2.4 (D2+), U2.7, U3.2 (TRD0-)
/CM5_GPIO ( Ethernet, GPIO, SDCARD)/TRD0_P: Module1.12 (Ethernet_Pair0_P), U2.5 (D2-), U2.6, U3.1 (TRD0+)
/CM5_GPIO ( Ethernet, GPIO, SDCARD)/TRD1_N: Module1.6 (Ethernet_Pair1_N), U2.2 (D1-), U2.9, U3.6 (TRD1-)
/CM5_GPIO ( Ethernet, GPIO, SDCARD)/TRD1_P: Module1.4 (Ethernet_Pair1_P), U2.1 (D1+), U2.10, U3.3 (TRD1+)
/CM5_GPIO ( Ethernet, GPIO, SDCARD)/TRD2_N: Module1.9 (Ethernet_Pair2_N), U1.4 (D2+), U1.7, U3.8 (TRD2-)
/CM5_GPIO ( Ethernet, GPIO, SDCARD)/TRD2_P: Module1.11 (Ethernet_Pair2_P), U1.5 (D2-), U1.6, U3.7 (TRD2+)
/CM5_GPIO ( Ethernet, GPIO, SDCARD)/TRD3_N: Module1.5 (Ethernet_Pair3_N), U1.2 (D1-), U1.9, U3.10 (TRD3-)
/CM5_GPIO ( Ethernet, GPIO, SDCARD)/TRD3_P: Module1.3 (Ethernet_Pair3_P), U1.1 (D1+), U1.10, U3.9 (TRD3+)
/CM5_GPIO ( Ethernet, GPIO, SDCARD)/USBOTG: J6.10, Module1.101 (USB_OTG_ID)
/CM5_GPIO ( Ethernet, GPIO, SDCARD)/WL_nDis: J4.1, Module1.89 (WiFi_nDisable)
/CM5_GPIO ( Ethernet, GPIO, SDCARD)/nPWR_LED: Module1.95 (LED_nPWR), U4.2
/CM5_GPIO ( Ethernet, GPIO, SDCARD)/nRPIBOOT: J6.2, Module1.93 (nRPIBOOT)
/CM5_HighSpeed/DPHY0_C_N: J7.8, Module1.127 (MIPI0_C_N)
/CM5_HighSpeed/DPHY0_C_P: J7.9, Module1.129 (MIPI0_C_P)
/CM5_HighSpeed/DPHY0_D0_N: J7.2, Module1.115 (MIPI0_D0_N)
/CM5_HighSpeed/DPHY0_D0_P: J7.3, Module1.117 (MIPI0_D0_P)
/CM5_HighSpeed/DPHY0_D1_N: J7.5, Module1.121 (MIPI0_D1_N)
/CM5_HighSpeed/DPHY0_D1_P: J7.6, Module1.123 (MIPI0_D1_P)
/CM5_HighSpeed/DPHY0_D2_N: J7.11, Module1.133 (MIPI0_D2_N)
/CM5_HighSpeed/DPHY0_D2_P: J7.12, Module1.135 (MIPI0_D2_P)
/CM5_HighSpeed/DPHY0_D3_N: J7.14, Module1.139 (MIPI0_D3_N)
/CM5_HighSpeed/DPHY0_D3_P: J7.15, Module1.141 (MIPI0_D3_P)
/CM5_HighSpeed/PCIE_CLK_N: J8.53 (REFCLKn), Module1.112 (PCIe_CLK_N)
/CM5_HighSpeed/PCIE_CLK_P: J8.55 (REFCLKp), Module1.110 (PCIe_CLK_P)
/CM5_HighSpeed/PCIE_PWR_EN: Module1.106 (PCIE_PWR_EN), R8.1, U7.7 (EN)
/CM5_HighSpeed/PCIE_RX_N: J8.43 (PETp0), Module1.118 (PCIe_RX_N)
/CM5_HighSpeed/PCIE_RX_P: J8.41 (PETn0), Module1.116 (PCIe_RX_P)
/CM5_HighSpeed/PCIE_TX_N: J8.49 (PERp0), Module1.124 (PCIe_TX_N)
/CM5_HighSpeed/PCIE_TX_P: J8.47 (PERn0), Module1.122 (PCIe_TX_P)
/CM5_HighSpeed/PCIE_nCLKREQ: J8.52 (~CLKREQ), Module1.102 (PCIe_nCLKREQ)
/CM5_HighSpeed/PCIE_nRST: J8.50 (~PERST), Module1.109 (PCIe_nRST)
/CM5_HighSpeed/PCIE_nWAKE: J8.54 (~PEWAKE), Module1.104 (PCIE_nWAKE)
/CM5_HighSpeed/SCL0: J7.20, Module1.80 (SCL0)
/CM5_HighSpeed/SDA0: J7.21, Module1.82 (SDA0)
/PCIe-M2/FB: C9.2, R7.2, R9.1, U7.1 (FB)
/PCIe-M2/M2_3v3: C5.1, C9.1, C10.1, C11.1, C12.1, C13.1, D3.2 (A), J8.2 (3.3V), J8.4 (3.3V), J8.12 (3.3V), J8.14 (3.3V), J8.16 (3.3V), J8.18 (3.3V), J8.70 (3.3V), J8.72 (3.3V), J8.74 (3.3V), L1.2, R7.1, U6.1 (EN), U6.4 (VDD)
/USB2_N: J1.A7 (D-), J1.B7 (D-), Module1.103 (USB2_N)
/USB2_P: J1.A6 (D+), J1.B6 (D+), Module1.105 (USB2_P)
GND: C1.2, C2.2, C3.2, C4.2, C5.2, C6.2, C7.2, C8.2, C10.2, C11.2, C12.2, C13.2, J1.A1 (GND), J1.A12 (GND), J1.B1 (GND), J1.B12 (GND), J1.S1 (SHIELD), J3.6 (VSS), J3.11 (SHIELD), J4.2, J5.3, J6.1, J6.3, J6.5, J6.7, J6.9, J6.11, J6.13, J7.1, J7.4, J7.7, J7.10, J7.13, J7.16, J7.19, J8.1 (GND), J8.3 (GND), J8.9 (GND), J8.15 (GND), J8.21 (GND), J8.27 (GND), J8.33 (GND), J8.39 (GND), J8.45 (GND), J8.51 (GND), J8.57 (GND), J8.71 (GND), J8.73 (GND), J8.75 (GND), J8.M1 (GND2230), J8.M2 (GND2242), J8.S1, J8.S2, Module1.1 (GND), Module1.2 (GND), Module1.7 (GND), Module1.8 (GND), Module1.13 (GND), Module1.14 (GND), Module1.22 (GND), Module1.23 (GND), Module1.32 (GND), Module1.33 (GND), Module1.42 (GND), Module1.43 (GND), Module1.52 (GND), Module1.53 (GND), Module1.59 (GND), Module1.60 (GND), Module1.65 (GND), Module1.66 (GND), Module1.71 (GND), Module1.74 (GND), Module1.98 (GND), Module1.107 (GND), Module1.108 (GND), Module1.113 (GND), Module1.114 (GND), Module1.119 (GND), Module1.120 (GND), Module1.125 (GND), Module1.126 (GND), Module1.131 (GND), Module1.132 (GND), Module1.137 (GND), Module1.138 (GND), Module1.144 (GND), Module1.150 (GND), Module1.155 (GND), Module1.156 (GND), Module1.161 (GND), Module1.162 (GND), Module1.167 (GND), Module1.168 (GND), Module1.173 (GND), Module1.174 (GND), Module1.179 (GND), Module1.180 (GND), Module1.185 (GND), Module1.186 (GND), Module1.191 (GND), Module1.192 (GND), Module1.197 (GND), Module1.198 (GND), R1.2, R8.2, R9.2, SW1.2, U1.3 (GND), U1.8 (GND), U2.3 (GND), U2.8 (GND), U3.19 (SHIELD), U3.20 (SHIELD), U4.3 (GND), U5.2 (GND), U6.2 (GND), U7.4 (PGND), U7.8 (SGND), U7.9 (PAD)
unnamed: C3.1, U3.4 (CT), U3.5 (CT)
unnamed: D1.1 (K), R2.1
unnamed: D2.1 (K), R5.1
unnamed: D3.1 (K), R6.1
unnamed: J8.10 (DAS/~DSS/~LED1), R6.2
unnamed: J8.68 (SUSCLK), U6.3 (Out)
unnamed: Module1.21 (LED_nACT), R2.2
unnamed: R5.2, U4.4
unnamed: R4.1, U3.18 (LEDG_K)
unnamed: R3.1, U3.16 (LEDY_K)
unnamed: L1.1, U7.6 (LX)
