rapidanalysis/xerxes/V1/cm4-bare-minimum.kicad_pcb

## KiCad design V1/cm4-bare-minimum.kicad_pcb (2024-11-23)

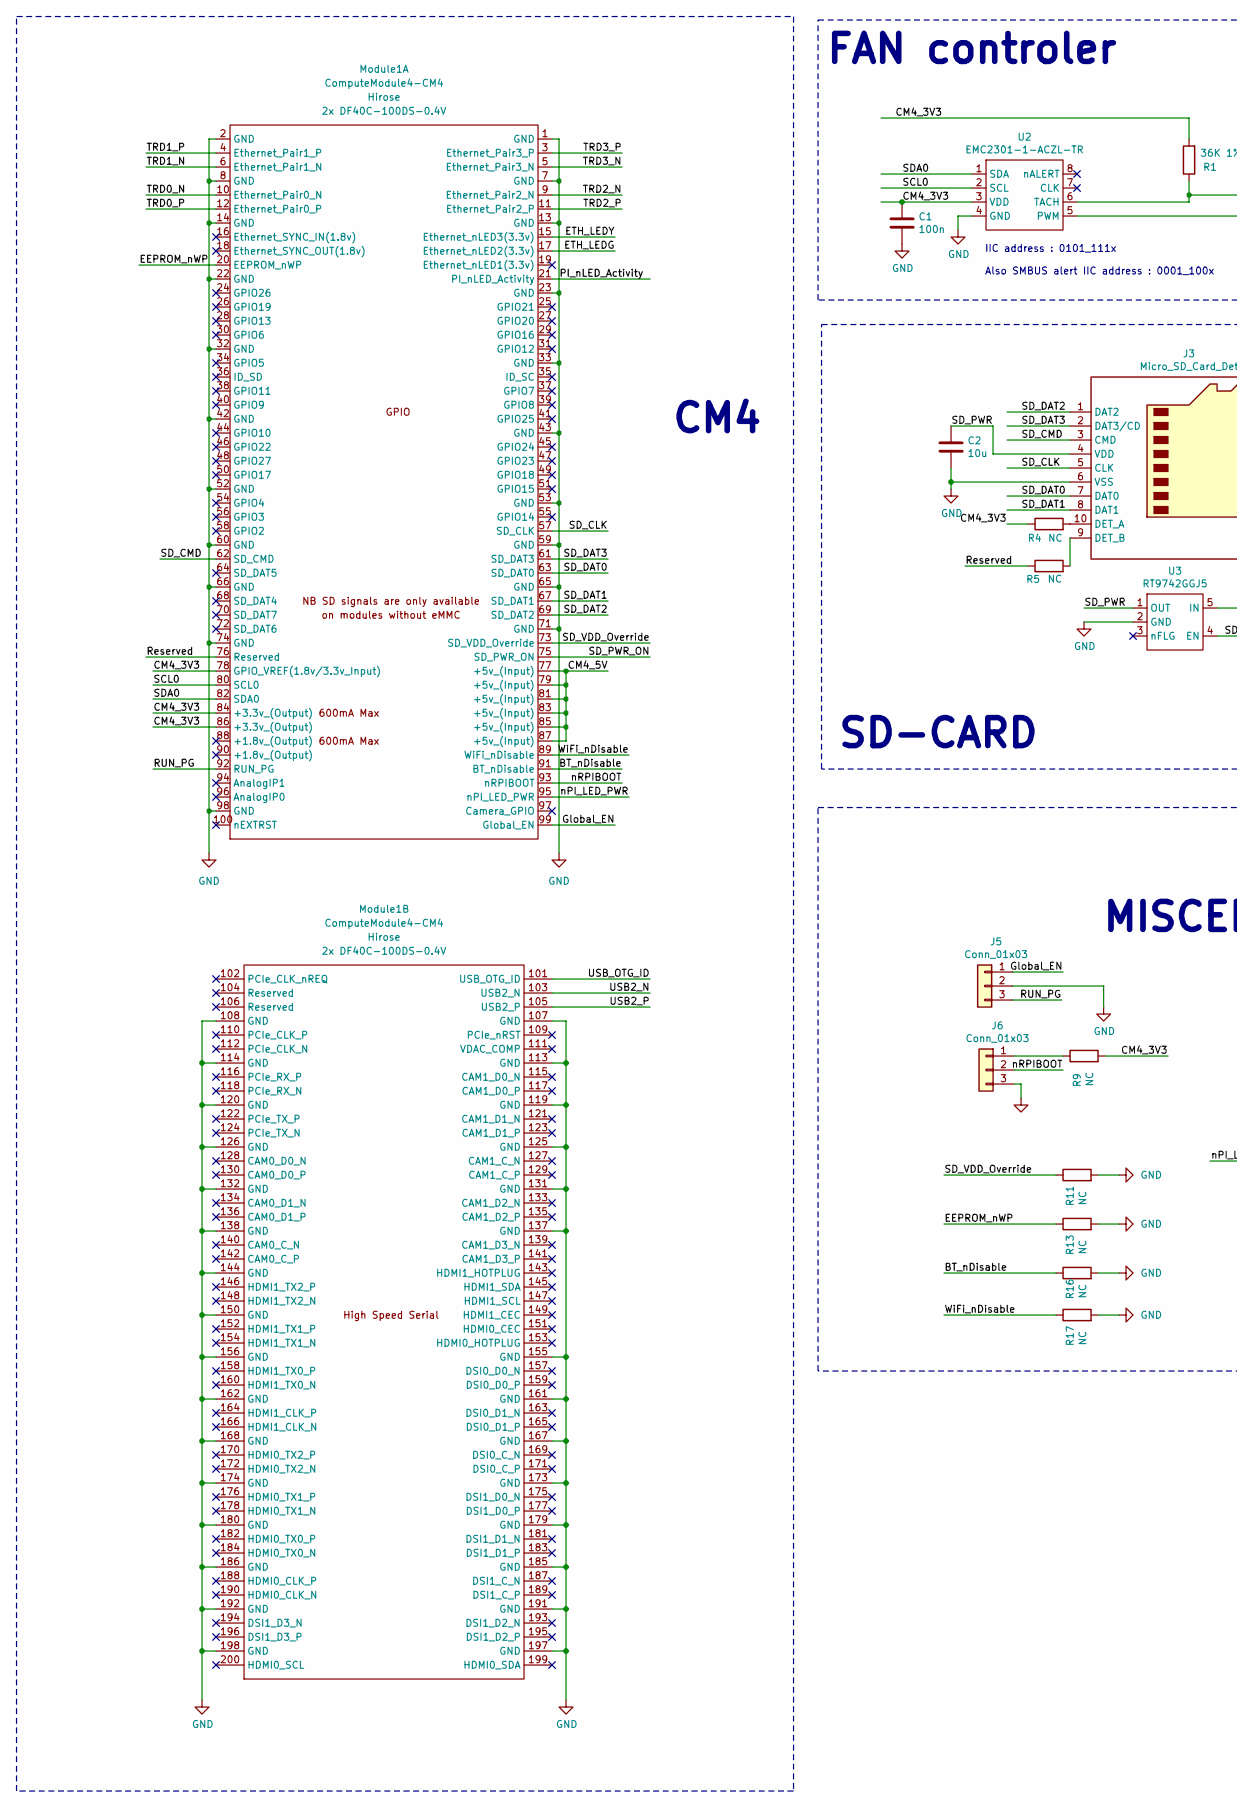
[picture p36: schematic cm4-bare-minimum.kicad_sch, V1 - CM4 Board, part in row 1, column 1]

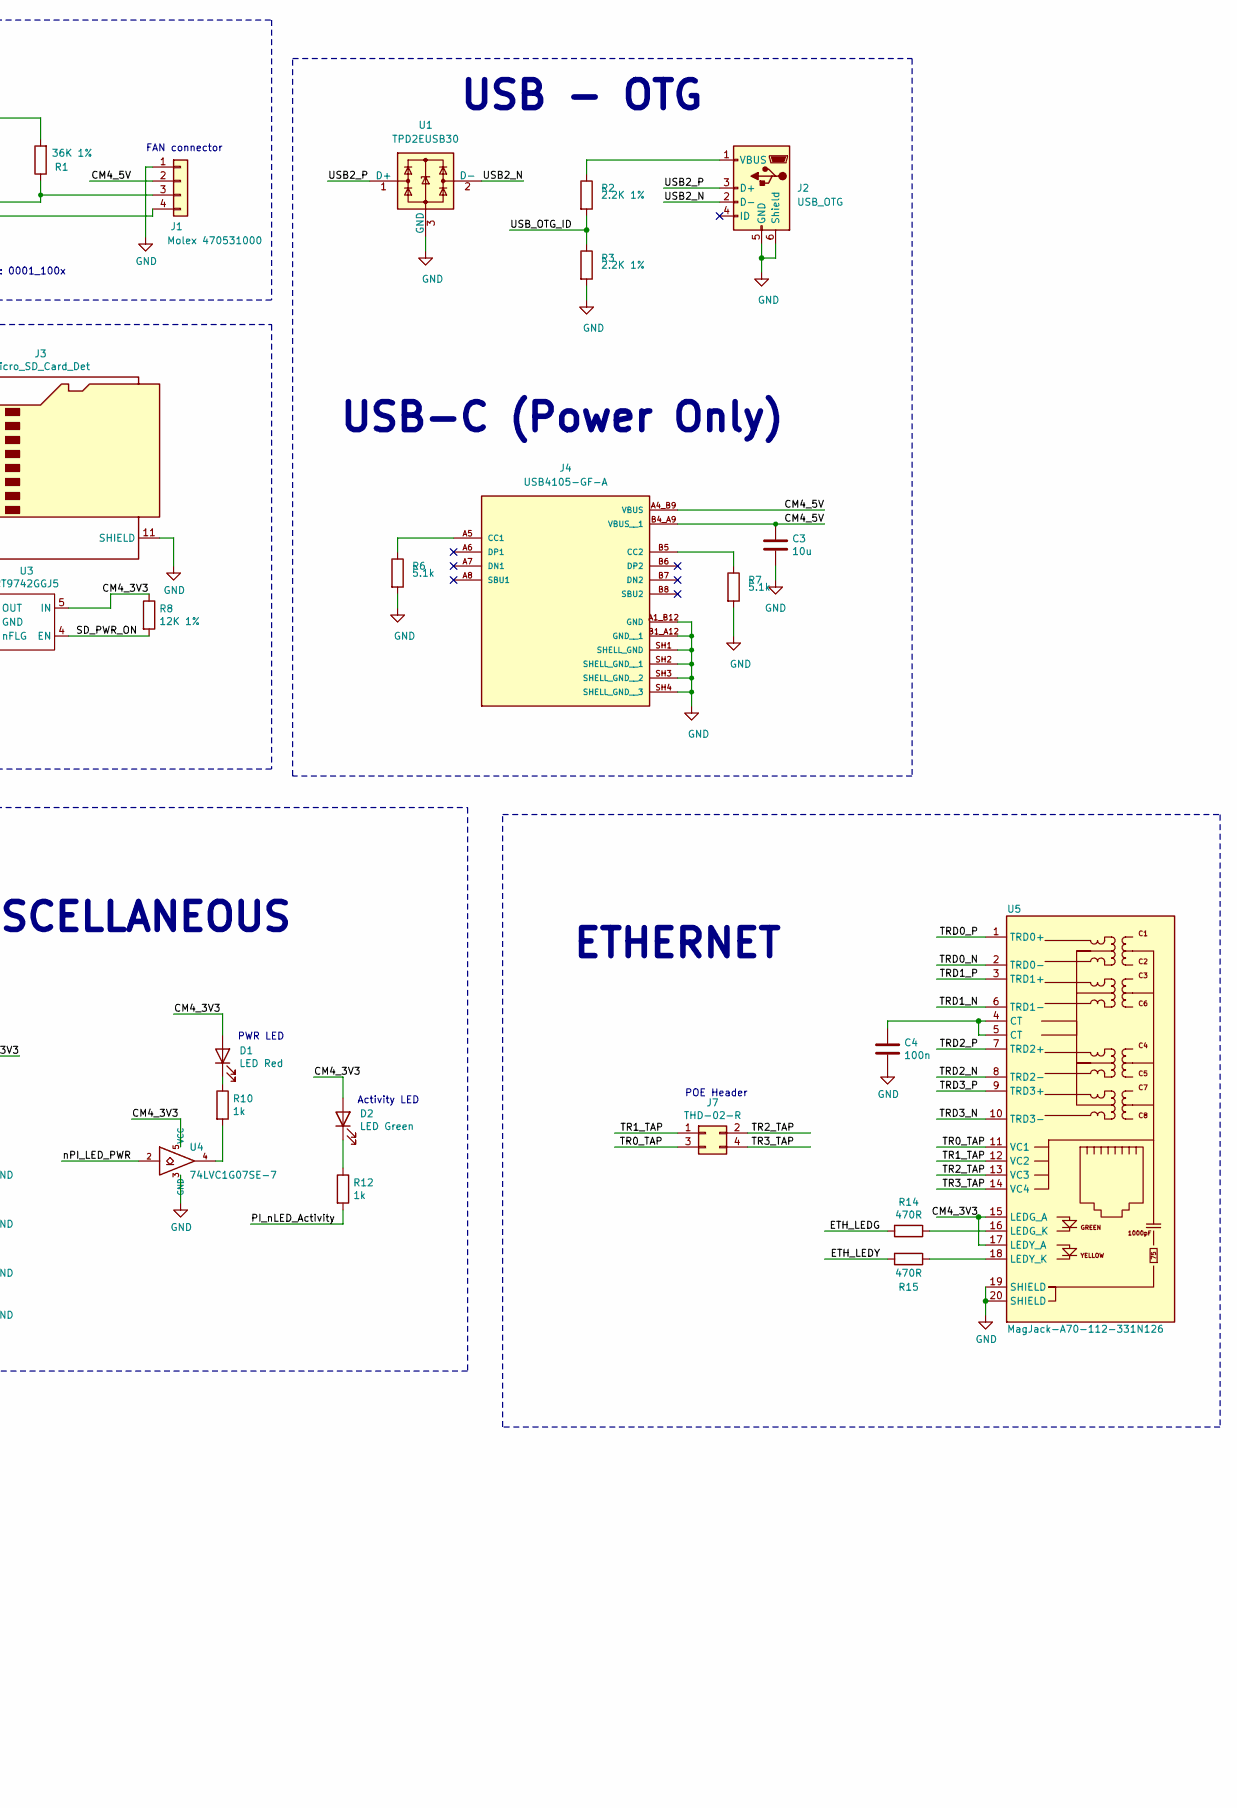
[picture p37: schematic cm4-bare-minimum.kicad_sch, V1 - CM4 Board, part in row 1, column 2]

Parts:
C1, C4: 100n; C_0402_1005Metric; Part Description 0.1uF 10% 16V Ceramic Capacitor X7R 040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
C2, C3: 10u; C_0805_2012Metric; Part Description 10uF 10% 10V Ceramic Capacitor X7R 0805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
D1: LED Red; LED_0603_1608Metric; Part Description Red 620nm LED Indication - Discrete 2.2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
D2: LED Green; LED_0603_1608Metric; Part Description Green 572nm LED Indication - Discrete 2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
J1: Molex 470531000; FanPinHeader_1x04_P2.54mm_Vertical; Part Description Connector Header Through Hole 4 positio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
J2: USB_OTG; USB_Micro-B_EDAC_UCON00686; MPN 10103594-0001LF; Digi-Key_PN 609-4050-1-ND
J3: Micro_SD_Card_Det; SDCARD_MOLEX_503398-1892; Part Description 9 (8 + 1) Position Card Connector micro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
J4: USB4105-GF-A; GCT_USB4105-GF-A; PARTREV B4
J5, J6: Conn_01x03; PinHeader_1x03_P2.54mm_Vertical; Part Description 3pin 0.1" connector
J7: THD-02-R; PinHeader_2x02_P2.54mm_Vertical; Part Description PinHeader_2x02_P2.54mm_Vertical
Module1: ComputeModule4-CM4; Raspberry-Pi-4-Compute-Module
R1: 36K 1%; R_0402_1005Metric; Part Description Resistor 36K M1005 1% 63mW
R2, R3: 2.2K 1%; R_0603_1608Metric_Pad0.98x0.95mm_HandSolder; MPN RC0603FR-072K2L; Digi-Key_PN 311-2.20KHRCT-ND
R4, R5: NC; R_0402_1005Metric; Part Description Resistor 1K M1005 1% 63mW
R6, R7: 5.1k; R_0603_1608Metric_Pad0.98x0.95mm_HandSolder; MPN RC0603FR-075K1L; Digi-Key_PN 311-5.10KHRCT-ND
R8: 12K 1%; R_0402_1005Metric; Part Description Resistor 12K M1005 1% 63mW
R9, R11, R13, R16, R17: NC; R_0402_1005Metric; Part Description Resistor 2.2K M1005 1% 63mW
R10, R12: 1k; R_0402_1005Metric; Part Description Resistor 1K M1005 1% 63mW
R14, R15: 470R; R_0402_1005Metric; Part Description Resistor 470R M1005 1% 63mW
U1: TPD2EUSB30; Texas_DRT-3; MPN TPD2EUSB30DRTR; Digi-Key_PN 296-25509-1-ND
U2: EMC2301-1-ACZL-TR; MSOP-8_3x3mm_P0.65mm; Part Description Motor Driver PWM 8-MSOP
U3: RT9742GGJ5; SOT-23-5; Part Description Power Switch/Driver 1:1 N-Channel 1A TS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
U4: 74LVC1G07SE-7; SOT-353_SC-70-5; Part Description Buffer, Non-Inverting 1 Element 1 Bit p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
U5: MagJack-A70-112-331N126; TRJG0926HENL; Part Description Gigabit Ethernet Magjack

Connections:
/BT_nDisable: Module1.91 (BT_nDisable), R16.1
/CM4_3V3: C1.1, D1.2 (A), D2.2 (A), Module1.78 (GPIO_VREF(1.8v/3.3v_Input)), Module1.84 (+3.3v_(Output)), Module1.86 (+3.3v_(Output)), R1.2, R4.1, R8.1, R9.2, U2.3 (VDD), U3.5 (IN), U4.5 (VCC), U5.15 (LEDG_A), U5.17 (LEDY_A)
/CM4_5V: C3.1, J1.2, J4.A4_B9 (VBUS), J4.B4_A9 (VBUS__1), Module1.77 (+5v_(Input)), Module1.79 (+5v_(Input)), Module1.81 (+5v_(Input)), Module1.83 (+5v_(Input)), Module1.85 (+5v_(Input)), Module1.87 (+5v_(Input))
/EEPROM_nWP: Module1.20 (EEPROM_nWP), R13.1
/ETH_LEDG: Module1.17 (Ethernet_nLED2(3.3v)), R14.2
/ETH_LEDY: Module1.15 (Ethernet_nLED3(3.3v)), R15.2
/Global_EN: J5.1, Module1.99 (Global_EN)
/RUN_PG: J5.3, Module1.92 (RUN_PG)
/Reserved: Module1.76 (Reserved), R5.1
/SCL0: Module1.80 (SCL0), U2.2 (SCL)
/SDA0: Module1.82 (SDA0), U2.1 (SDA)
/SD_CLK: J3.5 (CLK), Module1.57 (SD_CLK)
/SD_CMD: J3.3 (CMD), Module1.62 (SD_CMD)
/SD_DAT0: J3.7 (DAT0), Module1.63 (SD_DAT0)
/SD_DAT1: J3.8 (DAT1), Module1.67 (SD_DAT1)
/SD_DAT2: J3.1 (DAT2), Module1.69 (SD_DAT2)
/SD_DAT3: J3.2 (DAT3/CD), Module1.61 (SD_DAT3)
/SD_PWR: C2.1, J3.4 (VDD), U3.1 (OUT)
/SD_PWR_ON: Module1.75 (SD_PWR_ON), R8.2, U3.4 (EN)
/SD_VDD_Override: Module1.73 (SD_VDD_Override), R11.1
/TR0_TAP: J7.3, U5.11 (VC1)
/TR1_TAP: J7.1, U5.12 (VC2)
/TR2_TAP: J7.2, U5.13 (VC3)
/TR3_TAP: J7.4, U5.14 (VC4)
/TRD0_N: Module1.10 (Ethernet_Pair0_N), U5.2 (TRD0-)
/TRD0_P: Module1.12 (Ethernet_Pair0_P), U5.1 (TRD0+)
/TRD1_N: Module1.6 (Ethernet_Pair1_N), U5.6 (TRD1-)
/TRD1_P: Module1.4 (Ethernet_Pair1_P), U5.3 (TRD1+)
/TRD2_N: Module1.9 (Ethernet_Pair2_N), U5.8 (TRD2-)
/TRD2_P: Module1.11 (Ethernet_Pair2_P), U5.7 (TRD2+)
/TRD3_N: Module1.5 (Ethernet_Pair3_N), U5.10 (TRD3-)
/TRD3_P: Module1.3 (Ethernet_Pair3_P), U5.9 (TRD3+)
/USB2_N: J2.2 (D-), Module1.103 (USB2_N), U1.2 (D-)
/USB2_P: J2.3 (D+), Module1.105 (USB2_P), U1.1 (D+)
/USB_OTG_ID: Module1.101 (USB_OTG_ID), R2.2, R3.1
/WiFi_nDisable: Module1.89 (WiFi_nDisable), R17.1
/nPI_LED_PWR: Module1.95 (nPI_LED_PWR), U4.2
/nRPIBOOT: J6.2, Module1.93 (nRPIBOOT)
unnamed: C4.1, U5.4 (CT), U5.5 (CT)
unnamed: D1.1 (K), R10.1
unnamed: D2.1 (K), R12.1
unnamed: J1.3, R1.1, U2.6 (TACH)
unnamed: J1.4, U2.5 (PWM)
unnamed: J2.1 (VBUS), R2.1
unnamed: J3.10 (DET_A), R4.2
unnamed: J3.9 (DET_B), R5.2
unnamed: J4.A5 (CC1), R6.1
unnamed: J4.B5 (CC2), R7.1
unnamed: J6.1, R9.1
unnamed: R10.2, U4.4
unnamed: R14.1, U5.16 (LEDG_K)
unnamed: R15.1, U5.18 (LEDY_K)

Notes on the sheet:
USB-C (Power Only)
FAN controler
Activity LED
IIC address : 0101_111x
FAN connector
PWR LED
USB - OTG
POE Header
Also SMBUS alert IIC address : 0001_100x
MISCELLANEOUS
ETHERNET
CM4
SD-CARD

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
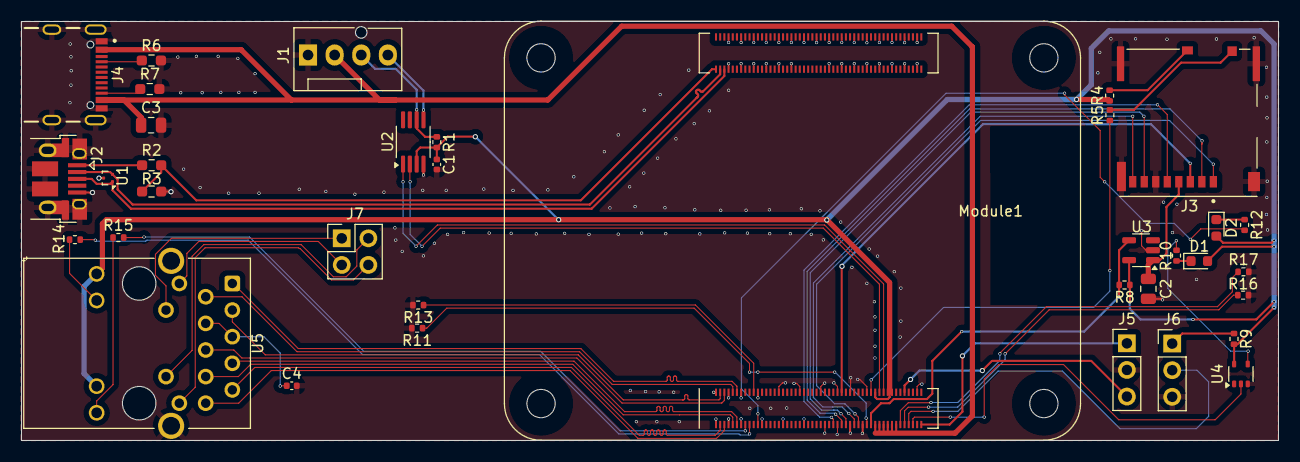
[picture p38: board cm4-bare-minimum.kicad_pcb from above]

Board: 2 copper layers, 120.0 x 40.0 mm, 36 parts (0 on the bottom side), 54 nets.
