rapidanalysis/xerxes/(commit log)

2024-10-25 RPI CM4 Board Template Project
    Contains all bare minimum requirements for the CM4 board. HDMI, USB, SD-Card, OTG power, Ethernet. Clone this repository and make your changes to the template project schematics as required.
    [CM4-Baseline.kicad_pcb, CM4-Baseline.kicad_sch, CM4_GPIO.kicad_sch, CM4_HighSpeed.kicad_sch, PSUs.kicad_sch, RTC.kicad_sch, USB2-HUB.kicad_sch, mSATA.kicad_sch]
2024-10-25 Added Footprint Files
2024-10-25 Updated hierarchy
    [CM4-Baseline.kicad_pcb, CM4-Baseline.kicad_sch, CM4_GPIO.kicad_sch, CM4_HighSpeed.kicad_sch, PSUs.kicad_sch, RTC.kicad_sch, USB2-HUB.kicad_sch, mSATA.kicad_sch]
2024-10-27 PCB Layout Updated
    Shows how much room we have to work with on the PCB.
    [CM4-Baseline.kicad_pcb]
2024-10-31 Added CSI connector and associated library
    [CM4-Baseline.kicad_sch, CM4_HighSpeed.kicad_sch]
2024-11-01 Added New Bare Minimum Project
    Single Sheet Schematic, simplified view, shows only the required modules.
    PCB layout needs to be adjusted and tracks need to be drawn.
    Libraries are in a single directory for ease.
    [cm4-bare-minimum.kicad_pcb, cm4-bare-minimum.kicad_sch]
2024-11-02 Added uSD and support for 2 USB3 schematic
    [484060003.stp, USB3.kicad_sch, cm4-gpio.kicad_sch, cm4-high-speed.kicad_sch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]
2024-11-03 Connector changed, Added Labels.
    Changed HDMI connector to upright. Added labels for included components in schematic.
    To Do: Create tracks in PCB Layout. Add jumper for wifi bluetooth signals.
    [cm4-bare-minimum.kicad_pcb, cm4-bare-minimum.kicad_sch]
2024-11-08 updated V1 bare minimum board
    Initiated pcb layout for V1 board
    [cm4-bare-minimum.kicad_pcb, cm4-bare-minimum.kicad_sch]
2024-11-09 Renamed V1 Requirements project
    [cm4-bare-minimum.kicad_pcb, cm4-bare-minimum.kicad_sch]
2024-11-10 PCB Layout Modified to Nano-ITX
    Added M.2 connector, PSU, updated PCB layout for 120mm x 120mm. Connected GPIO header. Working on remaining component and tracks placement.
    [cm4-bare-minimum.kicad_pcb, cm4-bare-minimum.kicad_sch]
2024-11-10 Updated V1 PCB Layout
    Added Mounting Holes
    [cm4-bare-minimum.kicad_pcb]
2024-11-14 Housekeeping, board size 120mmx40mm
    V1 requirements are fulfilled, Connections are remaining in PCB layout, Performed Cleanup of repo so it only has the V1 Project.
    [484060003.stp, CM4-Baseline.kicad_pcb, CM4-Baseline.kicad_sch, CM4_GPIO.kicad_sch, CM4_HighSpeed.kicad_sch, PSUs.kicad_sch, RTC.kicad_sch, USB2-HUB.kicad_sch]
2024-11-14 Fixed Typo in Schematic
    [cm4-bare-minimum.kicad_sch]
2024-11-15 Updated PCB layout
    [cm4-bare-minimum.kicad_pcb]
2024-11-23 Completed V1, Generated Output Files
    Finished PCB layout, fixed all design rule violations and completed the design. Gerber files, Drill files, Bill of Materials, generated.
    [cm4-bare-minimum.kicad_pcb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]
2024-11-23 Update Drill Report
2024-11-23 Reorganization of Output Files
    Added each Fabrication Output file in its own directory for ease of viewing. Also included schematic drawing in Output.
    [cm4-bare-minimum-B_Cu.gbr, cm4-bare-minimum-B_Mask.gbr, cm4-bare-minimum-B_Paste.gbr, cm4-bare-minimum-B_Silkscreen.gbr, cm4-bare-minimum-Edge_Cuts.gbr, cm4-bare-minimum-F_Cu.gbr, cm4-bare-minimum-F_Mask.gbr, cm4-bare-minimum-F_Paste.gbr]
2024-11-24 Added PCBWay Order Files
    [cm4-bare-minimum.kicad_pcb]
2024-11-24 Update README
    Added Feature Details to README, included images for better viewing.
    [cm4-bare-minimum.kicad_pcb]
2024-12-17 M.2 and CSI integration
    Changed from CM4 to CM5 rails, included M.2 and CSI connectors, added "Rapid Analysis" to silkscreen. Added some thermal management layers. Streamlined the schematic (hierarchical representation)
    [Blade.kicad_pcb, Blade.kicad_sch, CM5_GPIO.kicad_sch, CM5_HighSpeed.kicad_sch, PCIe-M2.kicad_sch]
2024-12-17 Minor corrections to Blade Design
    [Blade.kicad_pcb, Blade.kicad_sch, CM5_GPIO.kicad_sch, CM5_HighSpeed.kicad_sch, PCIe-M2.kicad_sch]
2024-12-17 Sent for production to PCBWay.
    [Blade.kicad_pcb]
2025-01-16 Fixing Blade Carrier Board
    [Blade.kicad_pcb, Blade.kicad_sch, CM5_GPIO.kicad_sch, CM5_HighSpeed.kicad_sch, PCIe-M2.kicad_sch]
2025-01-22 Started Blade V2 project
    Attempt to fix some of the issues with the Blade V1 board. Reverting from CM5 back to CM4. Changing some alignment issues.
    [Blade_v2.kicad_pcb, Blade_v2.kicad_sch, CM5IO.kicad_sch, CM5_GPIO.kicad_sch, CM5_HighSpeed.kicad_sch, PCIe-M2.kicad_sch]
2025-01-25 Blade_v2 Final revision
    [Blade_v2.kicad_pcb, Blade_v2.kicad_sch]
2025-03-04 Blade_V3 Commit
    [Blade_v2.kicad_sch, Blade_v3.kicad_pcb, Blade_v3.kicad_sch]
2025-03-16 Latest Version Commit
    [Blade_v3.kicad_pcb]
2025-03-26 Added POE Daughter Card
    POE Daughter card for attaching AG5405
    [Blade_v4.kicad_pcb, Blade_v4.kicad_sch, POE.kicad_pcb, POE.kicad_sch]
