rapidanalysis/xerxes/(notices)

Notices in the files:
Blade_v2/CM5IO.kicad_sch:
Copyright © 2024 Raspberry Pi Ltd.
parts and their libraries:
Copyright 2016 Accelerated Designs. All rights reserved.
